Mod-queen/examguard-fpga-k230-voice/sim/readme.md

# 模块仿真对应表

共163个不同自检用例。下表按模块逐个进入；模块关联是静态依赖关系，不是代码行或分支覆盖率。

日志和result.json按当前源码关联。[8张原生波形](waveforms.md)附实际WDB来源；各模块另有VCD仿真波形，来源批次见索引。

| 模块 | 当前工程实例化 | 对应自检数 |
| --- | --- | ---: |
| [DVP_Capture](modules/dvp_capture.md) | 是 | 2 |
| [ai_link_rx](modules/ai_link_rx.md) | 是 | 1 |
| [ai_mailbox](modules/ai_mailbox.md) | 是 | 1 |
| [alarm_beep](modules/alarm_beep.md) | 是 | 1 |
| [alarm_output](modules/alarm_output.md) | 否 | 1 |
| [async_fifo](modules/async_fifo.md) | 是 | 19 |
| [axi4_to_fifo](modules/axi4_to_fifo.md) | 否 | 1 |
| [axi_2client_arbiter](modules/axi_2client_arbiter.md) | 是 | 7 |
| [axi_read_burst_buffer](modules/axi_read_burst_buffer.md) | 是 | 5 |
| [board_monitor_record](modules/board_monitor_record.md) | 是 | 3 |
| [board_status_control](modules/board_status_control.md) | 是 | 1 |
| [camera_black_gate](modules/camera_black_gate.md) | 是 | 5 |
| [camera_evidence_client](modules/camera_evidence_client.md) | 否 | 4 |
| [camera_evidence_transport](modules/camera_evidence_transport.md) | 否 | 2 |
| [camera_frame_guard](modules/camera_frame_guard.md) | 否 | 9 |
| [camera_init](modules/camera_init.md) | 是 | 2 |
| [camera_sample_guard](modules/camera_sample_guard.md) | 否 | 6 |
| [camera_time_guard](modules/camera_time_guard.md) | 否 | 4 |
| [candidate_glyph](modules/candidate_glyph.md) | 否 | 3 |
| [candidate_overlay](modules/candidate_overlay.md) | 是 | 3 |
| [cdc_byte_channel](modules/cdc_byte_channel.md) | 否 | 1 |
| [cdc_event_transaction](modules/cdc_event_transaction.md) | 是 | 15 |
| [cdc_exam_status](modules/cdc_exam_status.md) | 是 | 1 |
| [cdc_frame_activity](modules/cdc_frame_activity.md) | 是 | 1 |
| [cdc_stats_snapshot](modules/cdc_stats_snapshot.md) | 是 | 7 |
| [cdc_time_snapshot](modules/cdc_time_snapshot.md) | 是 | 5 |
| [char_rom](modules/char_rom.md) | 否 | 0 |
| [char_rom_cn](modules/char_rom_cn.md) | 是 | 2 |
| [color_enhance](modules/color_enhance.md) | 是 | 2 |
| [config_ack_tx](modules/config_ack_tx.md) | 是 | 2 |
| [config_mailbox](modules/config_mailbox.md) | 是 | 1 |
| [config_rx](modules/config_rx.md) | 否 | 1 |
| [crc32_d8](modules/crc32_d8.md) | 是 | 4 |
| [ddr3_axi_frame_dma](modules/ddr3_axi_frame_dma.md) | 是 | 20 |
| [ddr3_ctrl_2port](modules/ddr3_ctrl_2port.md) | 否 | 0 |
| [ddr3_shared_video_ctrl](modules/ddr3_shared_video_ctrl.md) | 是 | 1 |
| [ddr_evidence_axi](modules/ddr_evidence_axi.md) | 否 | 11 |
| [ddr_evidence_queued](modules/ddr_evidence_queued.md) | 否 | 8 |
| [disp_driver](modules/disp_driver.md) | 是 | 2 |
| [dvi_encoder](modules/dvi_encoder.md) | 是 | 1 |
| [eeprom_dualslot_store](modules/eeprom_dualslot_store.md) | 是 | 6 |
| [eeprom_page_writer](modules/eeprom_page_writer.md) | 是 | 8 |
| [eeprom_record_codec](modules/eeprom_record_codec.md) | 是 | 7 |
| [encode](modules/encode.md) | 是 | 2 |
| [eth_udp_tx_gmii](modules/eth_udp_tx_gmii.md) | 是 | 4 |
| [event_identity](modules/event_identity.md) | 是 | 8 |
| [event_meta_ring](modules/event_meta_ring.md) | 是 | 1 |
| [event_request_fifo](modules/event_request_fifo.md) | 是 | 10 |
| [event_transaction_fork](modules/event_transaction_fork.md) | 是 | 3 |
| [event_transaction_log](modules/event_transaction_log.md) | 是 | 3 |
| [event_transaction_queue](modules/event_transaction_queue.md) | 是 | 7 |
| [evidence_byte_mux](modules/evidence_byte_mux.md) | 是 | 1 |
| [evidence_dump](modules/evidence_dump.md) | 是 | 2 |
| [evidence_epoch_identity](modules/evidence_epoch_identity.md) | 是 | 3 |
| [evidence_event_dispatch](modules/evidence_event_dispatch.md) | 否 | 9 |
| [evidence_health_telemetry](modules/evidence_health_telemetry.md) | 是 | 3 |
| [evidence_packet_cdc](modules/evidence_packet_cdc.md) | 是 | 6 |
| [evidence_packet_udp_bridge](modules/evidence_packet_udp_bridge.md) | 是 | 8 |
| [evidence_reset_barrier](modules/evidence_reset_barrier.md) | 是 | 13 |
| [evidence_window_packetizer](modules/evidence_window_packetizer.md) | 是 | 5 |
| [exam_event_context](modules/exam_event_context.md) | 是 | 3 |
| [exam_fsm](modules/exam_fsm.md) | 是 | 9 |
| [fifo_axi4_adapter](modules/fifo_axi4_adapter.md) | 否 | 0 |
| [fifo_to_axi4](modules/fifo_to_axi4.md) | 否 | 1 |
| [fullscreen_monitor](modules/fullscreen_monitor.md) | 是 | 1 |
| [gmii_to_rgmii](modules/gmii_to_rgmii.md) | 是 | 1 |
| [hc595_driver](modules/hc595_driver.md) | 是 | 1 |
| [health_monitor](modules/health_monitor.md) | 是 | 1 |
| [hex8](modules/hex8.md) | 是 | 1 |
| [history_axi_epoch_guard](modules/history_axi_epoch_guard.md) | 是 | 3 |
| [history_capture_client](modules/history_capture_client.md) | 是 | 1 |
| [history_capture_source](modules/history_capture_source.md) | 是 | 6 |
| [history_closed_scheduler](modules/history_closed_scheduler.md) | 是 | 2 |
| [history_descriptor_reader](modules/history_descriptor_reader.md) | 是 | 8 |
| [history_frame_writer](modules/history_frame_writer.md) | 是 | 6 |
| [history_gap_journal](modules/history_gap_journal.md) | 是 | 5 |
| [history_health_stats](modules/history_health_stats.md) | 是 | 1 |
| [history_lifecycle_control](modules/history_lifecycle_control.md) | 是 | 3 |
| [history_ordered_ingress](modules/history_ordered_ingress.md) | 是 | 3 |
| [history_reference_directory](modules/history_reference_directory.md) | 是 | 9 |
| [history_result_fork](modules/history_result_fork.md) | 是 | 1 |
| [history_result_record](modules/history_result_record.md) | 是 | 4 |
| [history_result_udp_bridge](modules/history_result_udp_bridge.md) | 否 | 2 |
| [history_result_udp_cdc](modules/history_result_udp_cdc.md) | 否 | 1 |
| [history_sample_source](modules/history_sample_source.md) | 是 | 4 |
| [history_scheduled_store](modules/history_scheduled_store.md) | 是 | 2 |
| [history_startup_gate](modules/history_startup_gate.md) | 是 | 2 |
| [history_store_axi](modules/history_store_axi.md) | 是 | 5 |
| [history_stream_cdc](modules/history_stream_cdc.md) | 是 | 3 |
| [history_stream_epoch](modules/history_stream_epoch.md) | 是 | 3 |
| [history_window_reader](modules/history_window_reader.md) | 是 | 6 |
| [i2c_bit_shift](modules/i2c_bit_shift.md) | 是 | 1 |
| [i2c_byte_master](modules/i2c_byte_master.md) | 是 | 9 |
| [i2c_control](modules/i2c_control.md) | 是 | 1 |
| [i2c_register_master](modules/i2c_register_master.md) | 是 | 8 |
| [i2c_transaction_arbiter](modules/i2c_transaction_arbiter.md) | 是 | 5 |
| [image_downsampler](modules/image_downsampler.md) | 否 | 1 |
| [image_evidence_capture](modules/image_evidence_capture.md) | 否 | 1 |
| [image_evidence_ring](modules/image_evidence_ring.md) | 否 | 2 |
| [image_evidence_udp_acx750_tx](modules/image_evidence_udp_acx750_tx.md) | 否 | 0 |
| [image_evidence_udp_packetizer](modules/image_evidence_udp_packetizer.md) | 否 | 2 |
| [image_evidence_udp_source](modules/image_evidence_udp_source.md) | 否 | 1 |
| [image_evidence_udp_tx_bridge](modules/image_evidence_udp_tx_bridge.md) | 否 | 1 |
| [ip_checksum](modules/ip_checksum.md) | 是 | 4 |
| [key_debounce](modules/key_debounce.md) | 是 | 2 |
| [maintenance_command_rx](modules/maintenance_command_rx.md) | 是 | 2 |
| [maintenance_endpoint](modules/maintenance_endpoint.md) | 是 | 2 |
| [maintenance_record](modules/maintenance_record.md) | 是 | 3 |
| [mdio_bit_shift](modules/mdio_bit_shift.md) | 是 | 2 |
| [motion_detect](modules/motion_detect.md) | 是 | 1 |
| [ov5640_ddr3_hdmi_vga](modules/ov5640_ddr3_hdmi_vga.md) | 否 | 0 |
| [ov5640_init_table_jpeg](modules/ov5640_init_table_jpeg.md) | 否 | 2 |
| [ov5640_init_table_rgb](modules/ov5640_init_table_rgb.md) | 是 | 2 |
| [ov7725_init_table_rgb](modules/ov7725_init_table_rgb.md) | 否 | 2 |
| [overlay_status](modules/overlay_status.md) | 是 | 1 |
| [pcf8563_calendar](modules/pcf8563_calendar.md) | 否 | 10 |
| [pcf8563_reader](modules/pcf8563_reader.md) | 是 | 9 |
| [pcf8563_setter](modules/pcf8563_setter.md) | 是 | 4 |
| [persistent_boot_gate](modules/persistent_boot_gate.md) | 是 | 5 |
| [persistent_boot_service](modules/persistent_boot_service.md) | 否 | 1 |
| [persistent_config_decode](modules/persistent_config_decode.md) | 是 | 4 |
| [persistent_config_manager](modules/persistent_config_manager.md) | 是 | 3 |
| [persistent_event_identity](modules/persistent_event_identity.md) | 是 | 2 |
| [persistent_maintenance_service](modules/persistent_maintenance_service.md) | 是 | 2 |
| [persistent_rtc_service](modules/persistent_rtc_service.md) | 否 | 1 |
| [phy_health_snapshot](modules/phy_health_snapshot.md) | 是 | 1 |
| [phy_reg_config](modules/phy_reg_config.md) | 是 | 1 |
| [pulse_cdc](modules/pulse_cdc.md) | 是 | 1 |
| [rtc_anchor_client](modules/rtc_anchor_client.md) | 是 | 5 |
| [rtc_anchor_record](modules/rtc_anchor_record.md) | 是 | 7 |
| [rtc_time_anchor](modules/rtc_time_anchor.md) | 是 | 6 |
| [serdes_4b_10to1](modules/serdes_4b_10to1.md) | 是 | 2 |
| [shared_xadc_monitor](modules/shared_xadc_monitor.md) | 是 | 1 |
| [sim_dat_gen](modules/sim_dat_gen.md) | 否 | 0 |
| [status_mailbox](modules/status_mailbox.md) | 是 | 1 |
| [status_uart_tx](modules/status_uart_tx.md) | 是 | 4 |
| [text_overlay](modules/text_overlay.md) | 是 | 2 |
| [timestamp_ms](modules/timestamp_ms.md) | 是 | 1 |
| [u32_to_bcd](modules/u32_to_bcd.md) | 是 | 5 |
| [uart_packet_mux](modules/uart_packet_mux.md) | 是 | 4 |
| [uart_rx](modules/uart_rx.md) | 是 | 1 |
| [uart_stream_adapter](modules/uart_stream_adapter.md) | 是 | 7 |
| [uart_tx](modules/uart_tx.md) | 是 | 12 |
| [user_control](modules/user_control.md) | 是 | 1 |
| [video_axi_client](modules/video_axi_client.md) | 是 | 7 |
| [video_epoch_clear](modules/video_epoch_clear.md) | 是 | 7 |
| [video_fifo_axi_port](modules/video_fifo_axi_port.md) | 是 | 4 |
| [video_fifo_stream_bridge](modules/video_fifo_stream_bridge.md) | 是 | 6 |
| [video_memory_fabric](modules/video_memory_fabric.md) | 是 | 4 |
| [voice_announcer](modules/voice_announcer.md) | 否 | 1 |
| [voice_asr_i2c](modules/voice_asr_i2c.md) | 否 | 1 |
| [voice_audio_gate](modules/voice_audio_gate.md) | 是 | 2 |
| [voice_command_map](modules/voice_command_map.md) | 否 | 1 |
| [voice_exam_interaction](modules/voice_exam_interaction.md) | 是 | 2 |
| [voice_host_endpoint](modules/voice_host_endpoint.md) | 是 | 2 |
| [voice_info_confirm](modules/voice_info_confirm.md) | 是 | 3 |
| [voice_interaction_bus](modules/voice_interaction_bus.md) | 是 | 2 |
| [voice_interaction_system](modules/voice_interaction_system.md) | 是 | 1 |
| [voice_notice_queue](modules/voice_notice_queue.md) | 是 | 2 |
| [voice_status_record](modules/voice_status_record.md) | 是 | 2 |
| [workflow_fsm](modules/workflow_fsm.md) | 否 | 1 |
| [xadc_monitor_reader](modules/xadc_monitor_reader.md) | 是 | 2 |
| [display_output_pipeline](modules/display_output_pipeline.md) | 是 | 2 |
