Mod-queen/examguard-fpga-k230-voice/sim/modules/i2c_byte_master.md

# i2c_byte_master

当前工程实例化：是。关联9个自检用例。

| 用例 | 仿真器 | 当前结果 | 运行日志 | 结果记录 |
| --- | --- | --- | --- | --- |
| i2c_byte_master_tb | icarus | 通过 | [日志](../../sim/results/quality_current/i2c_byte_master_tb/run.log) | [记录](../../sim/results/quality_current/i2c_byte_master_tb/result.json) |
| i2c_register_master_tb | icarus | 通过 | [日志](../../sim/results/quality_current/i2c_register_master_tb/run.log) | [记录](../../sim/results/quality_current/i2c_register_master_tb/result.json) |
| maintenance_system_tb | xsim | 通过 | [日志](../../sim/results/quality_current/maintenance_system_tb/run.log) | [记录](../../sim/results/quality_current/maintenance_system_tb/result.json) |
| pcf8563_setter_wire_tb | icarus | 通过 | [日志](../../sim/results/quality_current/pcf8563_setter_wire_tb/run.log) | [记录](../../sim/results/quality_current/pcf8563_setter_wire_tb/result.json) |
| persistent_boot_probe_tb | xsim | 通过 | [日志](../../sim/results/quality_current/persistent_boot_probe_tb/run.log) | [记录](../../sim/results/quality_current/persistent_boot_probe_tb/result.json) |
| persistent_boot_service_tb | xsim | 通过 | [日志](../../sim/results/quality_current/persistent_boot_service_tb/run.log) | [记录](../../sim/results/quality_current/persistent_boot_service_tb/result.json) |
| persistent_maintenance_service_tb | icarus | 通过 | [日志](../../sim/results/quality_current/persistent_maintenance_service_tb/run.log) | [记录](../../sim/results/quality_current/persistent_maintenance_service_tb/result.json) |
| voice_interaction_bus_tb | icarus | 通过 | [日志](../../sim/results/quality_current/voice_interaction_bus_tb/run.log) | [记录](../../sim/results/quality_current/voice_interaction_bus_tb/result.json) |
| voice_interaction_system_tb | xsim | 通过 | [日志](../../sim/results/quality_current/voice_interaction_system_tb/run.log) | [记录](../../sim/results/quality_current/voice_interaction_system_tb/result.json) |

单独重跑本模块关联用例（工程根目录）：

```powershell
python sim/run_module_tests.py --only i2c_byte_master_tb i2c_register_master_tb maintenance_system_tb pcf8563_setter_wire_tb persistent_boot_probe_tb persistent_boot_service_tb persistent_maintenance_service_tb voice_interaction_bus_tb voice_interaction_system_tb --vivado-bin "$env:EXAMGUARD_VIVADO_BIN" --iverilog-bin "$env:EXAMGUARD_IVERILOG_BIN"
```

先按[复原说明](../../build/reproduction.md)配置工具。每次生成新的结果目录。

## i2c_byte_master_tb

用例源码：[i2c_byte_master_tb.sv](../../sim/sources/persistence/i2c_byte_master_tb.sv)

VCD仿真波形（来源批次见索引）：

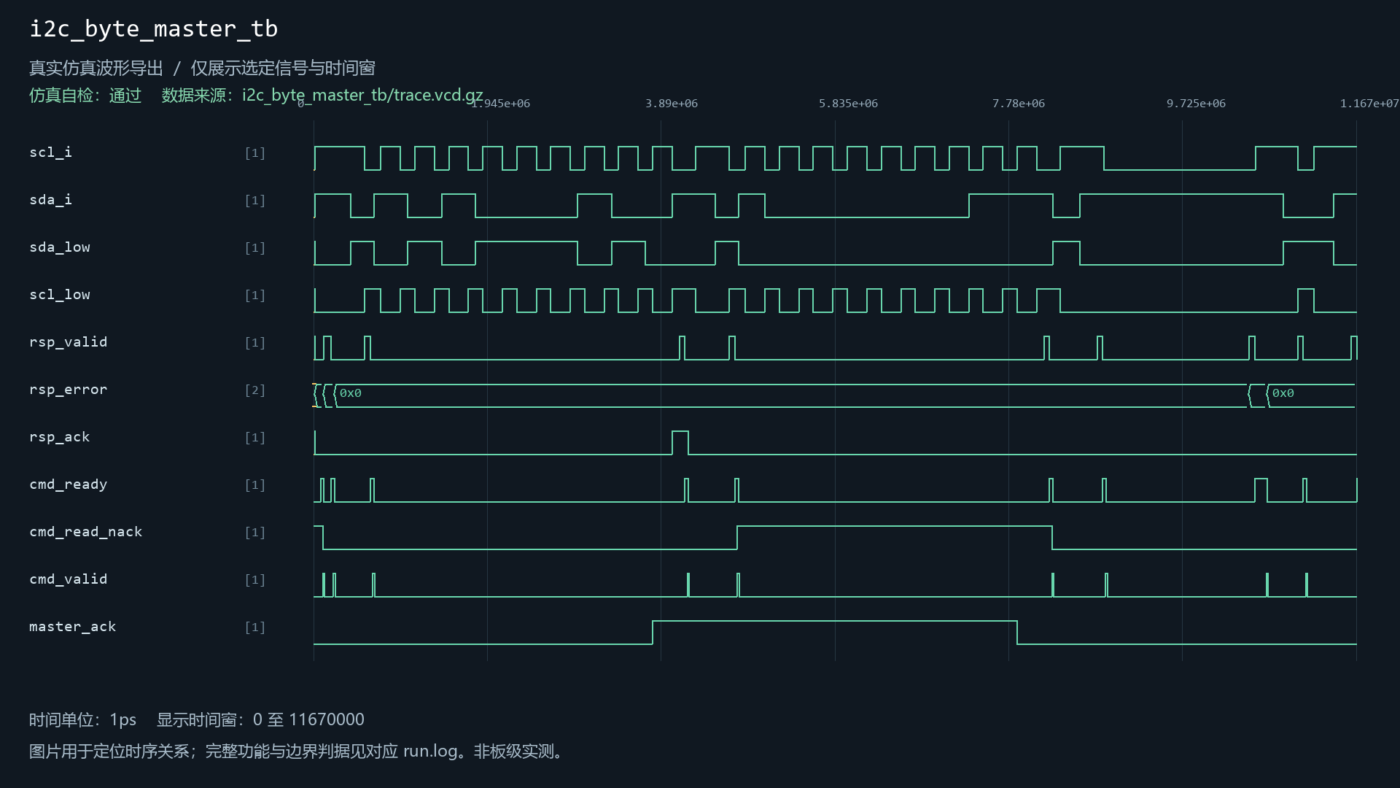
[picture p60: sim/images/i2c_byte_master_tb.png]
i2c_byte_master_tb


## i2c_register_master_tb

用例源码：[i2c_register_master_tb.sv](../../sim/sources/persistence/i2c_register_master_tb.sv), [persistence_inventory_probe.sv](../../sim/sources/persistence/persistence_inventory_probe.sv)

VCD仿真波形（来源批次见索引）：

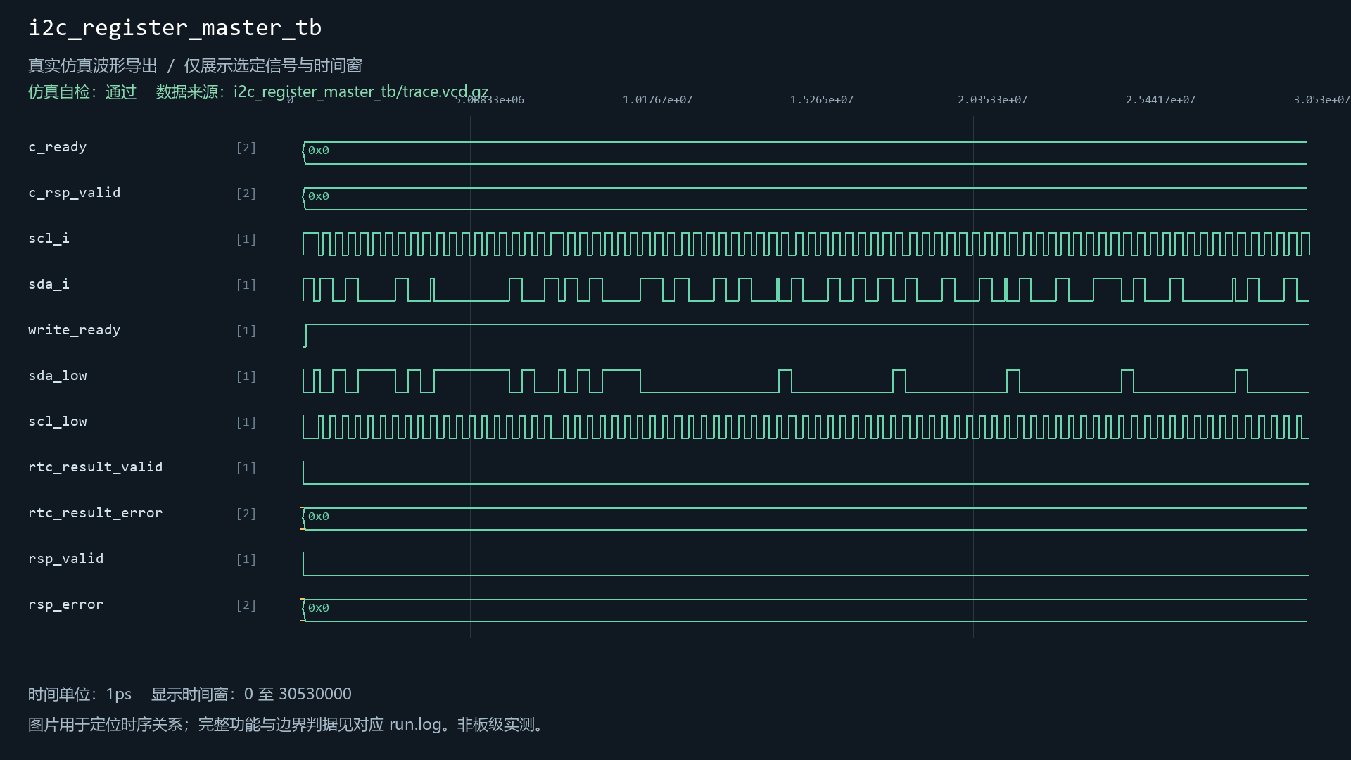
[picture p61: sim/images/i2c_register_master_tb.png]
i2c_register_master_tb


## maintenance_system_tb

用例源码：[maintenance_system_tb.sv](../../sim/test_repairs/maintenance_system_tb/maintenance_system_tb.sv)

VCD仿真波形（来源批次见索引）：

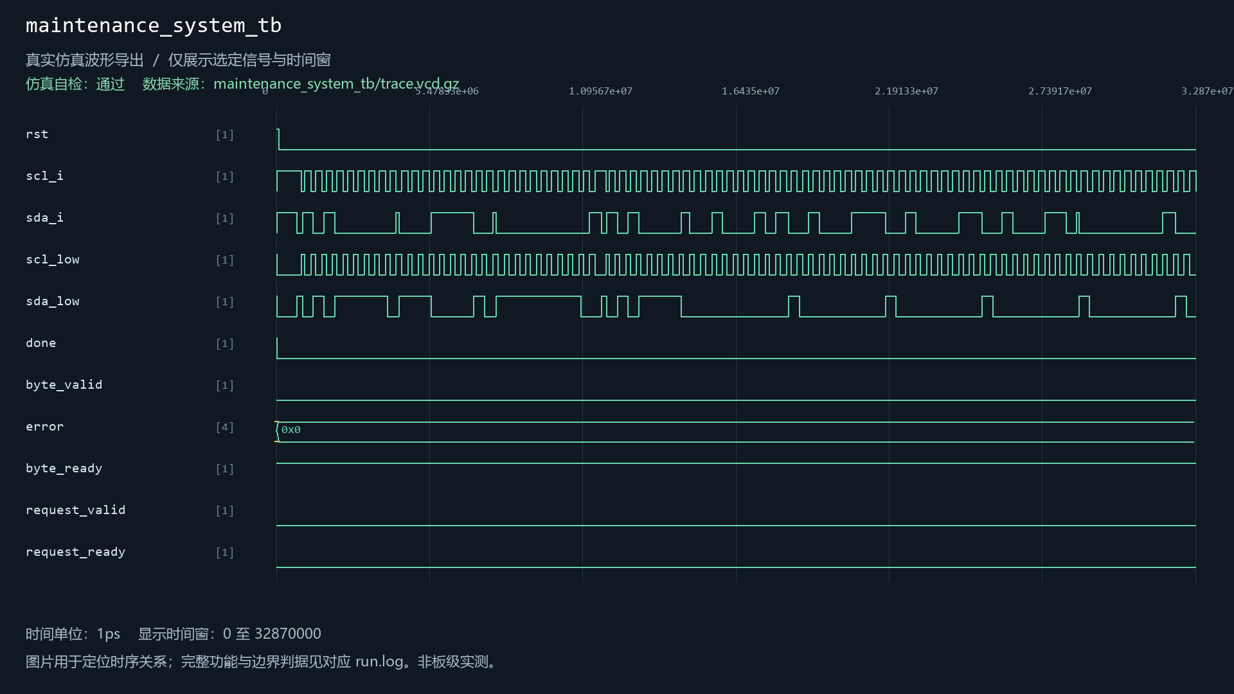
[picture p62: sim/images/maintenance_system_tb.png]
maintenance_system_tb


## pcf8563_setter_wire_tb

用例源码：[pcf8563_setter_wire_tb.sv](../../sim/sources/persistence/pcf8563_setter_wire_tb.sv)

VCD仿真波形（来源批次见索引）：

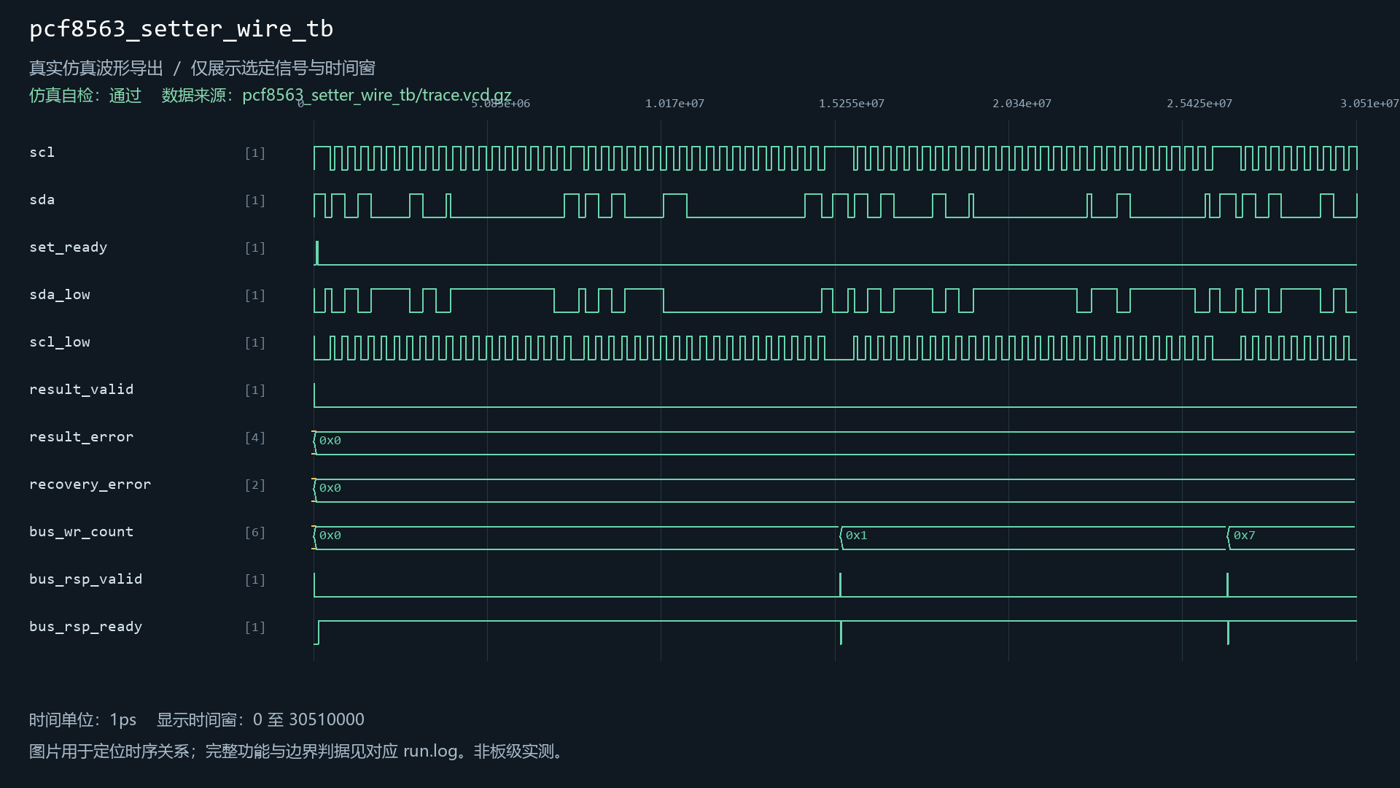
[picture p63: sim/images/pcf8563_setter_wire_tb.png]
pcf8563_setter_wire_tb


## persistent_boot_probe_tb

用例源码：[persistent_boot_probe_tb.sv](../../sim/sources/persistence/persistent_boot_probe_tb.sv), [persistence_inventory_probe.sv](../../sim/sources/persistence/persistence_inventory_probe.sv), [persistent_boot_probe.sv](../../sim/sources/persistence/persistent_boot_probe.sv)

VCD仿真波形（来源批次见索引）：

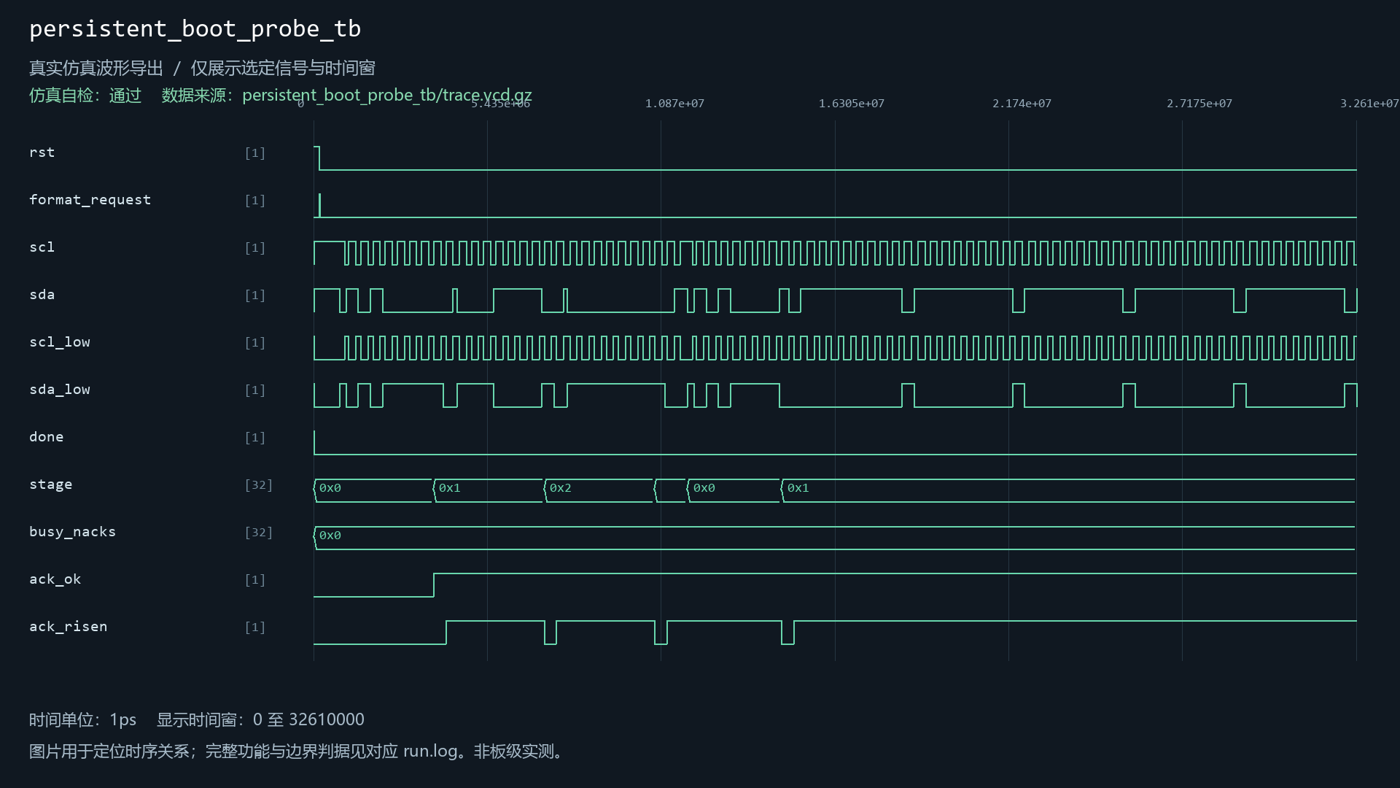
[picture p64: sim/images/persistent_boot_probe_tb.png]
persistent_boot_probe_tb


## persistent_boot_service_tb

用例源码：[persistent_boot_service_tb.sv](../../sim/sources/persistence/persistent_boot_service_tb.sv)

VCD仿真波形（来源批次见索引）：

persistent_boot_service_tb

## persistent_maintenance_service_tb

用例源码：[persistent_maintenance_service_tb.sv](../../sim/sources/persistence/persistent_maintenance_service_tb.sv)

VCD仿真波形（来源批次见索引）：

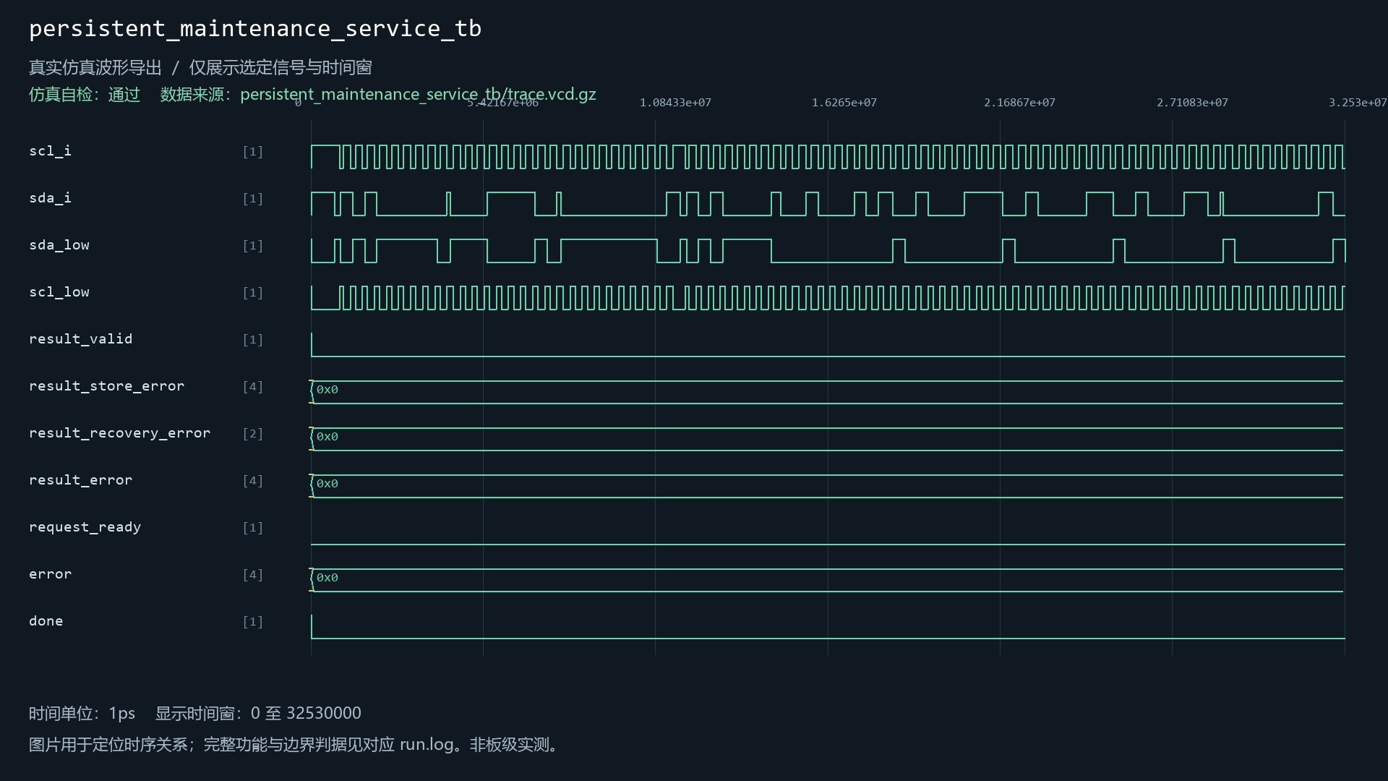
[picture p65: sim/images/persistent_maintenance_service_tb.png]
persistent_maintenance_service_tb


## voice_interaction_bus_tb

用例源码：[voice_interaction_bus_tb.sv](../../sim/sources/voice_interaction/voice_interaction_bus_tb.sv)

VCD仿真波形（来源批次见索引）：

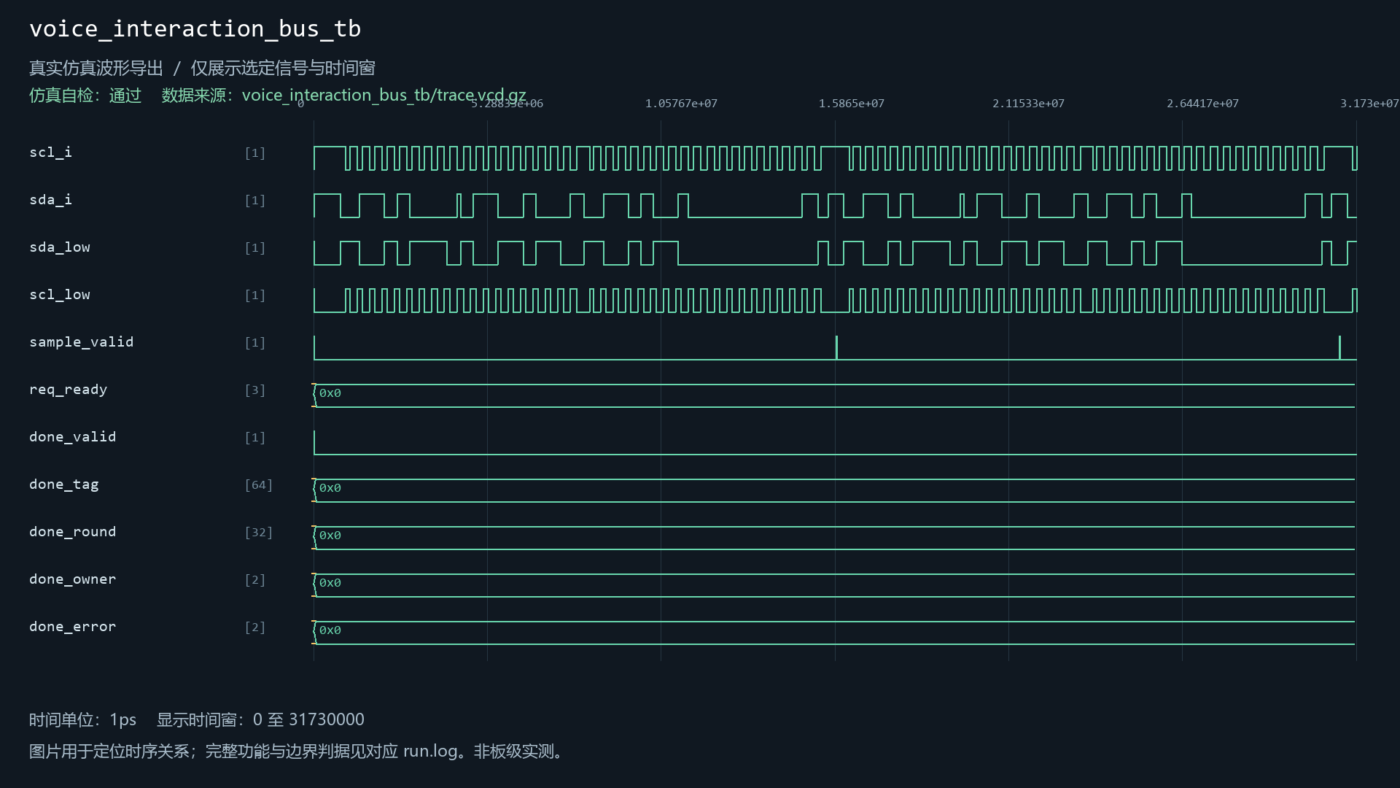
[picture p66: sim/images/voice_interaction_bus_tb.png]
voice_interaction_bus_tb


## voice_interaction_system_tb

用例源码：[voice_interaction_system_tb.sv](../../sim/sources/voice_interaction/voice_interaction_system_tb.sv), [wonderecho_wire_model.sv](../../sim/sources/voice_interaction/wonderecho_wire_model.sv)

VCD仿真波形（来源批次见索引）：

voice_interaction_system_tb
