Mod-queen/examguard-fpga-k230-voice/sim/modules/uart_stream_adapter.md

# uart_stream_adapter

当前工程实例化：是。关联7个自检用例。

| 用例 | 仿真器 | 当前结果 | 运行日志 | 结果记录 |
| --- | --- | --- | --- | --- |
| config_ack_tx_tb | icarus | 通过 | [日志](../../sim/results/quality_current/config_ack_tx_tb/run.log) | [记录](../../sim/results/quality_current/config_ack_tx_tb/result.json) |
| evidence_dump_tb | icarus | 通过 | [日志](../../sim/results/quality_current/evidence_dump_tb/run.log) | [记录](../../sim/results/quality_current/evidence_dump_tb/result.json) |
| history_health_stats_tb | icarus | 通过 | [日志](../../sim/results/quality_current/history_health_stats_tb/run.log) | [记录](../../sim/results/quality_current/history_health_stats_tb/result.json) |
| status_uart_health_tb | xsim | 通过 | [日志](../../sim/results/quality_current/status_uart_health_tb/run.log) | [记录](../../sim/results/quality_current/status_uart_health_tb/result.json) |
| status_uart_timer_tb | icarus | 通过 | [日志](../../sim/results/quality_current/status_uart_timer_tb/run.log) | [记录](../../sim/results/quality_current/status_uart_timer_tb/result.json) |
| transaction_uart_integration_tb | xsim | 通过 | [日志](../../sim/results/quality_current/transaction_uart_integration_tb/run.log) | [记录](../../sim/results/quality_current/transaction_uart_integration_tb/result.json) |
| uart_stream_adapter_tb | icarus | 通过 | [日志](../../sim/results/quality_current/uart_stream_adapter_tb/run.log) | [记录](../../sim/results/quality_current/uart_stream_adapter_tb/result.json) |

单独重跑本模块关联用例（工程根目录）：

```powershell
python sim/run_module_tests.py --only config_ack_tx_tb evidence_dump_tb history_health_stats_tb status_uart_health_tb status_uart_timer_tb transaction_uart_integration_tb uart_stream_adapter_tb --vivado-bin "$env:EXAMGUARD_VIVADO_BIN" --iverilog-bin "$env:EXAMGUARD_IVERILOG_BIN"
```

先按[复原说明](../../build/reproduction.md)配置工具。每次生成新的结果目录。

## config_ack_tx_tb

用例源码：[config_ack_tx_tb.v](../../src/fpga/ov5640_ddr3_hdmi_vga.srcs/sources_1/host_link/config_ack_tx_tb.v)

VCD仿真波形（来源批次见索引）：

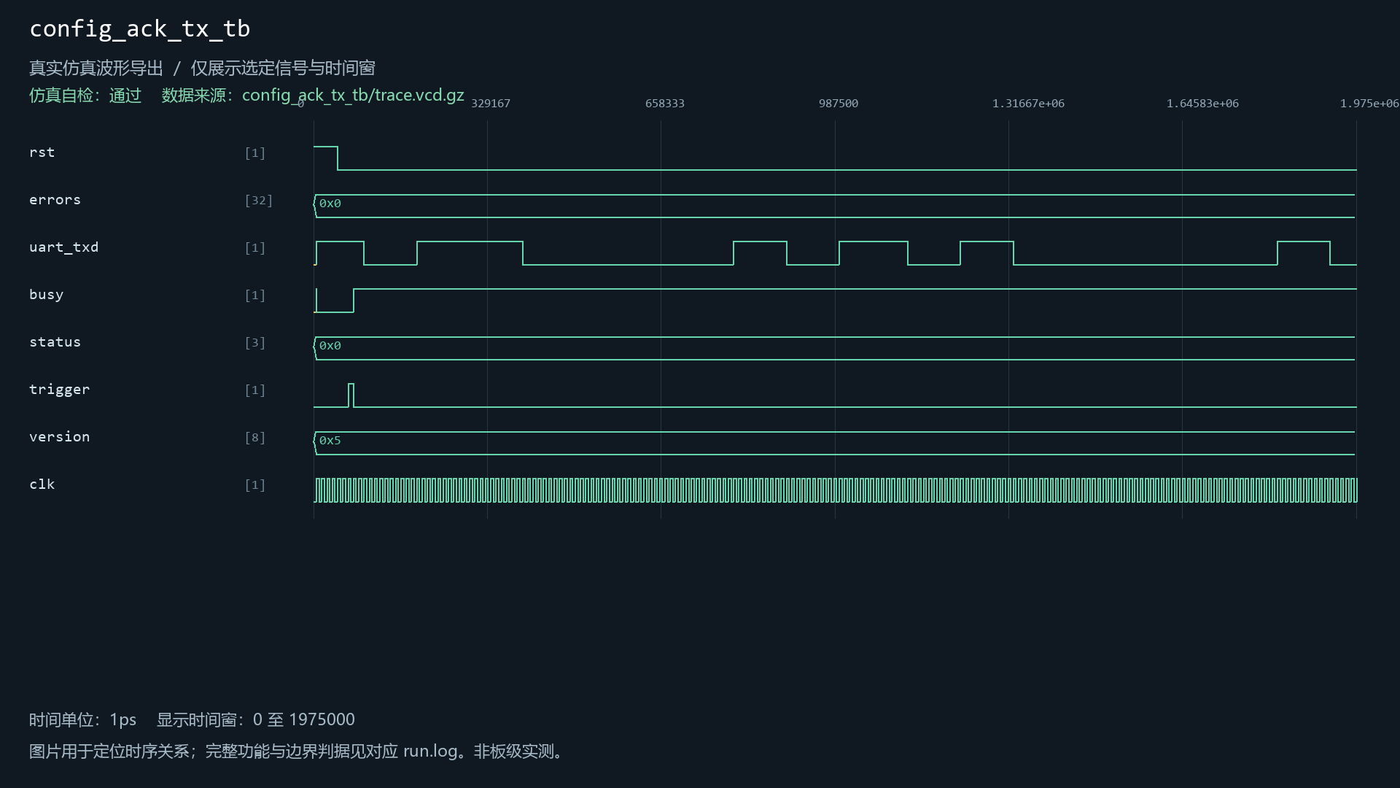
[picture p74: sim/images/config_ack_tx_tb.png]
config_ack_tx_tb


## evidence_dump_tb

用例源码：[evidence_dump_tb.v](../../src/fpga/ov5640_ddr3_hdmi_vga.srcs/sources_1/evidence_dump/evidence_dump_tb.v)

VCD仿真波形（来源批次见索引）：

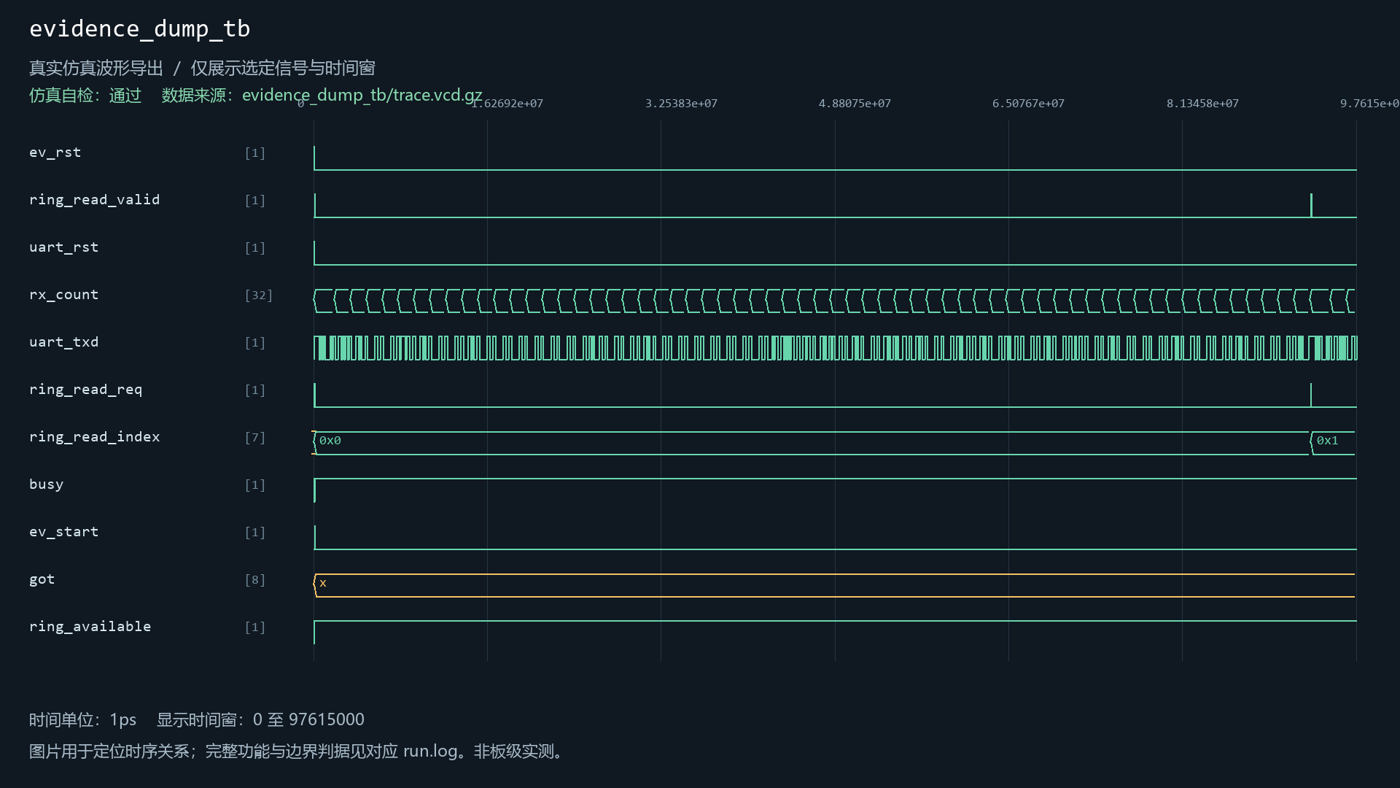
[picture p75: sim/images/evidence_dump_tb.png]
evidence_dump_tb


## history_health_stats_tb

用例源码：[history_health_stats_tb.sv](../../sim/sources/health/history_health_stats_tb.sv)

VCD仿真波形（来源批次见索引）：

history_health_stats_tb

## status_uart_health_tb

用例源码：[status_uart_health_tb.sv](../../sim/sources/health/status_uart_health_tb.sv)

VCD仿真波形（来源批次见索引）：

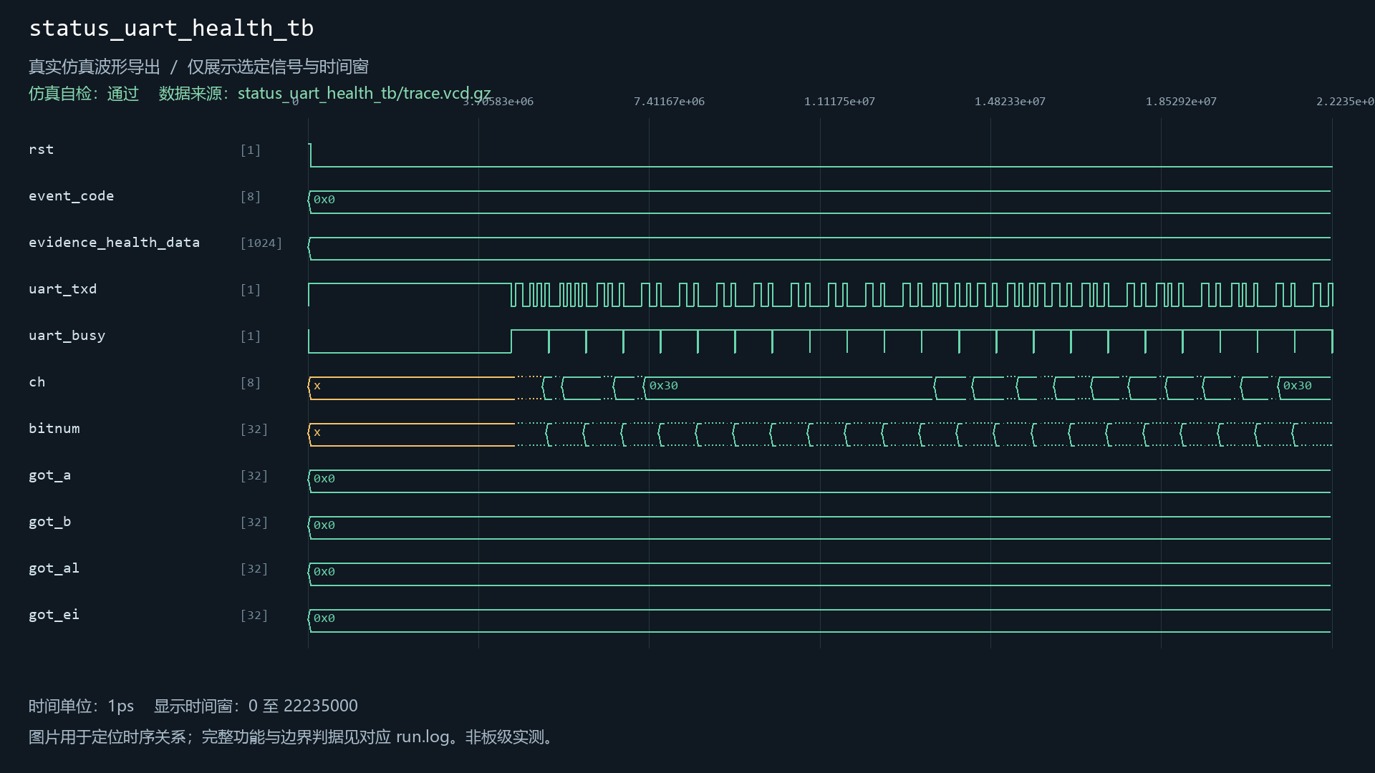
[picture p76: sim/images/status_uart_health_tb.png]
status_uart_health_tb


## status_uart_timer_tb

用例源码：[status_uart_timer_tb.sv](../../sim/sources/event_identity/status_uart_timer_tb.sv)

VCD仿真波形（来源批次见索引）：

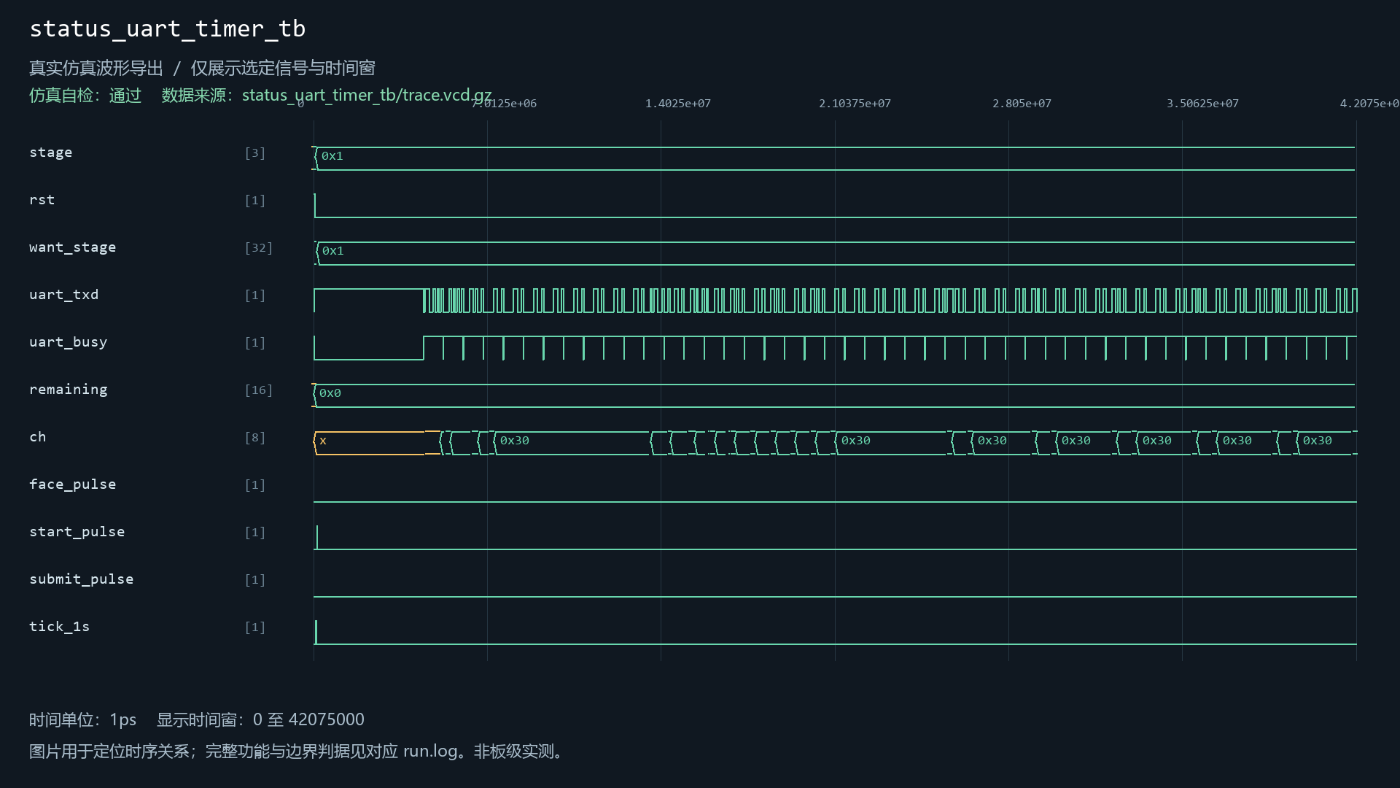
[picture p77: sim/images/status_uart_timer_tb.png]
status_uart_timer_tb


## transaction_uart_integration_tb

用例源码：[transaction_uart_integration_tb.sv](../../sim/sources/host_link/transaction_uart_integration_tb.sv)

本用例提供上方日志和机器可读结果；尚无截图，不用其他模块图片替代。

## uart_stream_adapter_tb

用例源码：[uart_stream_adapter_tb.sv](../../sim/sources/host_link/uart_stream_adapter_tb.sv)

VCD仿真波形（来源批次见索引）：

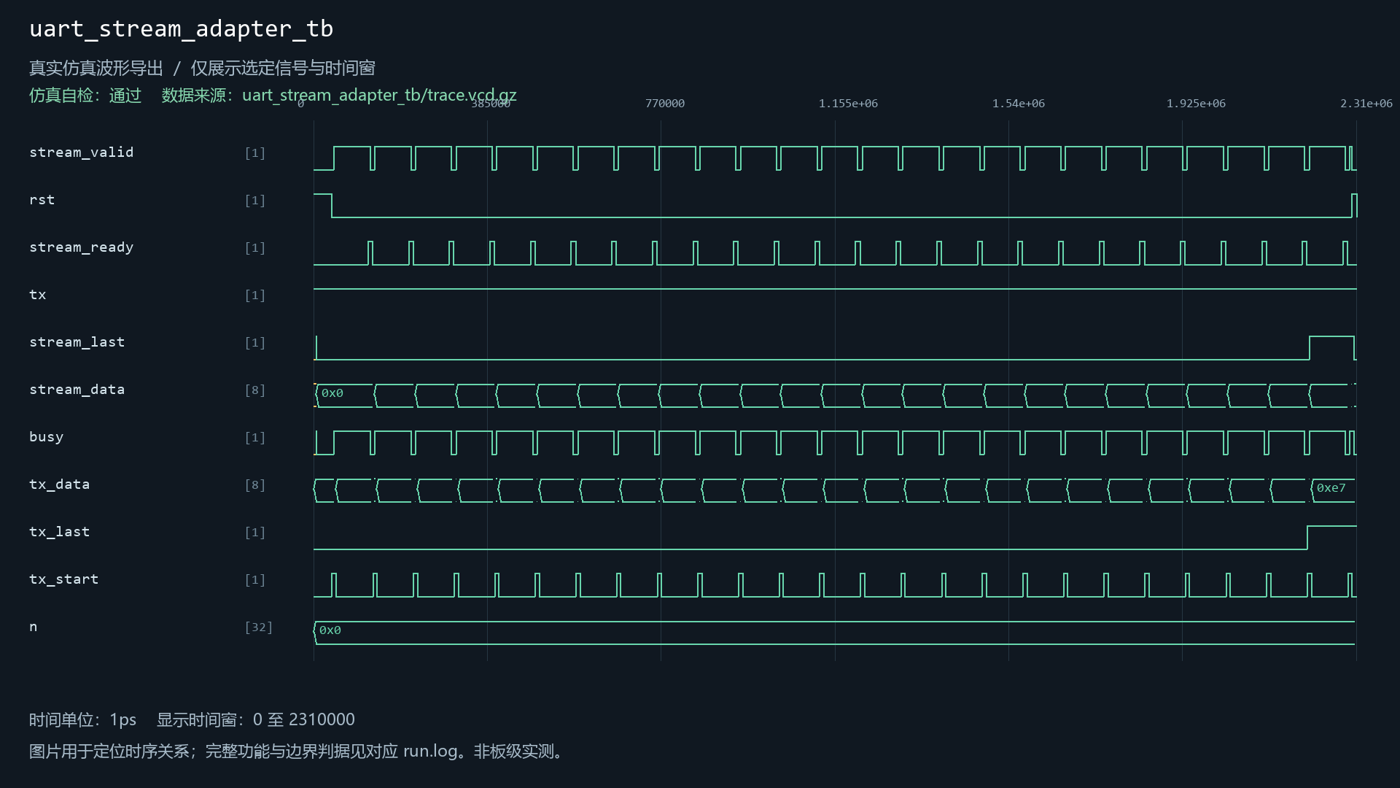
[picture p78: sim/images/uart_stream_adapter_tb.png]
uart_stream_adapter_tb
