Mod-queen/examguard-fpga-k230-voice/data/readme.md

# 数据与设计导航

| 内容 | 入口 |
| --- | --- |
| FPGA和双摄像头 | [架构](architecture.md) · [通信](communication.md) |
| 摄像头与识别算法 | [算法](algorithms.md) |
| 数据集、训练曲线和框图 | [视觉记录](recognition.md) |
| Agent、JoyCode与网页 | [复核应用](review_workflow.md) |
| 原始训练记录 | [model_records](model_records) |

实物结构、训练标注和K230识别图见showcase，来源和变换另有索引。真实考场采集库、私有人脸库、API密钥和网页密码由使用者本机保存。
