Mod-queen/examguard-fpga-k230-voice/board/fpga/readme.md

当前位流和Flash镜像统一位于根目录的[bit文件夹](../../bit/readme.md)。历史记录保留原生成时的路径和哈希。
