Mod-queen/examguard-fpga-k230-voice/build/reports/cdc_review/readme.md

# CDC结构核对

本目录对应已固化语音修复版。默认报告18项Critical；补充全端点检查为26项Critical。检查选项不同，不能把26误写为新增回归，也不能说已经清零。

逐条端点、RTL结构和核对意见见structure_review.tsv；原始报告与JSON均保留。已定位复位组合、DDR就绪同步、MDC分频反馈及FIFO异步读出四类。没有增加false_path，没有自动豁免。结构说明不是完整硬件签核。

实现内部时序WNS +0.134ns、WHS +0.031ns；外部29输入、48输出仍待板级延迟预算。正裕量不能代替这部分核对。
