Mod-queen/examguard-fpga-k230-voice/report/design_appendix.md

# 设计报告内容导航

优化前后资源和时序对比见[设计报告](design_report.pdf)第10页。大模型协作、自我纠错与技能提炼见第三部分3.4（第12页），环境版本与从零复现步骤见第三部分3.5（第13页）；完整内容均置于第四部分总结之前。

模块验证见第9页，蜂鸣器、八位数码管与语音求助见第5至6页。完整运行入口见[复现说明](../build/reproduction.md)，工具与技能原件见[技能目录](../skill/readme.md)。
