Mod-queen/examguard-fpga-k230-voice/report/image_requirements.md

# 报告图片说明

本版共18幅图，包含应用总览、设计流程、系统框图、硬件连接、样机、语音求助、考试阶段、历史取证、软件模块、复核流程、上位机、三组原生仿真波形、资源、时序、训练记录及实物采样，无待填图片占位。

图像保存在figures/revised_20261101。截图仅裁剪、等比缩放；手机与紫书保留原检测框，左右转头为实际动作采样。训练拟合、仿真和现场功能结果按原始来源分别说明。
