Mod-queen/examguard-fpga-k230-voice/report/third_party_notices.md

来源与许可统一见根目录的[第三方说明](../third_party_notices.md)。
