Mod-queen/examguard-fpga-k230-voice/report/project_explained.md

# 智察考场工程技术与实现讲解

本说明按照已完成的单考位版本讲解工程用了什么技术、数据怎样一步步变成老师可以回看的记录，以及Agent、JoyCode和网页登录如何工作。它可以用来理解代码、准备答辩和讲解系统，不替代正式技术报告。

## 1 先看懂整个系统在做什么

系统分成K230、FPGA、PC三部分。K230观察考生和桌面，给出身份、物体与头部朝向的候选结果；FPGA接收这些结果，同时采集另一台OV5640相机，维护考试阶段、倒计时、HDMI画面和历史图像；PC把状态、事件和图像保存起来，提供回放、报表、Agent、JoyCode和网页查询。

两台相机各有任务。K230的相机用来识别，OV5640的画面用于HDMI和历史取证。两者不是天然完全重合的画面，所以安装时要尽量对准同一个考位。识别模型出框不代表过程相机一定拍到了同样内容，这也是要保留原始图像供老师复核的原因。

一次完整链路是：看见疑似手机 → K230上报 → FPGA按考试阶段形成事件 → 保留事件前后图像 → PC关联和校验 → 老师查看或向Agent提问 → 必要时转到JoyCode专业复核 → 导出记录。

## 2 工程主要用了哪些技术

硬件逻辑采用Verilog和SystemVerilog，在AMD Artix-7 XC7A200T上实现。这里的代码描述寄存器、状态机、数据通道和接口如何并行工作。FPGA可以一边显示、一边计时、一边存图，而不必等电脑上的对话模型回答。

视频部分用了OV5640相机采集、DDR3缓存与HDMI输出。外部1GiB DDR3承担较大的画面存储，片上小存储用于队列和缓冲。共享存储调度让实时视频和事件历史图像共用一个外部存储控制器，同时保护仍需要回放的历史帧。

通信部分用了硬件串口、千兆以太网和双线外设接口。串口传短小的识别结果、状态与命令，网口传较大的图像，双线接口连接语音、日历时钟和配置存储。不同速度的模块之间通过同步寄存器、缓冲队列和请求确认交换信息，避免直接把变化中的数据跨时钟使用。

视觉部分用了K230的本地推理能力、YOLO类目标检测、独立人脸识别和紫色封面辅助条件。模型把画面变成类别、位置和分数，后续策略再决定是否保留并上报结果。模型不是万能识别器，阈值和连续确认也不能消除全部误报。

电脑端使用Python、Tkinter、SQLite、图像转换和文件校验。Tkinter组织界面；SQLite保存一次会话中的结构化记录；图像文件保存可查看画面；校验值用于检查文件有没有损坏或被换掉。AI接口、MCP和本机HTTP服务建立在这些真实数据之上。

## 3 第一步 让两块板上电后自己运行

FPGA平时掉电后会失去运行配置，因此将已验证的rev03位流写入板卡QSPI Flash。上电后配置电路从Flash加载，恢复HDMI和控制逻辑。此次写入之前保存了两份完整旧镜像，写完又读回全部16MiB，与目标逐字节比较一致；旧版备份仍保留。

K230使用SD卡根目录main.py作为自动入口，等待初始化后进入examguard_book_assist_20261030运行包。这个步骤是选择和启动已有程序，不是重新训练模型。根入口、运行代码、模型和原人脸库分别核对版本，防止只换一份脚本却仍加载错模型。

用户已经确认两块板全部断电再上电后，FPGA的HDMI、启动语音与K230小屏都自动恢复。随后只读监听收到FPGA boot95的连续状态和K230递增识别帧。以后演示只需上电，再打开PC监考台完成联动，不需要每次烧录。

## 4 第二步 让K230把画面变成候选结果

K230先取得640×480画面，按既有训练方式缩放、补边，形成320×320模型输入。正式六类模型包括手机、疑似资料、正向、低头、左转和右转。人脸身份由另一套模块提取特征并与原有人脸库比对，不把头姿类别当作身份。

模型输出的框和分数还要经过后处理。重叠框需要筛选，分数弱的结果要连续出现后才更可信；头姿结合分数、连续次数和持续时间，不能因为一帧没检测到头就认为考生已回正。判断不了时保留未知状态，比编造确定答案更合适。

紫书辅助是复用已有公开训练的手机/书籍模型，找到书籍候选后结合紫色封面条件，只把符合当前目标的候选作为资料线索。这样做针对的是指定紫封面书，不是把所有紫色东西或所有纸张都认成违规资料。普通试卷和答题纸不应报警，衣服、裤子与笔袋不属于目标。

这次没有重训模型。用户确认完整紫封面可以出框，画面基本流畅，资料提示正常；书脊、运动和复杂背景仍可能误报漏报。原先黑裤腿被识别成手机、侧脸缺框的问题，不能因为紫书能识别就宣称全部解决。

最后，程序把身份08、物体14和头姿07等短结果通过115200硬件串口发给FPGA。这里的08、14、07属于识别链路消息，不应与FPGA事件类型0x50、0x51等混为一谈。

## 5 第三步 由FPGA管理考试流程

FPGA用状态机维护自检、候考、已核验、考试、交卷和完成。状态机的作用是规定某一步需要哪些条件，以及条件满足后进入哪里。有人脸结果只是其中一步，还要有正确名册、姓名显示、语音核对、监考员S3授权和准备确认，才能正式开考。

姓名与考号由PC匹配并发给FPGA；HDMI实际显示后才进入相应核对，避免语音已经让考生确认、屏幕却还没更新。语音回复要对应当前轮次，旧回复不能沿用到下一位考生。正式开考产生一次有效触发，倒计时随后运行。

求助使用独立请求编号，电脑处理后回传确认，考中倒计时不停止。这样可以把考生交互与考试计时分别维护。语音模块有自己的交互能力，它不等于PC大语言模型，不能因为能说话就称它是JoyCode。

## 6 第四步 让视频显示与遮挡检测同时工作

OV5640采集画面，经缓存送到HDMI。显示链路输出1280×720有效画面，并叠加考试阶段、倒计时和身份信息。紧凑身份底纹减少了覆盖面积，但不改变姓名考号核对流程。

新版遮挡算法统计相机有效画面的近黑像素。一个像素的红、绿、蓝通道都不大于31时算近黑；一帧至少98%近黑，并连续满足30帧后确认遮挡。恢复连续3帧后释放确认。按60Hz估算，30帧名义约0.5秒，但整条报警链路延迟还受实际画面和处理影响，不能说固定0.5秒或零延迟。

关键在于只数完整的有效相机区域，不把HDMI文字底纹和无效边界混进去。之前遇到过有效像素少算、近黑阈值过严的问题，所以修正时先看真实显示坐标与暗画面，再跑边界验证，最后由用户遮镜头确认。正常摆手不应再因画面变化就被当成镜头遮挡。

## 7 第五步 保留事件前后图像

系统平时就循环保存历史采样，而不是报警后才开始拍。这样事件一出现，才能找回发生之前的过程。历史图像为320×180、RGB565，使用64个循环槽，最多同时维护4个事件窗口；窗口范围为事件前2秒到后2秒。

一张图先写入外部存储，得到写入成功确认后，才发布为有效历史帧。如果过早发布，后面回放可能读到尚未完成的图像。事件出现后，已有前段帧先被引用保护，再继续接纳后段帧；多个重叠事件可以引用同一张图，全部释放前不覆盖该槽。

这里用到了存储接口的请求与响应、历史帧目录和引用计数。可以把它理解为给每张图登记编号、时间和借用次数。旧窗口的迟到请求也要检查身份，不能误操作新窗口。

采样不足、容量不足或读取错误都要留下状态。系统记录缺失比补一张假的完整图片更有价值。默认显示60Hz、每6帧采样一次，名义约10帧/秒；真实完整率和吞吐仍以相应测试为准。

## 8 第六步 PC如何把事件和图像对应起来

PC同时接收几类数据：事件记录ET、图像数据EG和历史采集结果HR。ET说明发生了哪个事件，EG提供像素，HR说明窗口采集与读取情况。只看到一类数据，不能立即宣布整个事件证据齐全。

完整event_ref把设备、启动编号、场次、事件编号和时间等身份组合起来。UID只是事件编号，不同启动或场次可能重复，不能只用UID找图；事件类型也在另一个字段里。曾出现过UID102被模型换成0x66并误说扭头，实际event_code是80即0x50手机，二者没有这种换算关系。

PC分别检查图像分片、帧数、长度、校验值与采集结果，再给出联合完整、部分缺失、等待或当前范围无证据等状态。not_received只表示选定会话与证据目录中未找到可关联证据，不能据此说设备从未采集、PC从未收到或确定UDP丢包。

图像、原始回执和SQLite各自保存。归档时记录SHA256，便于复查文件一致性；哈希一致不等于图像内容证明违规，也不是法律意义上自动成立的取证认证。

## 9 Agent到底增加了什么

原上位机已经能接收、回放和导出，Agent增加的是自然语言入口。老师问“最近有没有手机报警”，不必先知道数据库表和协议字段。Agent把问题转成工具调用，再根据真实结果解释，这一层没有替换原有采集程序。

Agent由五部分组成：用户问题、约束提示词、可调用工具、模型请求循环、界面与导出。提示词说明只能查选定会话、事件都是疑似、不能编造图片或把历史状态当现在在线；工具说明给模型准确的名称、参数和输出含义。

“本地工具演示”与“大模型API”是两种模式。本地模式靠固定规则识别有限问法，可以验证数据和界面，不代表模型联网成功。大模型模式实际请求模型服务，由模型选择工具并解释回执；失败就报告失败，不偷偷用固定回复冒充模型回答。

### 9.1 四个工具分别做什么

get_recent_events按最近多少分钟、事件类型和条数读取所选会话。手机类型为80/0x50，资料为81/0x51，扭头为96/0x60。它返回事件UID、独立类型、时间与完整event_ref。时间范围按PC接收时间，最大1440分钟；超过24小时的旧事件需按完整引用查询，不能改电脑日期来制造近期事件。

check_evidence_status接收完整event_ref，查同一事件的关联结果，返回证据状态、收到帧数、预期帧数与校验信息。预期帧数null表示未知；没有错误计数不等于证据必然齐全。

get_image_path接收同一完整引用，返回已校验图像的路径、索引、时间和哈希。它只返回元数据，并没有自动把像素交给语言模型。最多列32张且display_truncated=true，是展示上限，不应解释成总共只有32张。

get_system_health查最后收到的状态，包括阶段、健康标志、温度和更新时间。存档里的正常仅说明当时上报，数据停更或live_session=false时不能保证设备现在在线。未知温度应保留未知，不填一个看起来合理的数。

### 9.2 一次普通问答怎样运行

第一步，界面取得老师的问题和当前显式选择的数据源。第二步，程序把问题、约束提示词和四个工具定义发给文本模型。第三步，模型返回要调用的工具名称和参数；程序只执行允许的只读工具，不运行模型随意写出的系统命令。

第四步，工具从真实会话和目录读取结果。第五步，程序把回执作为工具结果交回模型，让模型总结为老师能读懂的话。第六步，界面同时显示回答、事件列表与核验记录，便于检查回答有没有真实依据。若模型还需补查，可以再走一轮，但有轮数、调用次数和时间上限。

例如，问题是“最近1440分钟有没有手机报警”。模型先调用get_recent_events筛选类型80；若有结果，就取最新一条的完整event_ref，再调用证据状态和图像工具；最终回复某时有疑似手机线索、证据是否齐全、哪些图像可看，而不是直接说考生作弊。

单次最多6次工具调用，所以演示语句每次只核对一条。若要求同时复核很多事件，可能触发保护。此时拆成查询列表、核对单条等短问题，比放开无限循环更便于说明和核对。

### 9.3 文本模型与视觉模型怎样分工

当前文本配置为glm-4.7-flash，负责选工具和解释文字回执；视觉配置为glm-4.6v-flash，负责主动点击后的抽样图像观察。界面上的“模型请求”是希望调用的模型，“最近响应模型”是实际返回的模型；备用切换时两者可能不同。

用户授权免费模型繁忙时依次尝试5.3-Flash和FlashX。只有繁忙、限流、临时服务器错误或超时等情况才进入备用路线；密钥、权限、欠费和参数错误不靠反复换模型解决。每次新查询从主配置开始，实际尝试顺序和错误保留在记录里，模型费用以平台实际情况为准。

只有点“AI看图复核（最多发送3帧）”，程序才重新核对事件、文件和哈希，把最多3张已校验PPM转换成模型可接收的PNG并发送。界面保留发送帧索引、时间、哈希及响应模型。没有图、图片变更或取消时不能显示成功的视觉结论。

因此，“视觉接口已响应测试图”只证明接口处理过合成测试图片，不是现场精度测试；“本次发送3帧”说明实际抽样范围，不代表看过全部录像。完整41帧可以只展示32张、只发送3张，这三个数字对应不同环节，并不互相矛盾。

### 9.4 Agent如何防止说错

第一道是工具只查真实数据且保留来源范围；第二道是独立字段和完整事件引用，减少编号混淆；第三道是提示词、规则和Skill约束解释；第四道是界面展示原始核验记录，让老师可以比对。代码回归和用户复测分别验证具体行为，不宣称模型永不出错。

导出的复核记录包括问题、查询时间、会话来源、完整event_ref、工具轨迹和模型路线；看图记录还包括抽样帧身份。它不会把密钥、网页密码、图片编码和本地图片路径写入对外记录。复核导出是过程说明，不替代原始图像证据。

## 10 JoyCode专业智能体详细讲解

JoyCode是另一个智能体运行平台。当前创建的“智察考场·证据复核助手”在JoyCode内部聊天，上位机没有嵌入JoyCode内部聊天窗口，也没有获得它的独立聊天API。工程采取数据联动和双向交接，让它调用和桌面Agent一致的证据工具。

日常Agent适合老师快速查询；JoyCode适合设置更明确的专业复核步骤和回答规则。它们都能查事件，所以能力有交集，但一个强调日常便捷，一个强调可配置工作流。演示时通过交接同一事件展示联系，避免只是重复问两遍同一句话。

### 10.1 MCP是什么

MCP可以理解为智能体调用外部工具的统一接口。JoyCode知道有哪些工具、各自参数是什么，就能发起调用；本机examguard服务器收到请求后，执行已有查询逻辑，返回结构化结果。MCP不是训练模型的方法，也不自动提高K230识别准确率。

本工程采用stdio方式：JoyCode按配置启动本机Python脚本start_agent_mcp.py，通过标准输入输出交换JSON-RPC消息。初始化后先列出四个工具，再调用所需工具；不是监听一个公开网址，也不是把桌面网页登录地址填成MCP地址。

配置中command是Python绝对路径，args包含-u、MCP脚本路径和--current-session-file指定的数据源注册文件，env设置UTF-8。这台电脑已有Python，所以不必为了界面的npx/uvx推荐提示额外安装它们。换电脑时需要修正Python与工程路径。

### 10.2 为什么不必每场都改JSON

采用“跟随上位机”的配置后，MCP每次读取上位机明确选择的会话与证据目录。上位机维护注册与心跳；退出或注册失效时不擅自猜最新库、不回退旧场次。因此，配置一次并启用后，通常只需在上位机选择当前会话，JoyCode刷新并重新查询。

切换会话或证据目录后，先查询状态或事件，再查询图像，避免把上一场的引用接到新目录。JoyCode提示找不到examguard工具时，应先检查MCP有没有启用并重连，不是重新烧FPGA。

即使跟随当前会话，MCP实际读取的仍是落盘数据，不等于直接监听板卡。工具本次返回新数据和“板卡现在在线”是两件事。状态停更、live_session=false或温度未知时按原样解释，不能因为联动就绪就宣布硬件健康。

### 10.3 Prompt Rule Skill分别负责什么

Prompt是这个助手的角色与当前任务说明：你是监考复核助手，应按工具事实说明事件、证据和下一步。它决定回答方向，但不能凭角色设定获得数据库数据。

Rule是持续生效的约束：UID不是类型；无图不推断丢包；历史正常不等于现在在线；未实际读图不能说已目视；不直接裁定作弊。本助手设置匹配规则*，同时在规则正文限定只用于本助手，避免影响其他智能体任务。

Skill是可复用的操作方法：先确认来源，再查事件，用完整引用核对证据和图像，最后限定范围地回答。技能包还写适用场景、使用方法、失效条件、失败观察和验证效果，而不是只给一句“请专业回答”。

MCP是连接真实工具的通道。Prompt、Rule、Skill负责如何用，MCP负责能调用什么，模型负责理解问题和组织结果。可配置这些内容不代表已经微调或训练模型权重。比赛通用PYNQ Skill另有框架与复用要求，当前复核技能不能直接当作该加分项。

### 10.4 两个界面怎样交接

在日常Agent选中一条事件，写好问题，点击“（转到JoyCode专业复核）”。程序带上问题、完整event_ref和数据源签名，在专业页生成可复制问题。用户粘贴到JoyCode后主动发送，不自动上传全部证据。

JoyCode调用工具返回后，把同一完整event_ref带回专业页，即可打开原图回放；也可以转回Agent日常页，继续查询。会话或目录变化时旧交接会失效，需要重新选择和查询。这一设计避免把同UID、不同场次的记录串在一起。

专业页可打开Skills、Rule、Prompt参考和复制MCP配置，老师可以据此建立自己的复核流程。真正的专业聊天仍在JoyCode内部完成，原图查看仍依赖本机已有证据。

## 11 本机网页登录如何实现

上位机启动一个本机HTTP服务，默认只绑定127.0.0.1并自动选择可用端口。账号为judge，密码在桌面生成或设置。浏览器登录后取得会话凭据，后续查询先验证登录，再通过与桌面相同的数据工具读取已选会话。

密码以Windows当前用户DPAPI加密保存；随机生成避免每次手填弱密码。保存并应用新密码时服务重建，旧登录失效，端口也可能变化，因此要使用界面显示的新地址，不能一直刷新旧页。

网页启动时固定当前会话、目录、模式和模型配置。要换场次或模型，先停网页、修改，再启动。网页提供文字问答、已有图像查看和记录下载；桌面“AI看图复核”按钮目前没有在网页重复提供。

本机地址只能在同一电脑访问，其他电脑或远程评委不能直接打开127.0.0.1。当前完成的是本机登录演示，公网服务需要单独部署，不能用一个本机地址代替大赛要求的远程可访问链接。

## 12 这个项目是怎样逐步做出来的

第一阶段先打通最小硬件链路：OV5640能采集、DDR3能正确读写、HDMI能显示、串口能收发。独立DDR测试确认容量和读写能力，不把独立带宽直接当成整机速度。

第二阶段加入考试状态机、名册、姓名叠加、语音与按键，让身份核验到正式开考有清楚的条件。每一步用实际状态回执对照，避免只看PC按钮变化就认为板卡已经执行。

第三阶段加入事件队列、历史缓存、时间窗口、共享引用和网络图像传输。再做PC关联、完整性检查、回放和归档，形成可以核对的闭环。当前一个真实遮挡事件曾返回41/41联合完整，仍需老师看原图判断。

第四阶段根据现场反馈修正黑色物体误识别、紫书漏检和遮挡触发问题。紫书使用现有模型辅助；遮挡经过有效区域与近黑阈值修正；身份底纹缩小。这些改进都有各自范围，不把所有识别问题都写成完全消失。

第五阶段把已有PC能力封装成四个只读工具，接入文本模型、抽样视觉模型和导出，再建立MCP让JoyCode复用。最后加入日常与专业交接、网页登录和密码更新，保留真实数据来源和人工复核边界。

第六阶段把已验证FPGA写入Flash，核对K230 SD入口，实际断电上电确认能自动演示。现有版本功能完整，但比赛提交仍需真实照片、完整工程、构建报告、协作记录和技能包共同证明，不能只靠聊天效果。

## 13 答辩时最该讲清楚的地方

FPGA的核心价值是连续执行考试状态、视频和历史取证，不是给K230做一个转发器。前后图像、共享存储和完整性检查体现了硬件设计与系统集成工作，Agent则让这些结果更容易被老师使用。

不能说底层绝对可靠、零延迟、零遗漏或100%识别。当前资源、时序余量、窗口帧数和冷启动结果各有真实依据；跨时钟告警、外部接口预算、长期表现及现场精度仍应保留实际边界。

可以这样回答为什么不用大模型直接监考：“逐帧采集、计时和历史图像由本地硬件持续处理；大模型按老师的问题调用工具并解释已有证据。这样实时流程与语言服务分工清楚，模型不可用时仍保留原有硬件记录，最终结论由老师查看原始画面作出。”

代码入口为start_examguard.py。Agent、MCP、JoyCode与网页代码集中在host/app，硬件逻辑见fpga目录；详细路径及实测依据见技术报告，复制语句见配套演示流程。
