Mod-queen/examguard-fpga-k230-voice/data/algorithms.md

# 摄像头与识别算法说明

## K230视觉

程序入口为src/k230/runtime/main.py与live_app.py。启动时加载现有人脸、六类目标和手机/书籍辅助模型，按当前SD清单组织运行文件；本次工程整理没有重训或替换模型。

人脸模块提取特征并与本机登记库比较，通过后发送身份结果。目标模型输出框与类别，eg_live_fast和eg_live_adapter负责解码、阈值及连续结果处理，再编码成串口消息。框坐标转换到显示坐标，FPGA按消息类型处理。

eg_book_assist结合已有书籍检测候选与紫色封面条件，符合时才提供资料线索；普通答题纸、试卷、衣裤和笔袋不是资料目标。颜色条件是辅助筛选，不能保证任意光照或书脊方向都能识别。原手机、左右头姿沿用现有模型和确认逻辑，结果均为疑似线索。

模型来源、训练曲线与SHA见model_records及board/k230/sdcard_manifest.json。训练拟合结果、公开验证和现场反馈分别记录，不把同一批训练图上的拟合分数当现场准确率。

## OV5640与FPGA

相机先通过配置接口设置寄存器，再按DVP时钟与同步信号接收RGB565像素。DDR视频通道保存与读取图像；HDMI输出分辨率1280×720，升级版将颜色和同步信号一起延迟一个像素周期，保持对齐。

遮挡统计只计有效相机画面。RGB三个通道均不高于31视作近黑；比例至少98%且连续30帧才报警，恢复3帧后释放。身份显示底纹不参与统计。

历史采样缩为320×180 RGB565，事件引用前后窗口，像素与采集结果联合核对。相同帧可由重叠事件共享。完整表示数据关联核对通过，不直接表示确认违规。

## 复核与语言交互

PC先保存事件与证据，再由四只读工具提供最近事件、证据状态、图像路径和系统健康。日常Agent调用同组工具并解释结果；显式点击AI看图才抽样发送最多3帧。JoyCode通过MCP调用这些能力，可配置Skills、Rule和Prompt。大模型不能修改考试状态或直接裁定作弊。

对比与单模块验证见sim/readme.md，运行环境见build/reproduction.md。
