Mod-queen/examguard-fpga-k230-voice/data/packaging_observations.md

# 本轮整理观察

源码、模型、验收位流与原始报告保留；目录文件名改为英文小写，XPR活动引用随路径调整。构建脚本改为复制到新输出目录后构建。source_copy_manifest记录原文件哈希，package_manifest记录交付文件哈希，二者允许因已说明的路径/测试台/示例配置调整而不同。

PC临时文件测试首次受Windows沙箱权限拒绝，终止后在正常用户环境重跑68项通过。错误摘录：PermissionError WinError5，发生于临时测试证据目录创建，不代表设备或正式数据损坏。

旧历史目录测试台漏接新版观察输出；只补测试声明。完整语音线级测试在Icarus下有语法/90秒运行兼容问题，保留原XSim模型并使用原验证环境。两者都没有修改已部署硬件逻辑。

报告协作记录为真实可见节选整理；未复制聊天密钥。当前运行的原监考台及原人脸库、私有设置没有被提交副本修改。
