Mod-queen/examguard-fpga-k230-voice/sim/modules/ai_link_rx.md

# ai_link_rx

当前工程实例化：是。关联1个自检用例。

| 用例 | 仿真器 | 当前结果 | 运行日志 | 结果记录 |
| --- | --- | --- | --- | --- |
| ai_link_rx_tb | icarus | 通过 | [日志](../../sim/results/quality_current/ai_link_rx_tb/run.log) | [记录](../../sim/results/quality_current/ai_link_rx_tb/result.json) |

单独重跑本模块关联用例（工程根目录）：

```powershell
python sim/run_module_tests.py --only ai_link_rx_tb --vivado-bin "$env:EXAMGUARD_VIVADO_BIN" --iverilog-bin "$env:EXAMGUARD_IVERILOG_BIN"
```

先按[复原说明](../../build/reproduction.md)配置工具。每次生成新的结果目录。

## ai_link_rx_tb

用例源码：[ai_link_rx_tb.v](../../src/fpga/ov5640_ddr3_hdmi_vga.srcs/sources_1/ai_link/ai_link_rx_tb.v)

VCD仿真波形（来源批次见索引）：

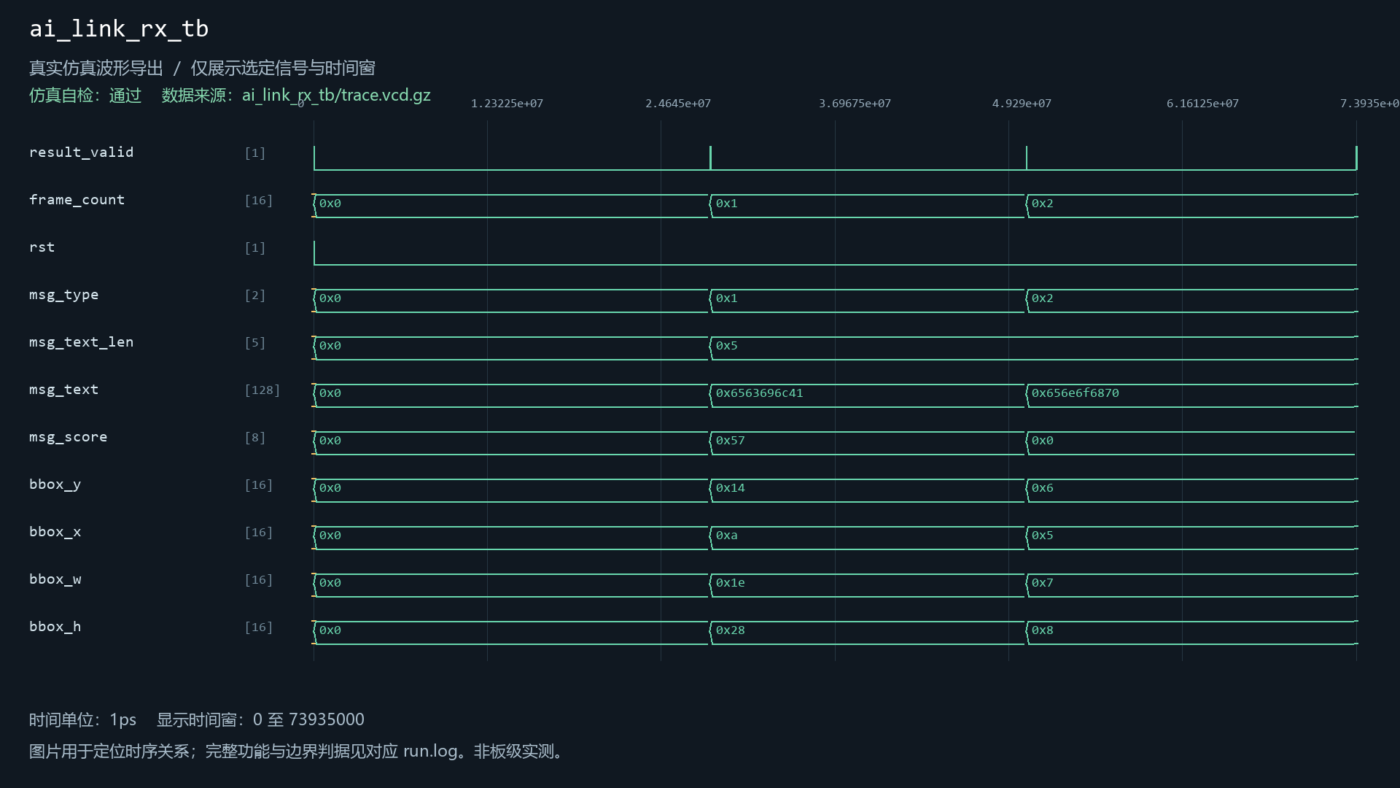
[picture p84: sim/images/ai_link_rx_tb.png]
ai_link_rx_tb
