Mod-queen/examguard-fpga-k230-voice/sim/modules/char_rom_cn.md

# char_rom_cn

当前工程实例化：是。关联2个自检用例。

| 用例 | 仿真器 | 当前结果 | 运行日志 | 结果记录 |
| --- | --- | --- | --- | --- |
| compact_identity_tb | icarus | 通过 | [日志](../../sim/results/quality_current/compact_identity_tb/run.log) | [记录](../../sim/results/quality_current/compact_identity_tb/result.json) |
| overlay_status_contract_tb | xsim | 通过 | [日志](../../sim/results/quality_current/overlay_status_contract_tb/run.log) | [记录](../../sim/results/quality_current/overlay_status_contract_tb/result.json) |

单独重跑本模块关联用例（工程根目录）：

```powershell
python sim/run_module_tests.py --only compact_identity_tb overlay_status_contract_tb --vivado-bin "$env:EXAMGUARD_VIVADO_BIN" --iverilog-bin "$env:EXAMGUARD_IVERILOG_BIN"
```

先按[复原说明](../../build/reproduction.md)配置工具。每次生成新的结果目录。

## compact_identity_tb

用例源码：[compact_identity_tb.sv](../../sim/sources/vision_guard/compact_identity_tb.sv)

VCD仿真波形（来源批次见索引）：

compact_identity_tb

## overlay_status_contract_tb

用例源码：[overlay_status_contract_tb.sv](../../sim/sources/verification_20261031/overlay_status_contract_tb.sv)

VCD仿真波形（来源批次见索引）：

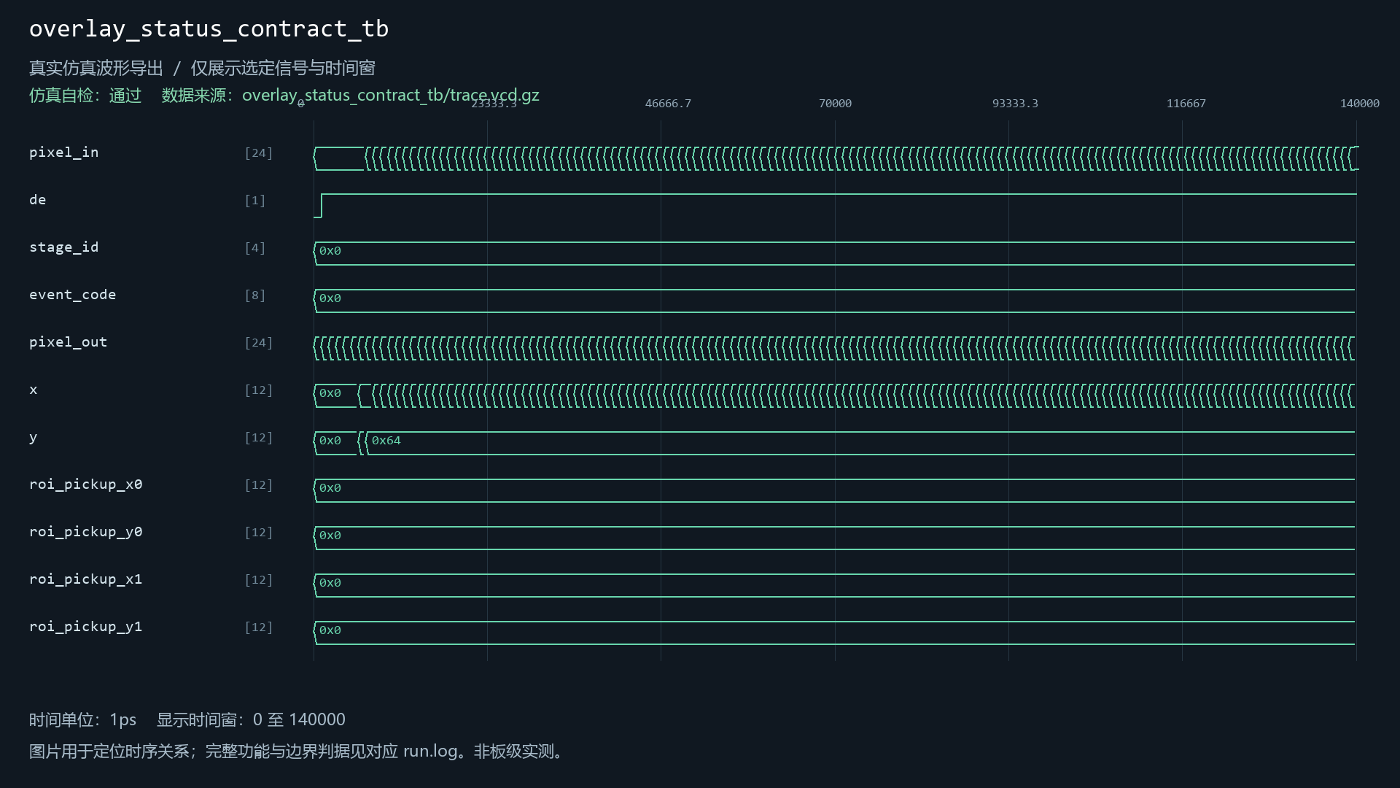
[picture p99: sim/images/overlay_status_contract_tb.png]
overlay_status_contract_tb
