Mod-queen/examguard-fpga-k230-voice/sim/modules/gmii_to_rgmii.md

# gmii_to_rgmii

当前工程实例化：是。关联1个自检用例。

| 用例 | 仿真器 | 当前结果 | 运行日志 | 结果记录 |
| --- | --- | --- | --- | --- |
| gmii_rgmii_contract_tb | xsim | 通过 | [日志](../../sim/results/quality_current/gmii_rgmii_contract_tb/run.log) | [记录](../../sim/results/quality_current/gmii_rgmii_contract_tb/result.json) |

单独重跑本模块关联用例（工程根目录）：

```powershell
python sim/run_module_tests.py --only gmii_rgmii_contract_tb --vivado-bin "$env:EXAMGUARD_VIVADO_BIN" --iverilog-bin "$env:EXAMGUARD_IVERILOG_BIN"
```

先按[复原说明](../../build/reproduction.md)配置工具。每次生成新的结果目录。

## gmii_rgmii_contract_tb

用例源码：[gmii_rgmii_contract_tb.sv](../../sim/sources/verification_20261031/gmii_rgmii_contract_tb.sv)

Vivado原生波形（与所列用例及WDB对应）：

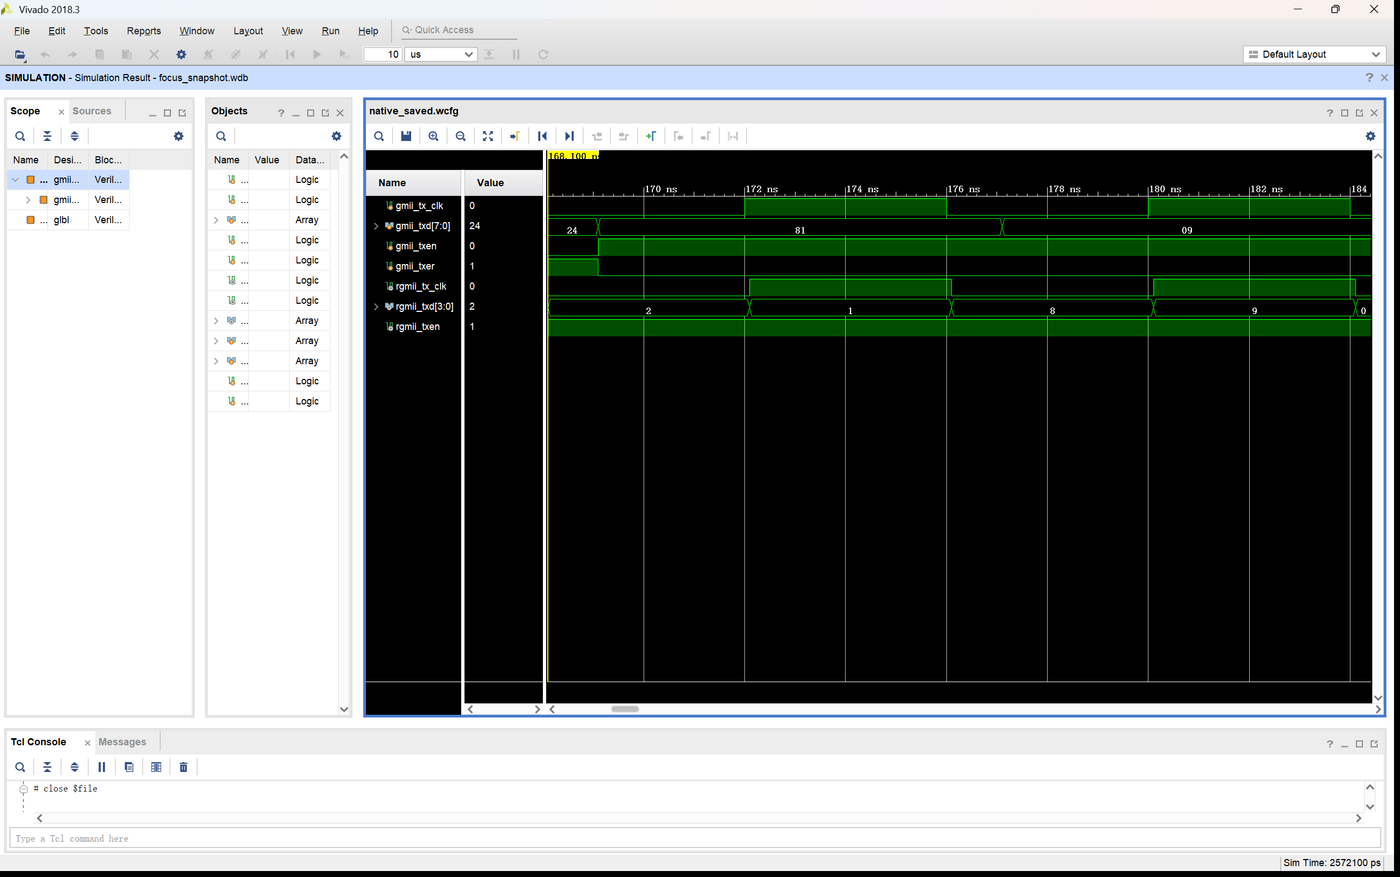
[picture p131: sim/images/native_selected/04_ethernet_edges_03/vivado_wave.png]
以太网双边沿传输


[原始WDB](../../sim/native_databases/gmii_rgmii_contract_tb/focus_snapshot.wdb)

VCD仿真波形（来源批次见索引）：

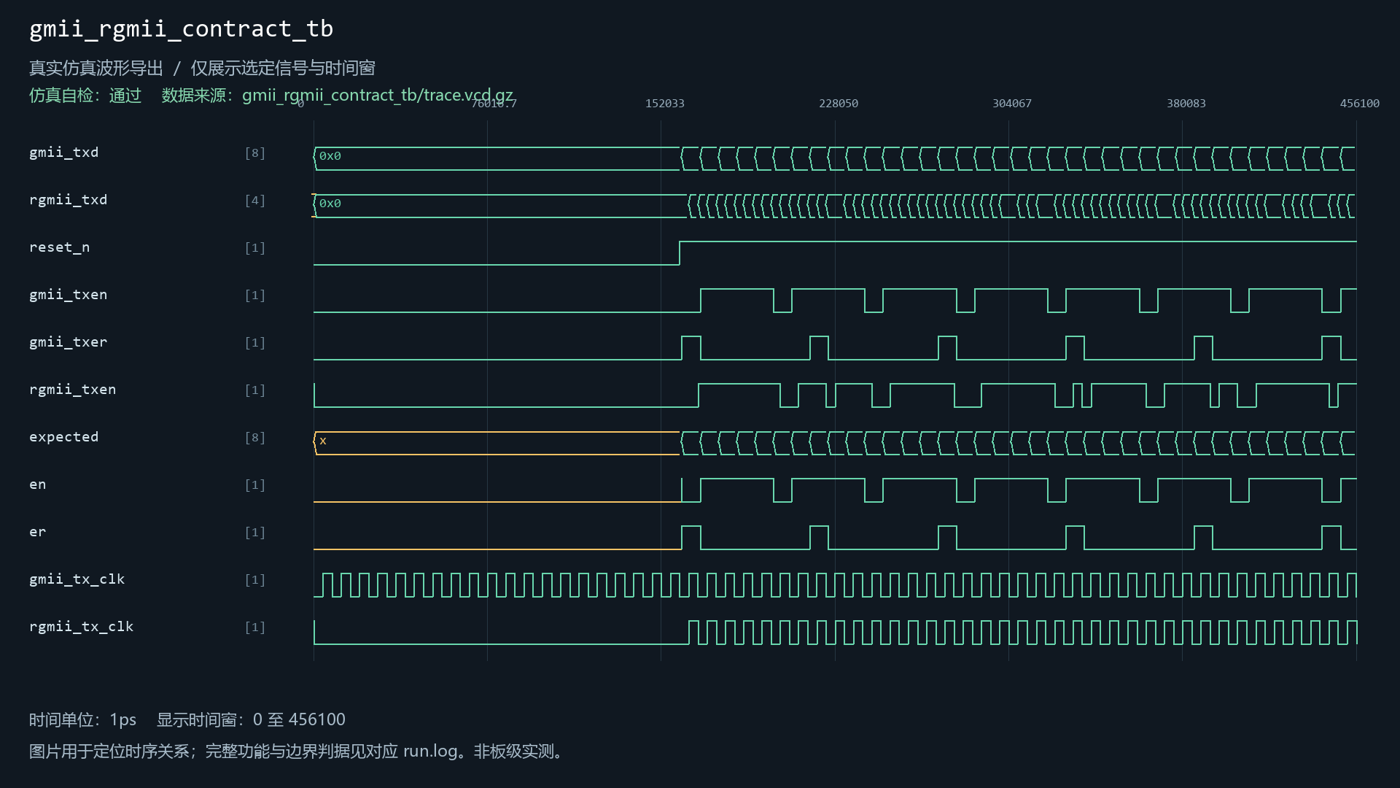
[picture p132: sim/images/gmii_rgmii_contract_tb.png]
gmii_rgmii_contract_tb
