Mod-queen/examguard-fpga-k230-voice/sim/modules/motion_detect.md

# motion_detect

当前工程实例化：是。关联1个自检用例。

| 用例 | 仿真器 | 当前结果 | 运行日志 | 结果记录 |
| --- | --- | --- | --- | --- |
| motion_detect_tb | icarus | 通过 | [日志](../../sim/results/quality_current/motion_detect_tb/run.log) | [记录](../../sim/results/quality_current/motion_detect_tb/result.json) |

单独重跑本模块关联用例（工程根目录）：

```powershell
python sim/run_module_tests.py --only motion_detect_tb --vivado-bin "$env:EXAMGUARD_VIVADO_BIN" --iverilog-bin "$env:EXAMGUARD_IVERILOG_BIN"
```

先按[复原说明](../../build/reproduction.md)配置工具。每次生成新的结果目录。

## motion_detect_tb

用例源码：[motion_detect_tb.v](../../src/fpga/ov5640_ddr3_hdmi_vga.srcs/sources_1/motion_detect/motion_detect_tb.v)

VCD仿真波形（来源批次见索引）：

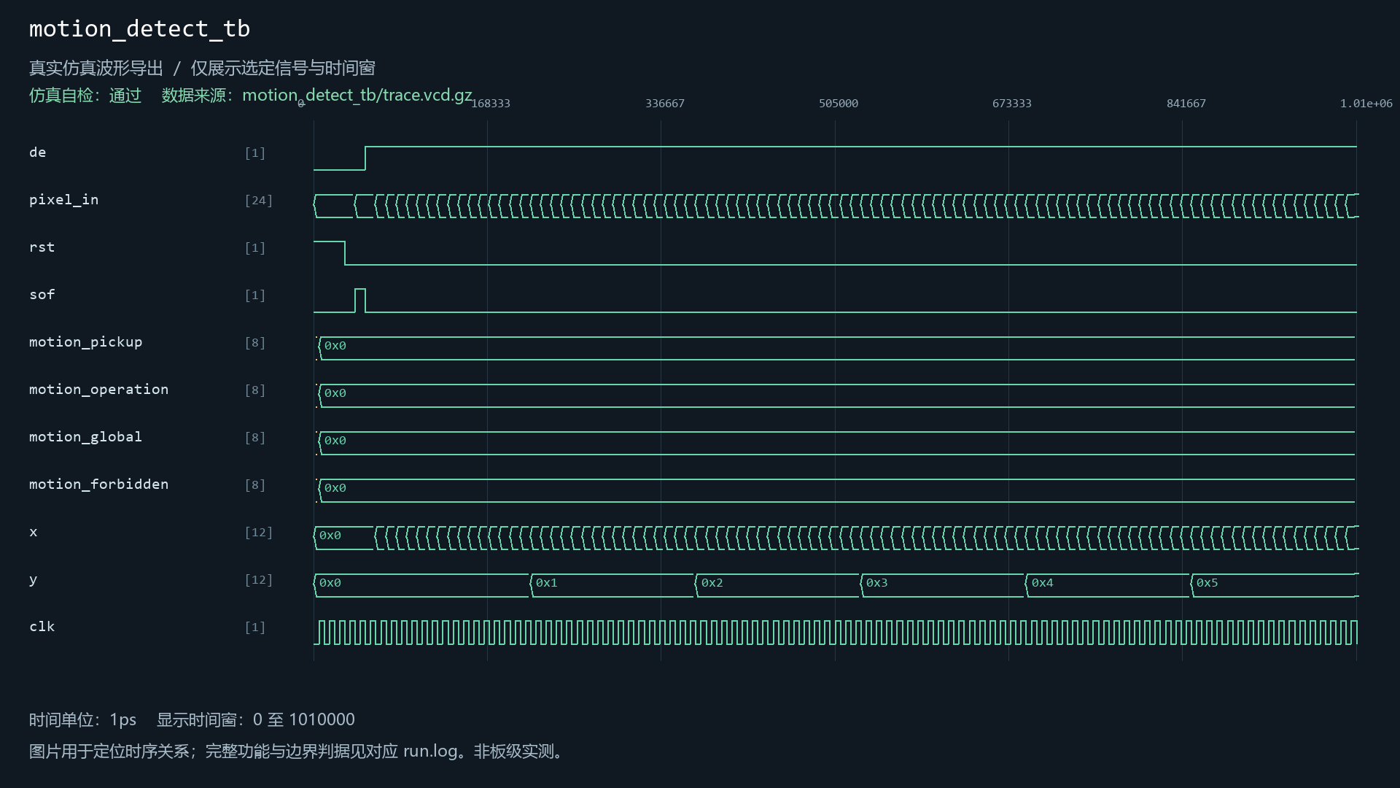
[picture p140: sim/images/motion_detect_tb.png]
motion_detect_tb
