Mod-queen/examguard-fpga-k230-voice/sim/modules/pcf8563_setter.md

# pcf8563_setter

当前工程实例化：是。关联4个自检用例。

| 用例 | 仿真器 | 当前结果 | 运行日志 | 结果记录 |
| --- | --- | --- | --- | --- |
| maintenance_system_tb | xsim | 通过 | [日志](../../sim/results/quality_current/maintenance_system_tb/run.log) | [记录](../../sim/results/quality_current/maintenance_system_tb/result.json) |
| pcf8563_setter_tb | xsim | 通过 | [日志](../../sim/results/quality_current/pcf8563_setter_tb/run.log) | [记录](../../sim/results/quality_current/pcf8563_setter_tb/result.json) |
| pcf8563_setter_wire_tb | icarus | 通过 | [日志](../../sim/results/quality_current/pcf8563_setter_wire_tb/run.log) | [记录](../../sim/results/quality_current/pcf8563_setter_wire_tb/result.json) |
| persistent_maintenance_service_tb | icarus | 通过 | [日志](../../sim/results/quality_current/persistent_maintenance_service_tb/run.log) | [记录](../../sim/results/quality_current/persistent_maintenance_service_tb/result.json) |

单独重跑本模块关联用例（工程根目录）：

```powershell
python sim/run_module_tests.py --only maintenance_system_tb pcf8563_setter_tb pcf8563_setter_wire_tb persistent_maintenance_service_tb --vivado-bin "$env:EXAMGUARD_VIVADO_BIN" --iverilog-bin "$env:EXAMGUARD_IVERILOG_BIN"
```

先按[复原说明](../../build/reproduction.md)配置工具。每次生成新的结果目录。

## maintenance_system_tb

用例源码：[maintenance_system_tb.sv](../../sim/test_repairs/maintenance_system_tb/maintenance_system_tb.sv)

VCD仿真波形（来源批次见索引）：

maintenance_system_tb

## pcf8563_setter_tb

用例源码：[pcf8563_setter_tb.sv](../../sim/test_repairs/pcf8563_setter_tb/pcf8563_setter_tb.sv)

VCD仿真波形（来源批次见索引）：

pcf8563_setter_tb

## pcf8563_setter_wire_tb

用例源码：[pcf8563_setter_wire_tb.sv](../../sim/sources/persistence/pcf8563_setter_wire_tb.sv)

VCD仿真波形（来源批次见索引）：

pcf8563_setter_wire_tb

## persistent_maintenance_service_tb

用例源码：[persistent_maintenance_service_tb.sv](../../sim/sources/persistence/persistent_maintenance_service_tb.sv)

VCD仿真波形（来源批次见索引）：

persistent_maintenance_service_tb
