Mod-queen/examguard-fpga-k230-voice/sim/modules/ddr3_ctrl_2port.md

# ddr3_ctrl_2port

当前工程实例化：否。关联0个自检用例。

| 用例 | 仿真器 | 当前结果 | 运行日志 | 结果记录 |
| --- | --- | --- | --- | --- |

本模块未在当前综合结果中实例化，也没有当前自检关联；保留源文件供参考，不宣称已测试。
