Mod-queen/examguard-fpga-k230-voice/sim/modules/display_output_pipeline.md

# display_output_pipeline

当前工程实例化：是。关联2个自检用例。

| 用例 | 仿真器 | 当前结果 | 运行日志 | 结果记录 |
| --- | --- | --- | --- | --- |
| display_pipeline_contract_tb | icarus | 通过 | [日志](../../sim/results/quality_current/display_pipeline_contract_tb/run.log) | [记录](../../sim/results/quality_current/display_pipeline_contract_tb/result.json) |
| dvi_pipeline_contract_tb | xsim | 通过 | [日志](../../sim/results/quality_current/dvi_pipeline_contract_tb/run.log) | [记录](../../sim/results/quality_current/dvi_pipeline_contract_tb/result.json) |

单独重跑本模块关联用例（工程根目录）：

```powershell
python sim/run_module_tests.py --only display_pipeline_contract_tb dvi_pipeline_contract_tb --vivado-bin "$env:EXAMGUARD_VIVADO_BIN" --iverilog-bin "$env:EXAMGUARD_IVERILOG_BIN"
```

先按[复原说明](../../build/reproduction.md)配置工具。每次生成新的结果目录。

## display_pipeline_contract_tb

用例源码：[display_pipeline_contract_tb.sv](../../sim/sources/quality/display_pipeline_contract_tb.sv)

本用例提供上方日志和机器可读结果；尚无截图，不用其他模块图片替代。

## dvi_pipeline_contract_tb

用例源码：[dvi_pipeline_contract_tb.sv](../../sim/sources/quality/dvi_pipeline_contract_tb.sv)

本用例提供上方日志和机器可读结果；尚无截图，不用其他模块图片替代。
