Mod-queen/examguard-fpga-k230-voice/skill/examguard_review/skill.md

---
name: examguard-review
description: 通过 examguard MCP 查询考场疑似报警、核对证据和解释最后系统状态。适用于监考复核及明确标注的存档演示，不用于修改硬件或直接判定作弊。
---

# 考场事件与证据复核

使用已连接的 examguard MCP。工具返回的数据只能证明其明确覆盖的选定会话和证据目录；不能推广到其他场次、其他目录或当前设备。工具不可用时说明无法查询，不用阅读、编辑或终端绕过数据工具。

## 根据问题选择工具

只问在线情况、阶段或温度：调用 get_system_health。区分最后上报的健康标志、数据新鲜程度与是否实时会话；历史的“正常”不能当作当前在线。

询问近期疑似手机、资料或扭头：调用 get_recent_events。time_range 为分钟，默认30，支持1至1440；event_code 手机80、资料81、扭头96，省略查全部；limit 最大50。结果截断时只说明已检查部分，不给全场总数。超过查询范围的历史场次不能改系统时间、借用其他场次或伪造近期事件。

核对具体事件：优先使用查询返回的完整64字符十六进制 event_ref，调用 check_evidence_status 和 get_image_path。用户已提供完整引用时可直接核对；如返回身份冲突或事件不存在，不按近似编号猜测。UID 只有工具确认在所选会话唯一时才可使用，不把 UID 本身当作完整身份。

event_uid是编号，不是类型。不能把UID102换算成0x66后推断事件类别。类型只读工具返回的event_code、event_code_hex和event；手机80=0x50、资料81=0x51、扭头96=0x60，未知码不能归入相近类别。缺字段时说类型未知，不根据event_ref手动解码补猜。

批量查询先复核最新的少量匹配事件，并说明尚未逐项核对的数量或截断范围。仅健康问题不调取图像。

## 正确解释结果

not_received：当前选定存档和证据目录中没有查到可关联证据。不能据此判断从未采集、PC从未收到、硬件未执行或网络丢包。

images=[]：本次没有可展示的已校验帧；可能有其他类型回执，需结合证据状态。expected_frames=null 代表未知；missing_frame_indices=[] 在没有证据时不能解释为“没有缺失”。validation_errors=0 也不代表证据齐全。

其他状态按 [工具契约](references/tool_contract.md) 解释。不把等待、降级或部分图像称为联合完整；联合完整也不等于已确认违规。

只有路径和元数据时，未进行图像目视复核。仅有D盘路径不能给云端用户承诺“点击即可查看”，不能生成假的链接或缩略图。使用已经提供的可访问入口，或说明需要在本机图像回放中查看。

静态历史存档不建议无条件“稍后等待证据到达”。可建议核对所选会话和证据目录，或在用户明确选择当前采集会话后重新查询。

## 回答方式

默认用三至五句简洁中文：说明来源与时间范围、疑似发现、证据状态及可执行的复核建议。null 解释为未知，不逐项堆砌原始字段；用户要求技术明细时再给。时间优先按工具的UTC时间说明，不把设备运行毫秒数当现实日期。

记录工具选择及其支持的结论摘要即可，不要求展示内部推理过程。报警只能称疑似，最终由老师查看原始证据复核。

感知目标是手机、指定紫色封面书籍及异常扭头；正常试卷、答题纸不应报警，衣服、裤子、笔袋不属于目标。该目标定义不能用于掩盖现有误报，也不能把任何旧 notes 报警自动确认成紫色书籍。
