Mod-queen/examguard-fpga-k230-voice/skill/examguard_review/submission_note.md

本目录为原工程技能的只读交付副本。原README中的待验描述保留为历史制作阶段；最新用户已回传正确类型、当前场次四工具与有图事件复核。最新范围和真实纠错见../../report/collaboration_record.md。此技能不是PYNQ技能。
