Mod-queen/examguard-fpga-k230-voice/build/reports/cdc_review/structure_review.tsv

序号 | 检查 | 源时钟 | 目标时钟 | 源端点 | 目标端点 | 结构 | 核对说明 | 处理状态
1 | CDC-10 | clk_out1_pll | camera_pclk_audit | camera_init/Init_Done_reg/C | ddr3_ctrl_2port/fabric/video/w_fifo_reset/release_ff_reg[0]/PRE | 复位输入 | 异步置位、当地时钟逐级释放。多路复位条件与跨域扇出仍需结合实际失效场景复核；不自动豁免。 | 已定位结构，保留待签核；未新增豁免
2 | CDC-12 | clk_out1_pll | camera_pclk_audit | camera_init/Init_Done_reg/C | ddr3_ctrl_2port/fabric/video/w_fifo_reset/release_ff_reg[0]/PRE | 复位输入 | 异步置位、当地时钟逐级释放。多路复位条件与跨域扇出仍需结合实际失效场景复核；不自动豁免。 | 已定位结构，保留待签核；未新增豁免
3 | CDC-10 | clk_pll_i | camera_pclk_audit | ddr3_ctrl_2port/u_mig_7series_0/u_mig_7series_0_mig/u_memc_ui_top_axi/mem_intfc0/ddr_phy_top0/u_ddr_calib_top/init_calib_complete_reg/C | camera_capture_reset_inst/release_ff_reg[0]/PRE | 复位输入 | 异步置位、当地时钟逐级释放。多路复位条件与跨域扇出仍需结合实际失效场景复核；不自动豁免。 | 已定位结构，保留待签核；未新增豁免
4 | CDC-10 | clk_pll_i | camera_pclk_audit | video_fabric_rst_sync_reg[2]/C | ddr3_ctrl_2port/fabric/video/w_fifo_reset/release_ff_reg[0]/PRE | 复位输入 | 异步置位、当地时钟逐级释放。多路复位条件与跨域扇出仍需结合实际失效场景复核；不自动豁免。 | 已定位结构，保留待签核；未新增豁免
5 | CDC-12 | clk_pll_i | camera_pclk_audit | video_fabric_rst_sync_reg[2]/C | ddr3_ctrl_2port/fabric/video/w_fifo_reset/release_ff_reg[0]/PRE | 复位输入 | 异步置位、当地时钟逐级释放。多路复位条件与跨域扇出仍需结合实际失效场景复核；不自动豁免。 | 已定位结构，保留待签核；未新增豁免
6 | CDC-10 | clk_out1_pll | clk_out1_dvi_pll | eth_phy_reg_config_inst/settle_reg[25]/C | evidence_reset_barrier_inst/domain[1].release_pipe_reg[0]/PRE | 复位输入 | 异步置位、当地时钟逐级释放。多路复位条件与跨域扇出仍需结合实际失效场景复核；不自动豁免。 | 已定位结构，保留待签核；未新增豁免
7 | CDC-12 | clk_out1_pll | clk_out1_dvi_pll | eth_phy_reg_config_inst/settle_reg[25]/C | evidence_reset_barrier_inst/domain[1].release_pipe_reg[0]/PRE | 复位输入 | 异步置位、当地时钟逐级释放。多路复位条件与跨域扇出仍需结合实际失效场景复核；不自动豁免。 | 已定位结构，保留待签核；未新增豁免
8 | CDC-10 | clk_out1_pll | clk_out1_dvi_pll | history_client_inst/epoch/cancelled_reg/C | history_client_inst/epoch/barrier/domain[0].release_pipe_reg[0]/PRE | 复位输入 | 异步置位、当地时钟逐级释放。多路复位条件与跨域扇出仍需结合实际失效场景复核；不自动豁免。 | 已定位结构，保留待签核；未新增豁免
9 | CDC-11 | clk_out1_pll | clk_out1_dvi_pll | history_client_inst/epoch/cancelled_reg/C | history_client_inst/epoch/barrier/domain[0].release_pipe_reg[0]/PRE | 复位输入 | 异步置位、当地时钟逐级释放。多路复位条件与跨域扇出仍需结合实际失效场景复核；不自动豁免。 | 已定位结构，保留待签核；未新增豁免
10 | CDC-10 | clk_pll_i | clk_out1_dvi_pll | video_fabric_rst_sync_reg[2]/C | ddr3_ctrl_2port/fabric/video/r_fifo_reset/release_ff_reg[0]/PRE | 复位输入 | 异步置位、当地时钟逐级释放。多路复位条件与跨域扇出仍需结合实际失效场景复核；不自动豁免。 | 已定位结构，保留待签核；未新增豁免
11 | CDC-10 | clk_pll_i | clk_out1_dvi_pll | ddr3_ctrl_2port/u_mig_7series_0/u_mig_7series_0_mig/u_memc_ui_top_axi/mem_intfc0/ddr_phy_top0/u_ddr_calib_top/init_calib_complete_reg/C | ddr3_ready_pixel_ff_reg[0]/D | DDR就绪状态 | MIG就绪输出进入两级ASYNC_REG链。首级前存在组合逻辑；需复核就绪状态稳定性，不能据双级标记宣布完全签核。 | 已定位结构，保留待签核；未新增豁免
12 | CDC-10 | clk_pll_i | clk_out1_dvi_pll | ddr3_ctrl_2port/u_mig_7series_0/u_mig_7series_0_mig/u_memc_ui_top_axi/mem_intfc0/ddr_phy_top0/u_ddr_calib_top/init_calib_complete_reg/C | evidence_reset_barrier_inst/domain[1].release_pipe_reg[0]/PRE | 复位输入 | 异步置位、当地时钟逐级释放。多路复位条件与跨域扇出仍需结合实际失效场景复核；不自动豁免。 | 已定位结构，保留待签核；未新增豁免
13 | CDC-12 | clk_pll_i | clk_out1_dvi_pll | ddr3_ctrl_2port/u_mig_7series_0/u_mig_7series_0_mig/u_memc_ui_top_axi/mem_intfc0/ddr_phy_top0/u_ddr_calib_top/init_calib_complete_reg/C | evidence_reset_barrier_inst/domain[1].release_pipe_reg[0]/PRE | 复位输入 | 异步置位、当地时钟逐级释放。多路复位条件与跨域扇出仍需结合实际失效场景复核；不自动豁免。 | 已定位结构，保留待签核；未新增豁免
14 | CDC-10 | clk_pll_i | clk_out1_pll | ddr3_ctrl_2port/u_mig_7series_0/u_mig_7series_0_mig/u_memc_ui_top_axi/mem_intfc0/ddr_phy_top0/u_ddr_calib_top/init_calib_complete_reg/C | ddr3_ready_50m_ff_reg[0]/D | DDR就绪状态 | MIG就绪输出进入两级ASYNC_REG链。首级前存在组合逻辑；需复核就绪状态稳定性，不能据双级标记宣布完全签核。 | 已定位结构，保留待签核；未新增豁免
15 | CDC-10 | clk_pll_i | clk_out1_pll | ddr3_ctrl_2port/u_mig_7series_0/u_mig_7series_0_mig/u_memc_ui_top_axi/mem_intfc0/ddr_phy_top0/u_ddr_calib_top/init_calib_complete_reg/C | evidence_reset_barrier_inst/domain[0].release_pipe_reg[0]/PRE | 复位输入 | 异步置位、当地时钟逐级释放。多路复位条件与跨域扇出仍需结合实际失效场景复核；不自动豁免。 | 已定位结构，保留待签核；未新增豁免
16 | CDC-11 | clk_pll_i | clk_out1_pll | ddr3_ctrl_2port/u_mig_7series_0/u_mig_7series_0_mig/u_memc_ui_top_axi/mem_intfc0/ddr_phy_top0/u_ddr_calib_top/init_calib_complete_reg/C | evidence_reset_barrier_inst/domain[0].release_pipe_reg[0]/PRE | 复位输入 | 异步置位、当地时钟逐级释放。多路复位条件与跨域扇出仍需结合实际失效场景复核；不自动豁免。 | 已定位结构，保留待签核；未新增豁免
17 | CDC-1 | phy_mdc | clk_out1_pll | eth_phy_reg_config_inst/mdc_clk_reg/Q | eth_phy_reg_config_inst/mdc_clk_reg/D | 管理时钟分频反馈 | RTL在50MHz域更新MDC分频寄存器；该寄存器又作为生成时钟使用。报告把Q到D反馈列作CDC，需进一步核对生成时钟关系与反馈路径计时。 | 已定位结构，保留待签核；未新增豁免
18 | CDC-10 | camera_pclk_audit | clk_pll_i | ddr3_ctrl_2port/fabric/video/w_fifo_reset/release_ff_reg[2]/C | ddr3_ctrl_2port/fabric/video/w_client_epoch/release_ff_reg[0]/PRE | 复位输入 | 异步置位、当地时钟逐级释放。多路复位条件与跨域扇出仍需结合实际失效场景复核；不自动豁免。 | 已定位结构，保留待签核；未新增豁免
19 | CDC-10 | clk_out1_dvi_pll | clk_pll_i | ddr3_ctrl_2port/fabric/video/r_fifo_reset/release_ff_reg[2]/C | ddr3_ctrl_2port/fabric/video/r_client_epoch/release_ff_reg[0]/PRE | 复位输入 | 异步置位、当地时钟逐级释放。多路复位条件与跨域扇出仍需结合实际失效场景复核；不自动豁免。 | 已定位结构，保留待签核；未新增豁免
20 | CDC-10 | clk_out1_pll | eth_clk125_unbuf | eth_phy_reg_config_inst/settle_reg[25]/C | evidence_reset_barrier_inst/domain[3].release_pipe_reg[0]/PRE | 复位输入 | 异步置位、当地时钟逐级释放。多路复位条件与跨域扇出仍需结合实际失效场景复核；不自动豁免。 | 已定位结构，保留待签核；未新增豁免
21 | CDC-11 | clk_out1_pll | eth_clk125_unbuf | eth_phy_reg_config_inst/settle_reg[25]/C | evidence_reset_barrier_inst/domain[3].release_pipe_reg[0]/PRE | 复位输入 | 异步置位、当地时钟逐级释放。多路复位条件与跨域扇出仍需结合实际失效场景复核；不自动豁免。 | 已定位结构，保留待签核；未新增豁免
22 | CDC-10 | clk_pll_i | eth_clk125_unbuf | ddr3_ctrl_2port/u_mig_7series_0/u_mig_7series_0_mig/u_memc_ui_top_axi/mem_intfc0/ddr_phy_top0/u_ddr_calib_top/init_calib_complete_reg/C | evidence_reset_barrier_inst/domain[3].release_pipe_reg[0]/PRE | 复位输入 | 异步置位、当地时钟逐级释放。多路复位条件与跨域扇出仍需结合实际失效场景复核；不自动豁免。 | 已定位结构，保留待签核；未新增豁免
23 | CDC-11 | clk_pll_i | eth_clk125_unbuf | ddr3_ctrl_2port/u_mig_7series_0/u_mig_7series_0_mig/u_memc_ui_top_axi/mem_intfc0/ddr_phy_top0/u_ddr_calib_top/init_calib_complete_reg/C | evidence_reset_barrier_inst/domain[3].release_pipe_reg[0]/PRE | 复位输入 | 异步置位、当地时钟逐级释放。多路复位条件与跨域扇出仍需结合实际失效场景复核；不自动豁免。 | 已定位结构，保留待签核；未新增豁免
24 | CDC-10 | clk_pll_i | eth_clk125_unbuf | history_client_inst/epoch/barrier/domain[1].release_pipe_reg[2]/C | hist_eth_meta_reg/PRE | 复位输入 | 异步置位、当地时钟逐级释放。多路复位条件与跨域扇出仍需结合实际失效场景复核；不自动豁免。 | 已定位结构，保留待签核；未新增豁免
25 | CDC-1 | clk_pll_i | eth_clk125_unbuf | history_hr_cdc_inst/fifo/mem_reg_0_63_6_8/RAMC/CLK | history_hr_cdc_inst/dst_last_reg/D | 异步FIFO存储数据 | LUTRAM异步读出，经empty与目标holding寄存器门控。Gray指针为双级同步；仍需核对实际存储到目标路径的最大延迟与指针偏斜约束，不能仅靠功能仿真豁免。 | 已定位结构，保留待签核；未新增豁免
26 | CDC-1 | clk_pll_i | eth_clk125_unbuf | history_pixel_cdc_inst/fifo/mem_reg_0_63_6_8/RAMC/CLK | history_pixel_cdc_inst/dst_last_reg/D | 异步FIFO存储数据 | LUTRAM异步读出，经empty与目标holding寄存器门控。Gray指针为双级同步；仍需核对实际存储到目标路径的最大延迟与指针偏斜约束，不能仅靠功能仿真豁免。 | 已定位结构，保留待签核；未新增豁免
