Mod-queen/examguard-fpga-k230-voice/build/reports/optimized/instantiated_modules.tsv

instance | reference | original_reference
DVP_Capture | DVP_Capture
ai_link_rx_inst | ai_link_rx
ai_mailbox_inst | ai_mailbox
alarm_beep_inst | alarm_beep
board_status_inst | board_status_control
camera_capture_reset_inst | video_epoch_clear
camera_init | camera_init
candidate_overlay_inst | candidate_overlay
candidate_to_host | cdc_stats_snapshot__parameterized2 | cdc_stats_snapshot
candidate_to_pixel | cdc_stats_snapshot__parameterized1 | cdc_stats_snapshot
cdc_exam_status_inst | cdc_exam_status
cdc_frame_activity_inst | cdc_frame_activity
color_enhance_inst | color_enhance
config_ack_tx_inst | config_ack_tx
config_mailbox_inst | config_mailbox
cover98_inst | camera_black_gate
ddr3_ctrl_2port | ddr3_shared_video_ctrl
disp_driver | disp_driver
dvi_encoder | dvi_encoder
dvi_pll | dvi_pll
eth_phy_reg_config_inst | phy_reg_config
event_identity_inst | event_identity
event_meta_ring_inst | event_meta_ring
evidence_dump_inst | evidence_dump
evidence_eth_tx_inst | eth_udp_tx_gmii
evidence_event_context_inst | exam_event_context
evidence_event_fork_inst | event_transaction_fork
evidence_event_log_inst | event_transaction_log
evidence_event_queue_inst | event_transaction_queue
evidence_health_inst | evidence_health_telemetry
evidence_identity_inst | persistent_event_identity
evidence_log_queue_inst | event_request_fifo__parameterized0 | event_request_fifo
evidence_reset_barrier_inst | evidence_reset_barrier__parameterized0 | evidence_reset_barrier
evidence_rgmii_inst | gmii_to_rgmii
exam_fsm_inst | exam_fsm
fullscreen_monitor_inst | fullscreen_monitor
hc595_driver_inst | hc595_driver
health_monitor_inst | health_monitor
hex8_inst | hex8
hist_event_cdc | cdc_event_transaction__parameterized4 | cdc_event_transaction
hist_source_time_cdc | cdc_time_snapshot
history_axi_guard_inst | history_axi_epoch_guard
history_byte_mux_inst | evidence_byte_mux
history_client_inst | history_capture_client
history_health_stats_inst | history_health_stats
history_hr_cdc_inst | evidence_packet_cdc
history_hr_record_inst | history_result_record
history_lifecycle_inst | history_lifecycle_control
history_pixel_cdc_inst | evidence_packet_cdc_2 | evidence_packet_cdc
history_pixel_packetizer_inst | evidence_window_packetizer
history_result_fork_inst | history_result_fork
history_udp_bridge_inst | evidence_packet_udp_bridge__parameterized0 | evidence_packet_udp_bridge
maintenance_endpoint_inst | maintenance_endpoint
monitor_record | board_monitor_record
monitor_snapshot | cdc_stats_snapshot__parameterized0 | cdc_stats_snapshot
motion_detect_inst | motion_detect
overlay_status_inst | overlay_status
persistent_boot_inst | persistent_maintenance_service
phy_health_inst | phy_health_snapshot
pll | pll
profile_decode | persistent_config_decode
pulse_cdc_image_overrun | pulse_cdc_4 | pulse_cdc
pulse_cdc_manual_event | pulse_cdc_5 | pulse_cdc
pulse_cdc_workflow_reset | pulse_cdc_6 | pulse_cdc
status_mailbox_inst | status_mailbox
status_uart_tx_inst | status_uart_tx
timestamp_ms_inst | timestamp_ms
uart_packet_mux_inst | uart_packet_mux
uart_rx_inst | uart_rx
user_control_inst | user_control
voice_interaction_inst | voice_interaction_system
camera_init/i2c_control | i2c_control
camera_init/ov5640_init_table_rgb_inst | ov5640_init_table_rgb
camera_init/i2c_control/i2c_bit_shift | i2c_bit_shift
candidate_to_host/bridge | cdc_event_transaction__parameterized2 | cdc_event_transaction
candidate_to_pixel/bridge | cdc_event_transaction__parameterized1 | cdc_event_transaction
config_ack_tx_inst/holding_stream.adapter | uart_stream_adapter_133 | uart_stream_adapter
ddr3_ctrl_2port/fabric | video_memory_fabric
ddr3_ctrl_2port/u_mig_7series_0 | mig_7series_0
ddr3_ctrl_2port/fabric/arbiter | axi_2client_arbiter
ddr3_ctrl_2port/fabric/buffered_evidence_read.buffer | axi_read_burst_buffer
ddr3_ctrl_2port/fabric/video | video_fifo_axi_port
ddr3_ctrl_2port/fabric/video/bridge | video_fifo_stream_bridge
ddr3_ctrl_2port/fabric/video/client | video_axi_client
ddr3_ctrl_2port/fabric/video/r_client_epoch | video_epoch_clear_30 | video_epoch_clear
ddr3_ctrl_2port/fabric/video/r_fifo_reset | video_epoch_clear_31 | video_epoch_clear
ddr3_ctrl_2port/fabric/video/rd_ddr3_fifo | rd_ddr3_fifo
ddr3_ctrl_2port/fabric/video/w_client_epoch | video_epoch_clear_33 | video_epoch_clear
ddr3_ctrl_2port/fabric/video/w_fifo_reset | video_epoch_clear_34 | video_epoch_clear
ddr3_ctrl_2port/fabric/video/wr_ddr3_fifo | wr_ddr3_fifo
ddr3_ctrl_2port/fabric/video/rd_ddr3_fifo/U0 | rd_ddr3_fifo_fifo_generator_v13_2_3 | fifo_generator_v13_2_3
ddr3_ctrl_2port/fabric/video/rd_ddr3_fifo/U0/inst_fifo_gen | rd_ddr3_fifo_fifo_generator_v13_2_3_synth | fifo_generator_v13_2_3_synth
ddr3_ctrl_2port/fabric/video/rd_ddr3_fifo/U0/inst_fifo_gen/gconvfifo.rf | rd_ddr3_fifo_fifo_generator_top | fifo_generator_top
ddr3_ctrl_2port/fabric/video/rd_ddr3_fifo/U0/inst_fifo_gen/gconvfifo.rf/grf.rf | rd_ddr3_fifo_fifo_generator_ramfifo | fifo_generator_ramfifo
ddr3_ctrl_2port/fabric/video/rd_ddr3_fifo/U0/inst_fifo_gen/gconvfifo.rf/grf.rf/gntv_or_sync_fifo.gcx.clkx | rd_ddr3_fifo_clk_x_pntrs | clk_x_pntrs
ddr3_ctrl_2port/fabric/video/rd_ddr3_fifo/U0/inst_fifo_gen/gconvfifo.rf/grf.rf/gntv_or_sync_fifo.gl0.rd | rd_ddr3_fifo_rd_logic | rd_logic
ddr3_ctrl_2port/fabric/video/rd_ddr3_fifo/U0/inst_fifo_gen/gconvfifo.rf/grf.rf/gntv_or_sync_fifo.gl0.wr | rd_ddr3_fifo_wr_logic | wr_logic
ddr3_ctrl_2port/fabric/video/rd_ddr3_fifo/U0/inst_fifo_gen/gconvfifo.rf/grf.rf/gntv_or_sync_fifo.mem | rd_ddr3_fifo_memory | memory
ddr3_ctrl_2port/fabric/video/rd_ddr3_fifo/U0/inst_fifo_gen/gconvfifo.rf/grf.rf/rstblk | rd_ddr3_fifo_reset_blk_ramfifo | reset_blk_ramfifo
ddr3_ctrl_2port/fabric/video/rd_ddr3_fifo/U0/inst_fifo_gen/gconvfifo.rf/grf.rf/gntv_or_sync_fifo.gcx.clkx/rd_pntr_cdc_inst | rd_ddr3_fifo_xpm_cdc_gray__parameterized1 | xpm_cdc_gray
ddr3_ctrl_2port/fabric/video/rd_ddr3_fifo/U0/inst_fifo_gen/gconvfifo.rf/grf.rf/gntv_or_sync_fifo.gcx.clkx/wr_pntr_cdc_inst | rd_ddr3_fifo_xpm_cdc_gray | xpm_cdc_gray
ddr3_ctrl_2port/fabric/video/rd_ddr3_fifo/U0/inst_fifo_gen/gconvfifo.rf/grf.rf/gntv_or_sync_fifo.gl0.rd/gras.rsts | rd_ddr3_fifo_rd_status_flags_as | rd_status_flags_as
ddr3_ctrl_2port/fabric/video/rd_ddr3_fifo/U0/inst_fifo_gen/gconvfifo.rf/grf.rf/gntv_or_sync_fifo.gl0.rd/rpntr | rd_ddr3_fifo_rd_bin_cntr | rd_bin_cntr
ddr3_ctrl_2port/fabric/video/rd_ddr3_fifo/U0/inst_fifo_gen/gconvfifo.rf/grf.rf/gntv_or_sync_fifo.gl0.rd/gras.rsts/c0 | rd_ddr3_fifo_compare | compare
ddr3_ctrl_2port/fabric/video/rd_ddr3_fifo/U0/inst_fifo_gen/gconvfifo.rf/grf.rf/gntv_or_sync_fifo.gl0.rd/gras.rsts/c1 | rd_ddr3_fifo_compare_0 | compare
ddr3_ctrl_2port/fabric/video/rd_ddr3_fifo/U0/inst_fifo_gen/gconvfifo.rf/grf.rf/gntv_or_sync_fifo.gl0.wr/gwas.wsts | rd_ddr3_fifo_wr_status_flags_as | wr_status_flags_as
ddr3_ctrl_2port/fabric/video/rd_ddr3_fifo/U0/inst_fifo_gen/gconvfifo.rf/grf.rf/gntv_or_sync_fifo.gl0.wr/wpntr | rd_ddr3_fifo_wr_bin_cntr | wr_bin_cntr
ddr3_ctrl_2port/fabric/video/rd_ddr3_fifo/U0/inst_fifo_gen/gconvfifo.rf/grf.rf/gntv_or_sync_fifo.mem/gbm.gbmg.gbmga.ngecc.bmg | rd_ddr3_fifo_blk_mem_gen_v8_4_2 | blk_mem_gen_v8_4_2
ddr3_ctrl_2port/fabric/video/rd_ddr3_fifo/U0/inst_fifo_gen/gconvfifo.rf/grf.rf/gntv_or_sync_fifo.mem/gbm.gbmg.gbmga.ngecc.bmg/inst_blk_mem_gen | rd_ddr3_fifo_blk_mem_gen_v8_4_2_synth | blk_mem_gen_v8_4_2_synth
ddr3_ctrl_2port/fabric/video/rd_ddr3_fifo/U0/inst_fifo_gen/gconvfifo.rf/grf.rf/gntv_or_sync_fifo.mem/gbm.gbmg.gbmga.ngecc.bmg/inst_blk_mem_gen/gnbram.gnativebmg.native_blk_mem_gen | rd_ddr3_fifo_blk_mem_gen_top | blk_mem_gen_top
ddr3_ctrl_2port/fabric/video/rd_ddr3_fifo/U0/inst_fifo_gen/gconvfifo.rf/grf.rf/gntv_or_sync_fifo.mem/gbm.gbmg.gbmga.ngecc.bmg/inst_blk_mem_gen/gnbram.gnativebmg.native_blk_mem_gen/valid.cstr | rd_ddr3_fifo_blk_mem_gen_generic_cstr | blk_mem_gen_generic_cstr
ddr3_ctrl_2port/fabric/video/rd_ddr3_fifo/U0/inst_fifo_gen/gconvfifo.rf/grf.rf/gntv_or_sync_fifo.mem/gbm.gbmg.gbmga.ngecc.bmg/inst_blk_mem_gen/gnbram.gnativebmg.native_blk_mem_gen/valid.cstr/ramloop[0].ram.r | rd_ddr3_fifo_blk_mem_gen_prim_width | blk_mem_gen_prim_width
ddr3_ctrl_2port/fabric/video/rd_ddr3_fifo/U0/inst_fifo_gen/gconvfifo.rf/grf.rf/gntv_or_sync_fifo.mem/gbm.gbmg.gbmga.ngecc.bmg/inst_blk_mem_gen/gnbram.gnativebmg.native_blk_mem_gen/valid.cstr/ramloop[1].ram.r | rd_ddr3_fifo_blk_mem_gen_prim_width__parameterized0 | blk_mem_gen_prim_width
ddr3_ctrl_2port/fabric/video/rd_ddr3_fifo/U0/inst_fifo_gen/gconvfifo.rf/grf.rf/gntv_or_sync_fifo.mem/gbm.gbmg.gbmga.ngecc.bmg/inst_blk_mem_gen/gnbram.gnativebmg.native_blk_mem_gen/valid.cstr/ramloop[0].ram.r/prim_noinit.ram | rd_ddr3_fifo_blk_mem_gen_prim_wrapper | blk_mem_gen_prim_wrapper
ddr3_ctrl_2port/fabric/video/rd_ddr3_fifo/U0/inst_fifo_gen/gconvfifo.rf/grf.rf/gntv_or_sync_fifo.mem/gbm.gbmg.gbmga.ngecc.bmg/inst_blk_mem_gen/gnbram.gnativebmg.native_blk_mem_gen/valid.cstr/ramloop[1].ram.r/prim_noinit.ram | rd_ddr3_fifo_blk_mem_gen_prim_wrapper__parameterized0 | blk_mem_gen_prim_wrapper
ddr3_ctrl_2port/fabric/video/rd_ddr3_fifo/U0/inst_fifo_gen/gconvfifo.rf/grf.rf/rstblk/ngwrdrst.grst.g7serrst.gsckt_wrst.gic_rst.xpm_cdc_single_inst_rrst_wr | rd_ddr3_fifo_xpm_cdc_single | xpm_cdc_single
ddr3_ctrl_2port/fabric/video/rd_ddr3_fifo/U0/inst_fifo_gen/gconvfifo.rf/grf.rf/rstblk/ngwrdrst.grst.g7serrst.gsckt_wrst.gic_rst.xpm_cdc_single_inst_wrst_rd | rd_ddr3_fifo_xpm_cdc_single__2 | xpm_cdc_single
ddr3_ctrl_2port/fabric/video/rd_ddr3_fifo/U0/inst_fifo_gen/gconvfifo.rf/grf.rf/rstblk/ngwrdrst.grst.g7serrst.gsckt_wrst.gic_rst.xpm_cdc_sync_rst_inst_wrst | rd_ddr3_fifo_xpm_cdc_sync_rst | xpm_cdc_sync_rst
ddr3_ctrl_2port/fabric/video/rd_ddr3_fifo/U0/inst_fifo_gen/gconvfifo.rf/grf.rf/rstblk/ngwrdrst.grst.g7serrst.gsckt_wrst.xpm_cdc_sync_rst_inst_wrst | rd_ddr3_fifo_xpm_cdc_sync_rst__2 | xpm_cdc_sync_rst
ddr3_ctrl_2port/fabric/video/wr_ddr3_fifo/U0 | wr_ddr3_fifo_fifo_generator_v13_2_3 | fifo_generator_v13_2_3
ddr3_ctrl_2port/fabric/video/wr_ddr3_fifo/U0/inst_fifo_gen | wr_ddr3_fifo_fifo_generator_v13_2_3_synth | fifo_generator_v13_2_3_synth
ddr3_ctrl_2port/fabric/video/wr_ddr3_fifo/U0/inst_fifo_gen/gconvfifo.rf | wr_ddr3_fifo_fifo_generator_top | fifo_generator_top
ddr3_ctrl_2port/fabric/video/wr_ddr3_fifo/U0/inst_fifo_gen/gconvfifo.rf/grf.rf | wr_ddr3_fifo_fifo_generator_ramfifo | fifo_generator_ramfifo
ddr3_ctrl_2port/fabric/video/wr_ddr3_fifo/U0/inst_fifo_gen/gconvfifo.rf/grf.rf/gntv_or_sync_fifo.gcx.clkx | wr_ddr3_fifo_clk_x_pntrs | clk_x_pntrs
ddr3_ctrl_2port/fabric/video/wr_ddr3_fifo/U0/inst_fifo_gen/gconvfifo.rf/grf.rf/gntv_or_sync_fifo.gl0.rd | wr_ddr3_fifo_rd_logic | rd_logic
ddr3_ctrl_2port/fabric/video/wr_ddr3_fifo/U0/inst_fifo_gen/gconvfifo.rf/grf.rf/gntv_or_sync_fifo.gl0.wr | wr_ddr3_fifo_wr_logic | wr_logic
ddr3_ctrl_2port/fabric/video/wr_ddr3_fifo/U0/inst_fifo_gen/gconvfifo.rf/grf.rf/gntv_or_sync_fifo.mem | wr_ddr3_fifo_memory | memory
ddr3_ctrl_2port/fabric/video/wr_ddr3_fifo/U0/inst_fifo_gen/gconvfifo.rf/grf.rf/rstblk | wr_ddr3_fifo_reset_blk_ramfifo | reset_blk_ramfifo
ddr3_ctrl_2port/fabric/video/wr_ddr3_fifo/U0/inst_fifo_gen/gconvfifo.rf/grf.rf/gntv_or_sync_fifo.gcx.clkx/rd_pntr_cdc_inst | wr_ddr3_fifo_xpm_cdc_gray__parameterized1 | xpm_cdc_gray
ddr3_ctrl_2port/fabric/video/wr_ddr3_fifo/U0/inst_fifo_gen/gconvfifo.rf/grf.rf/gntv_or_sync_fifo.gcx.clkx/wr_pntr_cdc_inst | wr_ddr3_fifo_xpm_cdc_gray | xpm_cdc_gray
ddr3_ctrl_2port/fabric/video/wr_ddr3_fifo/U0/inst_fifo_gen/gconvfifo.rf/grf.rf/gntv_or_sync_fifo.gl0.rd/gras.rsts | wr_ddr3_fifo_rd_status_flags_as | rd_status_flags_as
ddr3_ctrl_2port/fabric/video/wr_ddr3_fifo/U0/inst_fifo_gen/gconvfifo.rf/grf.rf/gntv_or_sync_fifo.gl0.rd/rpntr | wr_ddr3_fifo_rd_bin_cntr | rd_bin_cntr
ddr3_ctrl_2port/fabric/video/wr_ddr3_fifo/U0/inst_fifo_gen/gconvfifo.rf/grf.rf/gntv_or_sync_fifo.gl0.wr/gwas.wsts | wr_ddr3_fifo_wr_status_flags_as | wr_status_flags_as
ddr3_ctrl_2port/fabric/video/wr_ddr3_fifo/U0/inst_fifo_gen/gconvfifo.rf/grf.rf/gntv_or_sync_fifo.gl0.wr/wpntr | wr_ddr3_fifo_wr_bin_cntr | wr_bin_cntr
ddr3_ctrl_2port/fabric/video/wr_ddr3_fifo/U0/inst_fifo_gen/gconvfifo.rf/grf.rf/gntv_or_sync_fifo.gl0.wr/gwas.wsts/c1 | wr_ddr3_fifo_compare__parameterized0 | compare
ddr3_ctrl_2port/fabric/video/wr_ddr3_fifo/U0/inst_fifo_gen/gconvfifo.rf/grf.rf/gntv_or_sync_fifo.gl0.wr/gwas.wsts/c2 | wr_ddr3_fifo_compare__parameterized0_0 | compare
ddr3_ctrl_2port/fabric/video/wr_ddr3_fifo/U0/inst_fifo_gen/gconvfifo.rf/grf.rf/gntv_or_sync_fifo.mem/gbm.gbmg.gbmga.ngecc.bmg | wr_ddr3_fifo_blk_mem_gen_v8_4_2 | blk_mem_gen_v8_4_2
ddr3_ctrl_2port/fabric/video/wr_ddr3_fifo/U0/inst_fifo_gen/gconvfifo.rf/grf.rf/gntv_or_sync_fifo.mem/gbm.gbmg.gbmga.ngecc.bmg/inst_blk_mem_gen | wr_ddr3_fifo_blk_mem_gen_v8_4_2_synth | blk_mem_gen_v8_4_2_synth
ddr3_ctrl_2port/fabric/video/wr_ddr3_fifo/U0/inst_fifo_gen/gconvfifo.rf/grf.rf/gntv_or_sync_fifo.mem/gbm.gbmg.gbmga.ngecc.bmg/inst_blk_mem_gen/gnbram.gnativebmg.native_blk_mem_gen | wr_ddr3_fifo_blk_mem_gen_top | blk_mem_gen_top
ddr3_ctrl_2port/fabric/video/wr_ddr3_fifo/U0/inst_fifo_gen/gconvfifo.rf/grf.rf/gntv_or_sync_fifo.mem/gbm.gbmg.gbmga.ngecc.bmg/inst_blk_mem_gen/gnbram.gnativebmg.native_blk_mem_gen/valid.cstr | wr_ddr3_fifo_blk_mem_gen_generic_cstr | blk_mem_gen_generic_cstr
ddr3_ctrl_2port/fabric/video/wr_ddr3_fifo/U0/inst_fifo_gen/gconvfifo.rf/grf.rf/gntv_or_sync_fifo.mem/gbm.gbmg.gbmga.ngecc.bmg/inst_blk_mem_gen/gnbram.gnativebmg.native_blk_mem_gen/valid.cstr/ramloop[0].ram.r | wr_ddr3_fifo_blk_mem_gen_prim_width | blk_mem_gen_prim_width
ddr3_ctrl_2port/fabric/video/wr_ddr3_fifo/U0/inst_fifo_gen/gconvfifo.rf/grf.rf/gntv_or_sync_fifo.mem/gbm.gbmg.gbmga.ngecc.bmg/inst_blk_mem_gen/gnbram.gnativebmg.native_blk_mem_gen/valid.cstr/ramloop[1].ram.r | wr_ddr3_fifo_blk_mem_gen_prim_width__parameterized0 | blk_mem_gen_prim_width
ddr3_ctrl_2port/fabric/video/wr_ddr3_fifo/U0/inst_fifo_gen/gconvfifo.rf/grf.rf/gntv_or_sync_fifo.mem/gbm.gbmg.gbmga.ngecc.bmg/inst_blk_mem_gen/gnbram.gnativebmg.native_blk_mem_gen/valid.cstr/ramloop[0].ram.r/prim_noinit.ram | wr_ddr3_fifo_blk_mem_gen_prim_wrapper | blk_mem_gen_prim_wrapper
ddr3_ctrl_2port/fabric/video/wr_ddr3_fifo/U0/inst_fifo_gen/gconvfifo.rf/grf.rf/gntv_or_sync_fifo.mem/gbm.gbmg.gbmga.ngecc.bmg/inst_blk_mem_gen/gnbram.gnativebmg.native_blk_mem_gen/valid.cstr/ramloop[1].ram.r/prim_noinit.ram | wr_ddr3_fifo_blk_mem_gen_prim_wrapper__parameterized0 | blk_mem_gen_prim_wrapper
ddr3_ctrl_2port/fabric/video/wr_ddr3_fifo/U0/inst_fifo_gen/gconvfifo.rf/grf.rf/rstblk/ngwrdrst.grst.g7serrst.gsckt_wrst.gic_rst.xpm_cdc_single_inst_rrst_wr | wr_ddr3_fifo_xpm_cdc_single | xpm_cdc_single
ddr3_ctrl_2port/fabric/video/wr_ddr3_fifo/U0/inst_fifo_gen/gconvfifo.rf/grf.rf/rstblk/ngwrdrst.grst.g7serrst.gsckt_wrst.gic_rst.xpm_cdc_single_inst_wrst_rd | wr_ddr3_fifo_xpm_cdc_single__2 | xpm_cdc_single
ddr3_ctrl_2port/fabric/video/wr_ddr3_fifo/U0/inst_fifo_gen/gconvfifo.rf/grf.rf/rstblk/ngwrdrst.grst.g7serrst.gsckt_wrst.gic_rst.xpm_cdc_sync_rst_inst_wrst | wr_ddr3_fifo_xpm_cdc_sync_rst | xpm_cdc_sync_rst
ddr3_ctrl_2port/fabric/video/wr_ddr3_fifo/U0/inst_fifo_gen/gconvfifo.rf/grf.rf/rstblk/ngwrdrst.grst.g7serrst.gsckt_wrst.xpm_cdc_sync_rst_inst_wrst | wr_ddr3_fifo_xpm_cdc_sync_rst__2 | xpm_cdc_sync_rst
ddr3_ctrl_2port/u_mig_7series_0/u_mig_7series_0_mig | mig_7series_0_mig
ddr3_ctrl_2port/u_mig_7series_0/u_mig_7series_0_mig/temp_mon_enabled.u_tempmon | mig_7series_v4_2_tempmon
ddr3_ctrl_2port/u_mig_7series_0/u_mig_7series_0_mig/u_ddr3_clk_ibuf | mig_7series_v4_2_clk_ibuf
ddr3_ctrl_2port/u_mig_7series_0/u_mig_7series_0_mig/u_ddr3_infrastructure | mig_7series_v4_2_infrastructure
ddr3_ctrl_2port/u_mig_7series_0/u_mig_7series_0_mig/u_iodelay_ctrl | mig_7series_v4_2_iodelay_ctrl
ddr3_ctrl_2port/u_mig_7series_0/u_mig_7series_0_mig/u_memc_ui_top_axi | mig_7series_v4_2_memc_ui_top_axi
ddr3_ctrl_2port/u_mig_7series_0/u_mig_7series_0_mig/temp_mon_enabled.u_tempmon/xadc_supplied_temperature.shared_monitor | shared_xadc_monitor
ddr3_ctrl_2port/u_mig_7series_0/u_mig_7series_0_mig/temp_mon_enabled.u_tempmon/xadc_supplied_temperature.shared_monitor/reader | xadc_monitor_reader
ddr3_ctrl_2port/u_mig_7series_0/u_mig_7series_0_mig/u_memc_ui_top_axi/mem_intfc0 | mig_7series_v4_2_mem_intfc
ddr3_ctrl_2port/u_mig_7series_0/u_mig_7series_0_mig/u_memc_ui_top_axi/u_axi_mc | mig_7series_v4_2_axi_mc
ddr3_ctrl_2port/u_mig_7series_0/u_mig_7series_0_mig/u_memc_ui_top_axi/u_ui_top | mig_7series_v4_2_ui_top
ddr3_ctrl_2port/u_mig_7series_0/u_mig_7series_0_mig/u_memc_ui_top_axi/mem_intfc0/ddr_phy_top0 | mig_7series_v4_2_ddr_phy_top
ddr3_ctrl_2port/u_mig_7series_0/u_mig_7series_0_mig/u_memc_ui_top_axi/mem_intfc0/mc0 | mig_7series_v4_2_mc
ddr3_ctrl_2port/u_mig_7series_0/u_mig_7series_0_mig/u_memc_ui_top_axi/mem_intfc0/ddr_phy_top0/u_ddr_calib_top | mig_7series_v4_2_ddr_calib_top
ddr3_ctrl_2port/u_mig_7series_0/u_mig_7series_0_mig/u_memc_ui_top_axi/mem_intfc0/ddr_phy_top0/u_ddr_mc_phy_wrapper | mig_7series_v4_2_ddr_mc_phy_wrapper
ddr3_ctrl_2port/u_mig_7series_0/u_mig_7series_0_mig/u_memc_ui_top_axi/mem_intfc0/ddr_phy_top0/u_ddr_calib_top/ddr_phy_prbs_rdlvl_gen.u_ddr_phy_prbs_rdlvl | mig_7series_v4_2_ddr_phy_prbs_rdlvl
ddr3_ctrl_2port/u_mig_7series_0/u_mig_7series_0_mig/u_memc_ui_top_axi/mem_intfc0/ddr_phy_top0/u_ddr_calib_top/ddr_phy_rdlvl_gen.u_ddr_phy_rdlvl | mig_7series_v4_2_ddr_phy_rdlvl
ddr3_ctrl_2port/u_mig_7series_0/u_mig_7series_0_mig/u_memc_ui_top_axi/mem_intfc0/ddr_phy_top0/u_ddr_calib_top/ddr_phy_tempmon_0 | mig_7series_v4_2_ddr_phy_tempmon
ddr3_ctrl_2port/u_mig_7series_0/u_mig_7series_0_mig/u_memc_ui_top_axi/mem_intfc0/ddr_phy_top0/u_ddr_calib_top/dqsfind_calib_left.u_ddr_phy_dqs_found_cal_hr | mig_7series_v4_2_ddr_phy_dqs_found_cal_hr
ddr3_ctrl_2port/u_mig_7series_0/u_mig_7series_0_mig/u_memc_ui_top_axi/mem_intfc0/ddr_phy_top0/u_ddr_calib_top/mb_wrlvl_inst.u_ddr_phy_ck_addr_cmd_delay | mig_7series_v4_2_ddr_phy_ck_addr_cmd_delay
ddr3_ctrl_2port/u_mig_7series_0/u_mig_7series_0_mig/u_memc_ui_top_axi/mem_intfc0/ddr_phy_top0/u_ddr_calib_top/mb_wrlvl_inst.u_ddr_phy_wrlvl | mig_7series_v4_2_ddr_phy_wrlvl
ddr3_ctrl_2port/u_mig_7series_0/u_mig_7series_0_mig/u_memc_ui_top_axi/mem_intfc0/ddr_phy_top0/u_ddr_calib_top/u_ddr_phy_init | mig_7series_v4_2_ddr_phy_init
ddr3_ctrl_2port/u_mig_7series_0/u_mig_7series_0_mig/u_memc_ui_top_axi/mem_intfc0/ddr_phy_top0/u_ddr_calib_top/u_ddr_phy_wrcal | mig_7series_v4_2_ddr_phy_wrcal
ddr3_ctrl_2port/u_mig_7series_0/u_mig_7series_0_mig/u_memc_ui_top_axi/mem_intfc0/ddr_phy_top0/u_ddr_calib_top/u_ddr_prbs_gen | mig_7series_v4_2_ddr_prbs_gen
ddr3_ctrl_2port/u_mig_7series_0/u_mig_7series_0_mig/u_memc_ui_top_axi/mem_intfc0/ddr_phy_top0/u_ddr_mc_phy_wrapper/u_ddr_mc_phy | mig_7series_v4_2_ddr_mc_phy
ddr3_ctrl_2port/u_mig_7series_0/u_mig_7series_0_mig/u_memc_ui_top_axi/mem_intfc0/ddr_phy_top0/u_ddr_mc_phy_wrapper/u_ddr_mc_phy/ddr_phy_4lanes_0.u_ddr_phy_4lanes | mig_7series_v4_2_ddr_phy_4lanes
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
ddr3_ctrl_2port/u_mig_7series_0/u_mig_7series_0_mig/u_memc_ui_top_axi/mem_intfc0/ddr_phy_top0/u_ddr_mc_phy_wrapper/u_ddr_mc_phy/ddr_phy_4lanes_1.u_ddr_phy_4lanes/ddr_byte_lane_D.ddr_byte_lane_D/of_pre_fifo_gen.u_ddr_of_pre_fifo | mig_7series_v4_2_ddr_of_pre_fifo__parameterized1 | mig_7series_v4_2_ddr_of_pre_fifo
ddr3_ctrl_2port/u_mig_7series_0/u_mig_7series_0_mig/u_memc_ui_top_axi/mem_intfc0/mc0/bank_mach0 | mig_7series_v4_2_bank_mach
ddr3_ctrl_2port/u_mig_7series_0/u_mig_7series_0_mig/u_memc_ui_top_axi/mem_intfc0/mc0/col_mach0 | mig_7series_v4_2_col_mach
ddr3_ctrl_2port/u_mig_7series_0/u_mig_7series_0_mig/u_memc_ui_top_axi/mem_intfc0/mc0/rank_mach0 | mig_7series_v4_2_rank_mach
ddr3_ctrl_2port/u_mig_7series_0/u_mig_7series_0_mig/u_memc_ui_top_axi/mem_intfc0/mc0/bank_mach0/arb_mux0 | mig_7series_v4_2_arb_mux
ddr3_ctrl_2port/u_mig_7series_0/u_mig_7series_0_mig/u_memc_ui_top_axi/mem_intfc0/mc0/bank_mach0/bank_cntrl[0].bank0 | mig_7series_v4_2_bank_cntrl
ddr3_ctrl_2port/u_mig_7series_0/u_mig_7series_0_mig/u_memc_ui_top_axi/mem_intfc0/mc0/bank_mach0/bank_cntrl[1].bank0 | mig_7series_v4_2_bank_cntrl__parameterized0 | mig_7series_v4_2_bank_cntrl
ddr3_ctrl_2port/u_mig_7series_0/u_mig_7series_0_mig/u_memc_ui_top_axi/mem_intfc0/mc0/bank_mach0/bank_cntrl[2].bank0 | mig_7series_v4_2_bank_cntrl__parameterized1 | mig_7series_v4_2_bank_cntrl
ddr3_ctrl_2port/u_mig_7series_0/u_mig_7series_0_mig/u_memc_ui_top_axi/mem_intfc0/mc0/bank_mach0/bank_cntrl[3].bank0 | mig_7series_v4_2_bank_cntrl__parameterized2 | mig_7series_v4_2_bank_cntrl
ddr3_ctrl_2port/u_mig_7series_0/u_mig_7series_0_mig/u_memc_ui_top_axi/mem_intfc0/mc0/bank_mach0/bank_cntrl[4].bank0 | mig_7series_v4_2_bank_cntrl__parameterized3 | mig_7series_v4_2_bank_cntrl
ddr3_ctrl_2port/u_mig_7series_0/u_mig_7series_0_mig/u_memc_ui_top_axi/mem_intfc0/mc0/bank_mach0/bank_cntrl[5].bank0 | mig_7series_v4_2_bank_cntrl__parameterized4 | mig_7series_v4_2_bank_cntrl
ddr3_ctrl_2port/u_mig_7series_0/u_mig_7series_0_mig/u_memc_ui_top_axi/mem_intfc0/mc0/bank_mach0/bank_cntrl[6].bank0 | mig_7series_v4_2_bank_cntrl__parameterized5 | mig_7series_v4_2_bank_cntrl
ddr3_ctrl_2port/u_mig_7series_0/u_mig_7series_0_mig/u_memc_ui_top_axi/mem_intfc0/mc0/bank_mach0/bank_cntrl[7].bank0 | mig_7series_v4_2_bank_cntrl__parameterized6 | mig_7series_v4_2_bank_cntrl
ddr3_ctrl_2port/u_mig_7series_0/u_mig_7series_0_mig/u_memc_ui_top_axi/mem_intfc0/mc0/bank_mach0/bank_common0 | mig_7series_v4_2_bank_common
ddr3_ctrl_2port/u_mig_7series_0/u_mig_7series_0_mig/u_memc_ui_top_axi/mem_intfc0/mc0/bank_mach0/arb_mux0/arb_row_col0 | mig_7series_v4_2_arb_row_col
ddr3_ctrl_2port/u_mig_7series_0/u_mig_7series_0_mig/u_memc_ui_top_axi/mem_intfc0/mc0/bank_mach0/arb_mux0/arb_select0 | mig_7series_v4_2_arb_select
ddr3_ctrl_2port/u_mig_7series_0/u_mig_7series_0_mig/u_memc_ui_top_axi/mem_intfc0/mc0/bank_mach0/arb_mux0/arb_row_col0/col_arb0 | mig_7series_v4_2_round_robin_arb__parameterized1 | mig_7series_v4_2_round_robin_arb
ddr3_ctrl_2port/u_mig_7series_0/u_mig_7series_0_mig/u_memc_ui_top_axi/mem_intfc0/mc0/bank_mach0/arb_mux0/arb_row_col0/pre_4_1_1T_arb.pre_arb0 | mig_7series_v4_2_round_robin_arb__parameterized1_118 | mig_7series_v4_2_round_robin_arb
ddr3_ctrl_2port/u_mig_7series_0/u_mig_7series_0_mig/u_memc_ui_top_axi/mem_intfc0/mc0/bank_mach0/arb_mux0/arb_row_col0/row_arb0 | mig_7series_v4_2_round_robin_arb__parameterized1_119 | mig_7series_v4_2_round_robin_arb
ddr3_ctrl_2port/u_mig_7series_0/u_mig_7series_0_mig/u_memc_ui_top_axi/mem_intfc0/mc0/bank_mach0/bank_cntrl[0].bank0/bank_compare0 | mig_7series_v4_2_bank_compare_117 | mig_7series_v4_2_bank_compare
ddr3_ctrl_2port/u_mig_7series_0/u_mig_7series_0_mig/u_memc_ui_top_axi/mem_intfc0/mc0/bank_mach0/bank_cntrl[0].bank0/bank_queue0 | mig_7series_v4_2_bank_queue
ddr3_ctrl_2port/u_mig_7series_0/u_mig_7series_0_mig/u_memc_ui_top_axi/mem_intfc0/mc0/bank_mach0/bank_cntrl[0].bank0/bank_state0 | mig_7series_v4_2_bank_state
ddr3_ctrl_2port/u_mig_7series_0/u_mig_7series_0_mig/u_memc_ui_top_axi/mem_intfc0/mc0/bank_mach0/bank_cntrl[1].bank0/bank_compare0 | mig_7series_v4_2_bank_compare_116 | mig_7series_v4_2_bank_compare
ddr3_ctrl_2port/u_mig_7series_0/u_mig_7series_0_mig/u_memc_ui_top_axi/mem_intfc0/mc0/bank_mach0/bank_cntrl[1].bank0/bank_queue0 | mig_7series_v4_2_bank_queue__parameterized0 | mig_7series_v4_2_bank_queue
ddr3_ctrl_2port/u_mig_7series_0/u_mig_7series_0_mig/u_memc_ui_top_axi/mem_intfc0/mc0/bank_mach0/bank_cntrl[1].bank0/bank_state0 | mig_7series_v4_2_bank_state__parameterized0 | mig_7series_v4_2_bank_state
ddr3_ctrl_2port/u_mig_7series_0/u_mig_7series_0_mig/u_memc_ui_top_axi/mem_intfc0/mc0/bank_mach0/bank_cntrl[2].bank0/bank_compare0 | mig_7series_v4_2_bank_compare_115 | mig_7series_v4_2_bank_compare
ddr3_ctrl_2port/u_mig_7series_0/u_mig_7series_0_mig/u_memc_ui_top_axi/mem_intfc0/mc0/bank_mach0/bank_cntrl[2].bank0/bank_queue0 | mig_7series_v4_2_bank_queue__parameterized1 | mig_7series_v4_2_bank_queue
ddr3_ctrl_2port/u_mig_7series_0/u_mig_7series_0_mig/u_memc_ui_top_axi/mem_intfc0/mc0/bank_mach0/bank_cntrl[2].bank0/bank_state0 | mig_7series_v4_2_bank_state__parameterized1 | mig_7series_v4_2_bank_state
ddr3_ctrl_2port/u_mig_7series_0/u_mig_7series_0_mig/u_memc_ui_top_axi/mem_intfc0/mc0/bank_mach0/bank_cntrl[3].bank0/bank_compare0 | mig_7series_v4_2_bank_compare_114 | mig_7series_v4_2_bank_compare
ddr3_ctrl_2port/u_mig_7series_0/u_mig_7series_0_mig/u_memc_ui_top_axi/mem_intfc0/mc0/bank_mach0/bank_cntrl[3].bank0/bank_queue0 | mig_7series_v4_2_bank_queue__parameterized2 | mig_7series_v4_2_bank_queue
ddr3_ctrl_2port/u_mig_7series_0/u_mig_7series_0_mig/u_memc_ui_top_axi/mem_intfc0/mc0/bank_mach0/bank_cntrl[3].bank0/bank_state0 | mig_7series_v4_2_bank_state__parameterized2 | mig_7series_v4_2_bank_state
ddr3_ctrl_2port/u_mig_7series_0/u_mig_7series_0_mig/u_memc_ui_top_axi/mem_intfc0/mc0/bank_mach0/bank_cntrl[4].bank0/bank_compare0 | mig_7series_v4_2_bank_compare_113 | mig_7series_v4_2_bank_compare
ddr3_ctrl_2port/u_mig_7series_0/u_mig_7series_0_mig/u_memc_ui_top_axi/mem_intfc0/mc0/bank_mach0/bank_cntrl[4].bank0/bank_queue0 | mig_7series_v4_2_bank_queue__parameterized3 | mig_7series_v4_2_bank_queue
ddr3_ctrl_2port/u_mig_7series_0/u_mig_7series_0_mig/u_memc_ui_top_axi/mem_intfc0/mc0/bank_mach0/bank_cntrl[4].bank0/bank_state0 | mig_7series_v4_2_bank_state__parameterized3 | mig_7series_v4_2_bank_state
ddr3_ctrl_2port/u_mig_7series_0/u_mig_7series_0_mig/u_memc_ui_top_axi/mem_intfc0/mc0/bank_mach0/bank_cntrl[5].bank0/bank_compare0 | mig_7series_v4_2_bank_compare_112 | mig_7series_v4_2_bank_compare
ddr3_ctrl_2port/u_mig_7series_0/u_mig_7series_0_mig/u_memc_ui_top_axi/mem_intfc0/mc0/bank_mach0/bank_cntrl[5].bank0/bank_queue0 | mig_7series_v4_2_bank_queue__parameterized4 | mig_7series_v4_2_bank_queue
ddr3_ctrl_2port/u_mig_7series_0/u_mig_7series_0_mig/u_memc_ui_top_axi/mem_intfc0/mc0/bank_mach0/bank_cntrl[5].bank0/bank_state0 | mig_7series_v4_2_bank_state__parameterized4 | mig_7series_v4_2_bank_state
ddr3_ctrl_2port/u_mig_7series_0/u_mig_7series_0_mig/u_memc_ui_top_axi/mem_intfc0/mc0/bank_mach0/bank_cntrl[6].bank0/bank_compare0 | mig_7series_v4_2_bank_compare_111 | mig_7series_v4_2_bank_compare
ddr3_ctrl_2port/u_mig_7series_0/u_mig_7series_0_mig/u_memc_ui_top_axi/mem_intfc0/mc0/bank_mach0/bank_cntrl[6].bank0/bank_queue0 | mig_7series_v4_2_bank_queue__parameterized5 | mig_7series_v4_2_bank_queue
ddr3_ctrl_2port/u_mig_7series_0/u_mig_7series_0_mig/u_memc_ui_top_axi/mem_intfc0/mc0/bank_mach0/bank_cntrl[6].bank0/bank_state0 | mig_7series_v4_2_bank_state__parameterized5 | mig_7series_v4_2_bank_state
ddr3_ctrl_2port/u_mig_7series_0/u_mig_7series_0_mig/u_memc_ui_top_axi/mem_intfc0/mc0/bank_mach0/bank_cntrl[7].bank0/bank_compare0 | mig_7series_v4_2_bank_compare
ddr3_ctrl_2port/u_mig_7series_0/u_mig_7series_0_mig/u_memc_ui_top_axi/mem_intfc0/mc0/bank_mach0/bank_cntrl[7].bank0/bank_queue0 | mig_7series_v4_2_bank_queue__parameterized6 | mig_7series_v4_2_bank_queue
ddr3_ctrl_2port/u_mig_7series_0/u_mig_7series_0_mig/u_memc_ui_top_axi/mem_intfc0/mc0/bank_mach0/bank_cntrl[7].bank0/bank_state0 | mig_7series_v4_2_bank_state__parameterized6 | mig_7series_v4_2_bank_state
ddr3_ctrl_2port/u_mig_7series_0/u_mig_7series_0_mig/u_memc_ui_top_axi/mem_intfc0/mc0/rank_mach0/rank_cntrl[0].rank_cntrl0 | mig_7series_v4_2_rank_cntrl
ddr3_ctrl_2port/u_mig_7series_0/u_mig_7series_0_mig/u_memc_ui_top_axi/mem_intfc0/mc0/rank_mach0/rank_common0 | mig_7series_v4_2_rank_common
ddr3_ctrl_2port/u_mig_7series_0/u_mig_7series_0_mig/u_memc_ui_top_axi/mem_intfc0/mc0/rank_mach0/rank_common0/maintenance_request.maint_arb0 | mig_7series_v4_2_round_robin_arb
ddr3_ctrl_2port/u_mig_7series_0/u_mig_7series_0_mig/u_memc_ui_top_axi/u_axi_mc/USE_UPSIZER.upsizer_d2 | mig_7series_v4_2_ddr_axi_upsizer
ddr3_ctrl_2port/u_mig_7series_0/u_mig_7series_0_mig/u_memc_ui_top_axi/u_axi_mc/axi_mc_ar_channel_0 | mig_7series_v4_2_axi_mc_ar_channel
ddr3_ctrl_2port/u_mig_7series_0/u_mig_7series_0_mig/u_memc_ui_top_axi/u_axi_mc/axi_mc_aw_channel_0 | mig_7series_v4_2_axi_mc_aw_channel
ddr3_ctrl_2port/u_mig_7series_0/u_mig_7series_0_mig/u_memc_ui_top_axi/u_axi_mc/axi_mc_b_channel_0 | mig_7series_v4_2_axi_mc_b_channel
ddr3_ctrl_2port/u_mig_7series_0/u_mig_7series_0_mig/u_memc_ui_top_axi/u_axi_mc/axi_mc_cmd_arbiter_0 | mig_7series_v4_2_axi_mc_cmd_arbiter
ddr3_ctrl_2port/u_mig_7series_0/u_mig_7series_0_mig/u_memc_ui_top_axi/u_axi_mc/axi_mc_r_channel_0 | mig_7series_v4_2_axi_mc_r_channel
ddr3_ctrl_2port/u_mig_7series_0/u_mig_7series_0_mig/u_memc_ui_top_axi/u_axi_mc/axi_mc_w_channel_0 | mig_7series_v4_2_axi_mc_w_channel
ddr3_ctrl_2port/u_mig_7series_0/u_mig_7series_0_mig/u_memc_ui_top_axi/u_axi_mc/USE_UPSIZER.upsizer_d2/USE_READ.read_addr_inst | mig_7series_v4_2_ddr_a_upsizer__parameterized0 | mig_7series_v4_2_ddr_a_upsizer
ddr3_ctrl_2port/u_mig_7series_0/u_mig_7series_0_mig/u_memc_ui_top_axi/u_axi_mc/USE_UPSIZER.upsizer_d2/USE_READ.read_data_inst | mig_7series_v4_2_ddr_r_upsizer
ddr3_ctrl_2port/u_mig_7series_0/u_mig_7series_0_mig/u_memc_ui_top_axi/u_axi_mc/USE_UPSIZER.upsizer_d2/USE_WRITE.write_addr_inst | mig_7series_v4_2_ddr_a_upsizer
ddr3_ctrl_2port/u_mig_7series_0/u_mig_7series_0_mig/u_memc_ui_top_axi/u_axi_mc/USE_UPSIZER.upsizer_d2/USE_WRITE.write_data_inst | mig_7series_v4_2_ddr_w_upsizer
ddr3_ctrl_2port/u_mig_7series_0/u_mig_7series_0_mig/u_memc_ui_top_axi/u_axi_mc/USE_UPSIZER.upsizer_d2/mi_register_slice_inst | mig_7series_v4_2_ddr_axi_register_slice__parameterized0 | mig_7series_v4_2_ddr_axi_register_slice
ddr3_ctrl_2port/u_mig_7series_0/u_mig_7series_0_mig/u_memc_ui_top_axi/u_axi_mc/USE_UPSIZER.upsizer_d2/si_register_slice_inst | mig_7series_v4_2_ddr_axi_register_slice
ddr3_ctrl_2port/u_mig_7series_0/u_mig_7series_0_mig/u_memc_ui_top_axi/u_axi_mc/USE_UPSIZER.upsizer_d2/USE_READ.read_addr_inst/USE_BURSTS.cmd_queue | mig_7series_v4_2_ddr_command_fifo_97 | mig_7series_v4_2_ddr_command_fifo
ddr3_ctrl_2port/u_mig_7series_0/u_mig_7series_0_mig/u_memc_ui_top_axi/u_axi_mc/USE_UPSIZER.upsizer_d2/USE_READ.read_addr_inst/USE_FPGA_ADJUSTED_LEN.LUT_LAST_MASK[0].last_mask_inst | mig_7series_v4_2_ddr_carry_latch_and_98 | mig_7series_v4_2_ddr_carry_latch_and
ddr3_ctrl_2port/u_mig_7series_0/u_mig_7series_0_mig/u_memc_ui_top_axi/u_axi_mc/USE_UPSIZER.upsizer_d2/USE_READ.read_addr_inst/USE_FPGA_ADJUSTED_LEN.LUT_LAST_MASK[1].last_mask_inst | mig_7series_v4_2_ddr_carry_latch_and_99 | mig_7series_v4_2_ddr_carry_latch_and
ddr3_ctrl_2port/u_mig_7series_0/u_mig_7series_0_mig/u_memc_ui_top_axi/u_axi_mc/USE_UPSIZER.upsizer_d2/USE_READ.read_addr_inst/USE_FPGA_ADJUSTED_LEN.LUT_LAST_MASK[2].last_mask_inst | mig_7series_v4_2_ddr_carry_latch_and_100 | mig_7series_v4_2_ddr_carry_latch_and
ddr3_ctrl_2port/u_mig_7series_0/u_mig_7series_0_mig/u_memc_ui_top_axi/u_axi_mc/USE_UPSIZER.upsizer_d2/USE_READ.read_addr_inst/USE_FPGA_ADJUSTED_LEN.LUT_LAST_MASK[3].last_mask_inst | mig_7series_v4_2_ddr_carry_latch_and_101 | mig_7series_v4_2_ddr_carry_latch_and
ddr3_ctrl_2port/u_mig_7series_0/u_mig_7series_0_mig/u_memc_ui_top_axi/u_axi_mc/USE_UPSIZER.upsizer_d2/USE_READ.read_addr_inst/USE_FPGA_ADJUSTED_LEN.LUT_LAST_MASK[4].last_mask_inst | mig_7series_v4_2_ddr_carry_latch_and_102 | mig_7series_v4_2_ddr_carry_latch_and
ddr3_ctrl_2port/u_mig_7series_0/u_mig_7series_0_mig/u_memc_ui_top_axi/u_axi_mc/USE_UPSIZER.upsizer_d2/USE_READ.read_addr_inst/USE_FPGA_ADJUSTED_LEN.access_need_extra_word_inst | mig_7series_v4_2_ddr_carry_and_103 | mig_7series_v4_2_ddr_carry_and
ddr3_ctrl_2port/u_mig_7series_0/u_mig_7series_0_mig/u_memc_ui_top_axi/u_axi_mc/USE_UPSIZER.upsizer_d2/USE_READ.read_addr_inst/USE_BURSTS.cmd_queue/USE_FPGA_VALID_WRITE.new_write_inst | mig_7series_v4_2_ddr_carry_latch_or_104 | mig_7series_v4_2_ddr_carry_latch_or
ddr3_ctrl_2port/u_mig_7series_0/u_mig_7series_0_mig/u_memc_ui_top_axi/u_axi_mc/USE_UPSIZER.upsizer_d2/USE_READ.read_addr_inst/USE_BURSTS.cmd_queue/USE_FPGA_VALID_WRITE.s_valid_dummy_inst1 | mig_7series_v4_2_ddr_carry_and_105 | mig_7series_v4_2_ddr_carry_and
ddr3_ctrl_2port/u_mig_7series_0/u_mig_7series_0_mig/u_memc_ui_top_axi/u_axi_mc/USE_UPSIZER.upsizer_d2/USE_READ.read_addr_inst/USE_BURSTS.cmd_queue/USE_FPGA_VALID_WRITE.s_valid_dummy_inst2 | mig_7series_v4_2_ddr_carry_and_106 | mig_7series_v4_2_ddr_carry_and
ddr3_ctrl_2port/u_mig_7series_0/u_mig_7series_0_mig/u_memc_ui_top_axi/u_axi_mc/USE_UPSIZER.upsizer_d2/USE_READ.read_addr_inst/USE_BURSTS.cmd_queue/USE_FPGA_VALID_WRITE.valid_write_dummy_inst1 | mig_7series_v4_2_ddr_carry_and_107 | mig_7series_v4_2_ddr_carry_and
ddr3_ctrl_2port/u_mig_7series_0/u_mig_7series_0_mig/u_memc_ui_top_axi/u_axi_mc/USE_UPSIZER.upsizer_d2/USE_READ.read_addr_inst/USE_BURSTS.cmd_queue/USE_FPGA_VALID_WRITE.valid_write_dummy_inst2 | mig_7series_v4_2_ddr_carry_and_108 | mig_7series_v4_2_ddr_carry_and
ddr3_ctrl_2port/u_mig_7series_0/u_mig_7series_0_mig/u_memc_ui_top_axi/u_axi_mc/USE_UPSIZER.upsizer_d2/USE_READ.read_addr_inst/USE_BURSTS.cmd_queue/USE_FPGA_VALID_WRITE.valid_write_dummy_inst3 | mig_7series_v4_2_ddr_carry_and_109 | mig_7series_v4_2_ddr_carry_and
ddr3_ctrl_2port/u_mig_7series_0/u_mig_7series_0_mig/u_memc_ui_top_axi/u_axi_mc/USE_UPSIZER.upsizer_d2/USE_READ.read_addr_inst/USE_BURSTS.cmd_queue/USE_FPGA_VALID_WRITE.valid_write_inst | mig_7series_v4_2_ddr_carry_and_110 | mig_7series_v4_2_ddr_carry_and
ddr3_ctrl_2port/u_mig_7series_0/u_mig_7series_0_mig/u_memc_ui_top_axi/u_axi_mc/USE_UPSIZER.upsizer_d2/USE_READ.read_data_inst/USE_FPGA_CTRL.cmd_ready_inst | mig_7series_v4_2_ddr_carry_latch_and_72 | mig_7series_v4_2_ddr_carry_latch_and
ddr3_ctrl_2port/u_mig_7series_0/u_mig_7series_0_mig/u_memc_ui_top_axi/u_axi_mc/USE_UPSIZER.upsizer_d2/USE_READ.read_data_inst/USE_FPGA_LAST_WORD.USE_FPGA_PACK.last_beat_inst_1 | mig_7series_v4_2_ddr_carry_and_73 | mig_7series_v4_2_ddr_carry_and
ddr3_ctrl_2port/u_mig_7series_0/u_mig_7series_0_mig/u_memc_ui_top_axi/u_axi_mc/USE_UPSIZER.upsizer_d2/USE_READ.read_data_inst/USE_FPGA_LAST_WORD.USE_FPGA_PACK.last_beat_wrap_inst | mig_7series_v4_2_ddr_carry_or_74 | mig_7series_v4_2_ddr_carry_or
ddr3_ctrl_2port/u_mig_7series_0/u_mig_7series_0_mig/u_memc_ui_top_axi/u_axi_mc/USE_UPSIZER.upsizer_d2/USE_READ.read_data_inst/USE_FPGA_LAST_WORD.last_beat_curr_word_inst | mig_7series_v4_2_ddr_comparator_sel_75 | mig_7series_v4_2_ddr_comparator_sel
ddr3_ctrl_2port/u_mig_7series_0/u_mig_7series_0_mig/u_memc_ui_top_axi/u_axi_mc/USE_UPSIZER.upsizer_d2/USE_READ.read_data_inst/USE_FPGA_LAST_WORD.last_beat_inst | mig_7series_v4_2_ddr_comparator_sel_static__parameterized0_76 | mig_7series_v4_2_ddr_comparator_sel_static
ddr3_ctrl_2port/u_mig_7series_0/u_mig_7series_0_mig/u_memc_ui_top_axi/u_axi_mc/USE_UPSIZER.upsizer_d2/USE_READ.read_data_inst/USE_FPGA_WORD_COMPLETED.next_word_wrap_inst | mig_7series_v4_2_ddr_comparator_sel_static_77 | mig_7series_v4_2_ddr_comparator_sel_static
ddr3_ctrl_2port/u_mig_7series_0/u_mig_7series_0_mig/u_memc_ui_top_axi/u_axi_mc/USE_UPSIZER.upsizer_d2/USE_READ.read_data_inst/USE_FPGA_WORD_COMPLETED.word_complete_last_word_inst | mig_7series_v4_2_ddr_carry_and_78 | mig_7series_v4_2_ddr_carry_and
ddr3_ctrl_2port/u_mig_7series_0/u_mig_7series_0_mig/u_memc_ui_top_axi/u_axi_mc/USE_UPSIZER.upsizer_d2/USE_READ.read_data_inst/USE_FPGA_WORD_COMPLETED.word_complete_next_wrap_inst | mig_7series_v4_2_ddr_carry_and_79 | mig_7series_v4_2_ddr_carry_and
ddr3_ctrl_2port/u_mig_7series_0/u_mig_7series_0_mig/u_memc_ui_top_axi/u_axi_mc/USE_UPSIZER.upsizer_d2/USE_READ.read_data_inst/USE_FPGA_WORD_COMPLETED.word_complete_next_wrap_pop_inst | mig_7series_v4_2_ddr_carry_and_80 | mig_7series_v4_2_ddr_carry_and
ddr3_ctrl_2port/u_mig_7series_0/u_mig_7series_0_mig/u_memc_ui_top_axi/u_axi_mc/USE_UPSIZER.upsizer_d2/USE_READ.read_data_inst/USE_FPGA_WORD_COMPLETED.word_complete_next_wrap_ready_inst | mig_7series_v4_2_ddr_carry_and_81 | mig_7series_v4_2_ddr_carry_and
ddr3_ctrl_2port/u_mig_7series_0/u_mig_7series_0_mig/u_memc_ui_top_axi/u_axi_mc/USE_UPSIZER.upsizer_d2/USE_READ.read_data_inst/USE_FPGA_WORD_COMPLETED.word_complete_rest_inst | mig_7series_v4_2_ddr_carry_or_82 | mig_7series_v4_2_ddr_carry_or
ddr3_ctrl_2port/u_mig_7series_0/u_mig_7series_0_mig/u_memc_ui_top_axi/u_axi_mc/USE_UPSIZER.upsizer_d2/USE_READ.read_data_inst/USE_FPGA_WORD_COMPLETED.word_complete_rest_pop_inst | mig_7series_v4_2_ddr_carry_and_83 | mig_7series_v4_2_ddr_carry_and
ddr3_ctrl_2port/u_mig_7series_0/u_mig_7series_0_mig/u_memc_ui_top_axi/u_axi_mc/USE_UPSIZER.upsizer_d2/USE_READ.read_data_inst/USE_FPGA_WORD_COMPLETED.word_complete_rest_ready_inst | mig_7series_v4_2_ddr_carry_and_84 | mig_7series_v4_2_ddr_carry_and
ddr3_ctrl_2port/u_mig_7series_0/u_mig_7series_0_mig/u_memc_ui_top_axi/u_axi_mc/USE_UPSIZER.upsizer_d2/USE_READ.read_data_inst/USE_FPGA_LAST_WORD.last_beat_curr_word_inst/LUT_LEVEL[0].compare_inst | mig_7series_v4_2_ddr_carry_and_92 | mig_7series_v4_2_ddr_carry_and
ddr3_ctrl_2port/u_mig_7series_0/u_mig_7series_0_mig/u_memc_ui_top_axi/u_axi_mc/USE_UPSIZER.upsizer_d2/USE_READ.read_data_inst/USE_FPGA_LAST_WORD.last_beat_curr_word_inst/LUT_LEVEL[1].compare_inst | mig_7series_v4_2_ddr_carry_and_93 | mig_7series_v4_2_ddr_carry_and
ddr3_ctrl_2port/u_mig_7series_0/u_mig_7series_0_mig/u_memc_ui_top_axi/u_axi_mc/USE_UPSIZER.upsizer_d2/USE_READ.read_data_inst/USE_FPGA_LAST_WORD.last_beat_curr_word_inst/LUT_LEVEL[2].compare_inst | mig_7series_v4_2_ddr_carry_and_94 | mig_7series_v4_2_ddr_carry_and
ddr3_ctrl_2port/u_mig_7series_0/u_mig_7series_0_mig/u_memc_ui_top_axi/u_axi_mc/USE_UPSIZER.upsizer_d2/USE_READ.read_data_inst/USE_FPGA_LAST_WORD.last_beat_curr_word_inst/LUT_LEVEL[3].compare_inst | mig_7series_v4_2_ddr_carry_and_95 | mig_7series_v4_2_ddr_carry_and
ddr3_ctrl_2port/u_mig_7series_0/u_mig_7series_0_mig/u_memc_ui_top_axi/u_axi_mc/USE_UPSIZER.upsizer_d2/USE_READ.read_data_inst/USE_FPGA_LAST_WORD.last_beat_curr_word_inst/LUT_LEVEL[4].compare_inst | mig_7series_v4_2_ddr_carry_and_96 | mig_7series_v4_2_ddr_carry_and
ddr3_ctrl_2port/u_mig_7series_0/u_mig_7series_0_mig/u_memc_ui_top_axi/u_axi_mc/USE_UPSIZER.upsizer_d2/USE_READ.read_data_inst/USE_FPGA_LAST_WORD.last_beat_inst/LUT_LEVEL[0].compare_inst | mig_7series_v4_2_ddr_carry_and_88 | mig_7series_v4_2_ddr_carry_and
ddr3_ctrl_2port/u_mig_7series_0/u_mig_7series_0_mig/u_memc_ui_top_axi/u_axi_mc/USE_UPSIZER.upsizer_d2/USE_READ.read_data_inst/USE_FPGA_LAST_WORD.last_beat_inst/LUT_LEVEL[1].compare_inst | mig_7series_v4_2_ddr_carry_and_89 | mig_7series_v4_2_ddr_carry_and
ddr3_ctrl_2port/u_mig_7series_0/u_mig_7series_0_mig/u_memc_ui_top_axi/u_axi_mc/USE_UPSIZER.upsizer_d2/USE_READ.read_data_inst/USE_FPGA_LAST_WORD.last_beat_inst/LUT_LEVEL[2].compare_inst | mig_7series_v4_2_ddr_carry_and_90 | mig_7series_v4_2_ddr_carry_and
ddr3_ctrl_2port/u_mig_7series_0/u_mig_7series_0_mig/u_memc_ui_top_axi/u_axi_mc/USE_UPSIZER.upsizer_d2/USE_READ.read_data_inst/USE_FPGA_LAST_WORD.last_beat_inst/LUT_LEVEL[3].compare_inst | mig_7series_v4_2_ddr_carry_and_91 | mig_7series_v4_2_ddr_carry_and
ddr3_ctrl_2port/u_mig_7series_0/u_mig_7series_0_mig/u_memc_ui_top_axi/u_axi_mc/USE_UPSIZER.upsizer_d2/USE_READ.read_data_inst/USE_FPGA_WORD_COMPLETED.next_word_wrap_inst/LUT_LEVEL[0].compare_inst | mig_7series_v4_2_ddr_carry_and_85 | mig_7series_v4_2_ddr_carry_and
ddr3_ctrl_2port/u_mig_7series_0/u_mig_7series_0_mig/u_memc_ui_top_axi/u_axi_mc/USE_UPSIZER.upsizer_d2/USE_READ.read_data_inst/USE_FPGA_WORD_COMPLETED.next_word_wrap_inst/LUT_LEVEL[1].compare_inst | mig_7series_v4_2_ddr_carry_and_86 | mig_7series_v4_2_ddr_carry_and
ddr3_ctrl_2port/u_mig_7series_0/u_mig_7series_0_mig/u_memc_ui_top_axi/u_axi_mc/USE_UPSIZER.upsizer_d2/USE_READ.read_data_inst/USE_FPGA_WORD_COMPLETED.next_word_wrap_inst/LUT_LEVEL[2].compare_inst | mig_7series_v4_2_ddr_carry_and_87 | mig_7series_v4_2_ddr_carry_and
ddr3_ctrl_2port/u_mig_7series_0/u_mig_7series_0_mig/u_memc_ui_top_axi/u_axi_mc/USE_UPSIZER.upsizer_d2/USE_WRITE.write_addr_inst/USE_BURSTS.cmd_queue | mig_7series_v4_2_ddr_command_fifo
ddr3_ctrl_2port/u_mig_7series_0/u_mig_7series_0_mig/u_memc_ui_top_axi/u_axi_mc/USE_UPSIZER.upsizer_d2/USE_WRITE.write_addr_inst/USE_FPGA_ADJUSTED_LEN.LUT_LAST_MASK[0].last_mask_inst | mig_7series_v4_2_ddr_carry_latch_and_60 | mig_7series_v4_2_ddr_carry_latch_and
ddr3_ctrl_2port/u_mig_7series_0/u_mig_7series_0_mig/u_memc_ui_top_axi/u_axi_mc/USE_UPSIZER.upsizer_d2/USE_WRITE.write_addr_inst/USE_FPGA_ADJUSTED_LEN.LUT_LAST_MASK[1].last_mask_inst | mig_7series_v4_2_ddr_carry_latch_and_61 | mig_7series_v4_2_ddr_carry_latch_and
ddr3_ctrl_2port/u_mig_7series_0/u_mig_7series_0_mig/u_memc_ui_top_axi/u_axi_mc/USE_UPSIZER.upsizer_d2/USE_WRITE.write_addr_inst/USE_FPGA_ADJUSTED_LEN.LUT_LAST_MASK[2].last_mask_inst | mig_7series_v4_2_ddr_carry_latch_and_62 | mig_7series_v4_2_ddr_carry_latch_and
ddr3_ctrl_2port/u_mig_7series_0/u_mig_7series_0_mig/u_memc_ui_top_axi/u_axi_mc/USE_UPSIZER.upsizer_d2/USE_WRITE.write_addr_inst/USE_FPGA_ADJUSTED_LEN.LUT_LAST_MASK[3].last_mask_inst | mig_7series_v4_2_ddr_carry_latch_and_63 | mig_7series_v4_2_ddr_carry_latch_and
ddr3_ctrl_2port/u_mig_7series_0/u_mig_7series_0_mig/u_memc_ui_top_axi/u_axi_mc/USE_UPSIZER.upsizer_d2/USE_WRITE.write_addr_inst/USE_FPGA_ADJUSTED_LEN.LUT_LAST_MASK[4].last_mask_inst | mig_7series_v4_2_ddr_carry_latch_and_64 | mig_7series_v4_2_ddr_carry_latch_and
ddr3_ctrl_2port/u_mig_7series_0/u_mig_7series_0_mig/u_memc_ui_top_axi/u_axi_mc/USE_UPSIZER.upsizer_d2/USE_WRITE.write_addr_inst/USE_FPGA_ADJUSTED_LEN.access_need_extra_word_inst | mig_7series_v4_2_ddr_carry_and_65 | mig_7series_v4_2_ddr_carry_and
ddr3_ctrl_2port/u_mig_7series_0/u_mig_7series_0_mig/u_memc_ui_top_axi/u_axi_mc/USE_UPSIZER.upsizer_d2/USE_WRITE.write_addr_inst/USE_BURSTS.cmd_queue/USE_FPGA_VALID_WRITE.new_write_inst | mig_7series_v4_2_ddr_carry_latch_or
ddr3_ctrl_2port/u_mig_7series_0/u_mig_7series_0_mig/u_memc_ui_top_axi/u_axi_mc/USE_UPSIZER.upsizer_d2/USE_WRITE.write_addr_inst/USE_BURSTS.cmd_queue/USE_FPGA_VALID_WRITE.s_valid_dummy_inst1 | mig_7series_v4_2_ddr_carry_and_66 | mig_7series_v4_2_ddr_carry_and
ddr3_ctrl_2port/u_mig_7series_0/u_mig_7series_0_mig/u_memc_ui_top_axi/u_axi_mc/USE_UPSIZER.upsizer_d2/USE_WRITE.write_addr_inst/USE_BURSTS.cmd_queue/USE_FPGA_VALID_WRITE.s_valid_dummy_inst2 | mig_7series_v4_2_ddr_carry_and_67 | mig_7series_v4_2_ddr_carry_and
ddr3_ctrl_2port/u_mig_7series_0/u_mig_7series_0_mig/u_memc_ui_top_axi/u_axi_mc/USE_UPSIZER.upsizer_d2/USE_WRITE.write_addr_inst/USE_BURSTS.cmd_queue/USE_FPGA_VALID_WRITE.valid_write_dummy_inst1 | mig_7series_v4_2_ddr_carry_and_68 | mig_7series_v4_2_ddr_carry_and
ddr3_ctrl_2port/u_mig_7series_0/u_mig_7series_0_mig/u_memc_ui_top_axi/u_axi_mc/USE_UPSIZER.upsizer_d2/USE_WRITE.write_addr_inst/USE_BURSTS.cmd_queue/USE_FPGA_VALID_WRITE.valid_write_dummy_inst2 | mig_7series_v4_2_ddr_carry_and_69 | mig_7series_v4_2_ddr_carry_and
ddr3_ctrl_2port/u_mig_7series_0/u_mig_7series_0_mig/u_memc_ui_top_axi/u_axi_mc/USE_UPSIZER.upsizer_d2/USE_WRITE.write_addr_inst/USE_BURSTS.cmd_queue/USE_FPGA_VALID_WRITE.valid_write_dummy_inst3 | mig_7series_v4_2_ddr_carry_and_70 | mig_7series_v4_2_ddr_carry_and
ddr3_ctrl_2port/u_mig_7series_0/u_mig_7series_0_mig/u_memc_ui_top_axi/u_axi_mc/USE_UPSIZER.upsizer_d2/USE_WRITE.write_addr_inst/USE_BURSTS.cmd_queue/USE_FPGA_VALID_WRITE.valid_write_inst | mig_7series_v4_2_ddr_carry_and_71 | mig_7series_v4_2_ddr_carry_and
ddr3_ctrl_2port/u_mig_7series_0/u_mig_7series_0_mig/u_memc_ui_top_axi/u_axi_mc/USE_UPSIZER.upsizer_d2/USE_WRITE.write_data_inst/USE_FPGA_LAST_WORD.last_beat_curr_word_inst | mig_7series_v4_2_ddr_comparator_sel
ddr3_ctrl_2port/u_mig_7series_0/u_mig_7series_0_mig/u_memc_ui_top_axi/u_axi_mc/USE_UPSIZER.upsizer_d2/USE_WRITE.write_data_inst/USE_FPGA_LAST_WORD.last_beat_inst | mig_7series_v4_2_ddr_comparator_sel_static__parameterized0 | mig_7series_v4_2_ddr_comparator_sel_static
ddr3_ctrl_2port/u_mig_7series_0/u_mig_7series_0_mig/u_memc_ui_top_axi/u_axi_mc/USE_UPSIZER.upsizer_d2/USE_WRITE.write_data_inst/USE_FPGA_LAST_WORD.last_word_inst | mig_7series_v4_2_ddr_carry_and
ddr3_ctrl_2port/u_mig_7series_0/u_mig_7series_0_mig/u_memc_ui_top_axi/u_axi_mc/USE_UPSIZER.upsizer_d2/USE_WRITE.write_data_inst/USE_FPGA_USE_WRAP.last_word_inst2 | mig_7series_v4_2_ddr_carry_and_36 | mig_7series_v4_2_ddr_carry_and
ddr3_ctrl_2port/u_mig_7series_0/u_mig_7series_0_mig/u_memc_ui_top_axi/u_axi_mc/USE_UPSIZER.upsizer_d2/USE_WRITE.write_data_inst/USE_FPGA_USE_WRAP.last_word_inst3 | mig_7series_v4_2_ddr_carry_and_37 | mig_7series_v4_2_ddr_carry_and
ddr3_ctrl_2port/u_mig_7series_0/u_mig_7series_0_mig/u_memc_ui_top_axi/u_axi_mc/USE_UPSIZER.upsizer_d2/USE_WRITE.write_data_inst/USE_FPGA_USE_WRAP.word_complete_next_wrap_stall_inst | mig_7series_v4_2_ddr_carry_latch_and
ddr3_ctrl_2port/u_mig_7series_0/u_mig_7series_0_mig/u_memc_ui_top_axi/u_axi_mc/USE_UPSIZER.upsizer_d2/USE_WRITE.write_data_inst/USE_FPGA_WORD_COMPLETED.last_word_inst_2 | mig_7series_v4_2_ddr_carry_and_38 | mig_7series_v4_2_ddr_carry_and
ddr3_ctrl_2port/u_mig_7series_0/u_mig_7series_0_mig/u_memc_ui_top_axi/u_axi_mc/USE_UPSIZER.upsizer_d2/USE_WRITE.write_data_inst/USE_FPGA_WORD_COMPLETED.next_word_wrap_inst | mig_7series_v4_2_ddr_comparator_sel_static
ddr3_ctrl_2port/u_mig_7series_0/u_mig_7series_0_mig/u_memc_ui_top_axi/u_axi_mc/USE_UPSIZER.upsizer_d2/USE_WRITE.write_data_inst/USE_FPGA_WORD_COMPLETED.pop_si_data_inst | mig_7series_v4_2_ddr_carry_or
ddr3_ctrl_2port/u_mig_7series_0/u_mig_7series_0_mig/u_memc_ui_top_axi/u_axi_mc/USE_UPSIZER.upsizer_d2/USE_WRITE.write_data_inst/USE_FPGA_WORD_COMPLETED.word_complete_next_wrap_inst | mig_7series_v4_2_ddr_carry_and_39 | mig_7series_v4_2_ddr_carry_and
ddr3_ctrl_2port/u_mig_7series_0/u_mig_7series_0_mig/u_memc_ui_top_axi/u_axi_mc/USE_UPSIZER.upsizer_d2/USE_WRITE.write_data_inst/USE_FPGA_WORD_COMPLETED.word_complete_next_wrap_last_inst | mig_7series_v4_2_ddr_carry_and_40 | mig_7series_v4_2_ddr_carry_and
ddr3_ctrl_2port/u_mig_7series_0/u_mig_7series_0_mig/u_memc_ui_top_axi/u_axi_mc/USE_UPSIZER.upsizer_d2/USE_WRITE.write_data_inst/USE_FPGA_WORD_COMPLETED.word_complete_next_wrap_pop_inst | mig_7series_v4_2_ddr_carry_and_41 | mig_7series_v4_2_ddr_carry_and
ddr3_ctrl_2port/u_mig_7series_0/u_mig_7series_0_mig/u_memc_ui_top_axi/u_axi_mc/USE_UPSIZER.upsizer_d2/USE_WRITE.write_data_inst/USE_FPGA_WORD_COMPLETED.word_complete_next_wrap_qual_inst | mig_7series_v4_2_ddr_carry_and_42 | mig_7series_v4_2_ddr_carry_and
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
ddr3_ctrl_2port/u_mig_7series_0/u_mig_7series_0_mig/u_memc_ui_top_axi/u_axi_mc/USE_UPSIZER.upsizer_d2/USE_WRITE.write_data_inst/USE_FPGA_WORD_COMPLETED.next_word_wrap_inst/LUT_LEVEL[2].compare_inst | mig_7series_v4_2_ddr_carry_and_50 | mig_7series_v4_2_ddr_carry_and
ddr3_ctrl_2port/u_mig_7series_0/u_mig_7series_0_mig/u_memc_ui_top_axi/u_axi_mc/USE_UPSIZER.upsizer_d2/mi_register_slice_inst/r_pipe | mig_7series_v4_2_ddr_axic_register_slice__parameterized5 | mig_7series_v4_2_ddr_axic_register_slice
ddr3_ctrl_2port/u_mig_7series_0/u_mig_7series_0_mig/u_memc_ui_top_axi/u_axi_mc/USE_UPSIZER.upsizer_d2/si_register_slice_inst/ar_pipe | mig_7series_v4_2_ddr_axic_register_slice
ddr3_ctrl_2port/u_mig_7series_0/u_mig_7series_0_mig/u_memc_ui_top_axi/u_axi_mc/USE_UPSIZER.upsizer_d2/si_register_slice_inst/aw_pipe | mig_7series_v4_2_ddr_axic_register_slice_35 | mig_7series_v4_2_ddr_axic_register_slice
ddr3_ctrl_2port/u_mig_7series_0/u_mig_7series_0_mig/u_memc_ui_top_axi/u_axi_mc/axi_mc_ar_channel_0/ar_cmd_fsm_0 | mig_7series_v4_2_axi_mc_cmd_fsm
ddr3_ctrl_2port/u_mig_7series_0/u_mig_7series_0_mig/u_memc_ui_top_axi/u_axi_mc/axi_mc_ar_channel_0/axi_mc_cmd_translator_0 | mig_7series_v4_2_axi_mc_cmd_translator__parameterized0 | mig_7series_v4_2_axi_mc_cmd_translator
ddr3_ctrl_2port/u_mig_7series_0/u_mig_7series_0_mig/u_memc_ui_top_axi/u_axi_mc/axi_mc_ar_channel_0/axi_mc_cmd_translator_0/axi_mc_incr_cmd_0 | mig_7series_v4_2_axi_mc_incr_cmd__parameterized0 | mig_7series_v4_2_axi_mc_incr_cmd
ddr3_ctrl_2port/u_mig_7series_0/u_mig_7series_0_mig/u_memc_ui_top_axi/u_axi_mc/axi_mc_ar_channel_0/axi_mc_cmd_translator_0/axi_mc_wrap_cmd_0 | mig_7series_v4_2_axi_mc_wrap_cmd__parameterized0 | mig_7series_v4_2_axi_mc_wrap_cmd
ddr3_ctrl_2port/u_mig_7series_0/u_mig_7series_0_mig/u_memc_ui_top_axi/u_axi_mc/axi_mc_aw_channel_0/aw_cmd_fsm_0 | mig_7series_v4_2_axi_mc_wr_cmd_fsm
ddr3_ctrl_2port/u_mig_7series_0/u_mig_7series_0_mig/u_memc_ui_top_axi/u_axi_mc/axi_mc_aw_channel_0/axi_mc_cmd_translator_0 | mig_7series_v4_2_axi_mc_cmd_translator
ddr3_ctrl_2port/u_mig_7series_0/u_mig_7series_0_mig/u_memc_ui_top_axi/u_axi_mc/axi_mc_aw_channel_0/axi_mc_cmd_translator_0/axi_mc_incr_cmd_0 | mig_7series_v4_2_axi_mc_incr_cmd
ddr3_ctrl_2port/u_mig_7series_0/u_mig_7series_0_mig/u_memc_ui_top_axi/u_axi_mc/axi_mc_aw_channel_0/axi_mc_cmd_translator_0/axi_mc_wrap_cmd_0 | mig_7series_v4_2_axi_mc_wrap_cmd
ddr3_ctrl_2port/u_mig_7series_0/u_mig_7series_0_mig/u_memc_ui_top_axi/u_axi_mc/axi_mc_b_channel_0/bid_fifo_0 | mig_7series_v4_2_axi_mc_fifo
ddr3_ctrl_2port/u_mig_7series_0/u_mig_7series_0_mig/u_memc_ui_top_axi/u_axi_mc/axi_mc_r_channel_0/rd_data_fifo_0 | mig_7series_v4_2_axi_mc_fifo__parameterized0 | mig_7series_v4_2_axi_mc_fifo
ddr3_ctrl_2port/u_mig_7series_0/u_mig_7series_0_mig/u_memc_ui_top_axi/u_axi_mc/axi_mc_r_channel_0/transaction_fifo_0 | mig_7series_v4_2_axi_mc_fifo__parameterized1 | mig_7series_v4_2_axi_mc_fifo
ddr3_ctrl_2port/u_mig_7series_0/u_mig_7series_0_mig/u_memc_ui_top_axi/u_ui_top/ui_cmd0 | mig_7series_v4_2_ui_cmd
ddr3_ctrl_2port/u_mig_7series_0/u_mig_7series_0_mig/u_memc_ui_top_axi/u_ui_top/ui_rd_data0 | mig_7series_v4_2_ui_rd_data
ddr3_ctrl_2port/u_mig_7series_0/u_mig_7series_0_mig/u_memc_ui_top_axi/u_ui_top/ui_wr_data0 | mig_7series_v4_2_ui_wr_data
dvi_encoder/encb | encode
dvi_encoder/encg | encode_27 | encode
dvi_encoder/encr | encode_28 | encode
dvi_encoder/serdes_4b_10to1_inst | serdes_4b_10to1
dvi_pll/inst | dvi_pll_dvi_pll_clk_wiz | dvi_pll_clk_wiz
eth_phy_reg_config_inst/mdio_bit_shift | mdio_bit_shift
evidence_dump_inst/frame_converter | u32_to_bcd_24 | u32_to_bcd
evidence_dump_inst/holding_stream.adapter | uart_stream_adapter_25 | uart_stream_adapter
evidence_dump_inst/timestamp_converter | u32_to_bcd_26 | u32_to_bcd
evidence_eth_tx_inst/crc32_d8 | crc32_d8
evidence_eth_tx_inst/ip_checksum | ip_checksum
evidence_event_queue_inst/queue | event_request_fifo
evidence_health_inst/cap_snapshot | cdc_stats_snapshot__parameterized3 | cdc_stats_snapshot
evidence_health_inst/eth_snapshot | cdc_stats_snapshot__parameterized4 | cdc_stats_snapshot
evidence_health_inst/ui_snapshot | cdc_stats_snapshot__parameterized3_21 | cdc_stats_snapshot
evidence_health_inst/cap_snapshot/bridge | cdc_event_transaction__parameterized4_23 | cdc_event_transaction
evidence_health_inst/eth_snapshot/bridge | cdc_event_transaction__parameterized5 | cdc_event_transaction
evidence_health_inst/ui_snapshot/bridge | cdc_event_transaction__parameterized4_22 | cdc_event_transaction
evidence_identity_inst/identity | event_identity__parameterized0_20 | event_identity
hist_source_time_cdc/bridge | cdc_event_transaction__parameterized3_19 | cdc_event_transaction
history_client_inst/bridge | history_stream_cdc
history_client_inst/epoch | history_stream_epoch
history_client_inst/identity | evidence_epoch_identity
history_client_inst/ingress | history_ordered_ingress
history_client_inst/sampler | history_sample_source
history_client_inst/startup | history_startup_gate
history_client_inst/store | history_scheduled_store
history_client_inst/bridge/fifo | async_fifo
history_client_inst/epoch/barrier | evidence_reset_barrier_18 | evidence_reset_barrier
history_client_inst/identity/identity | event_identity__parameterized0 | event_identity
history_client_inst/sampler/source | history_capture_source
history_client_inst/store/scheduler | history_closed_scheduler
history_client_inst/store/store | history_store_axi
history_client_inst/store/scheduler/journal | history_gap_journal
history_client_inst/store/store/directory | history_reference_directory
history_client_inst/store/store/dma | ddr3_axi_frame_dma
history_client_inst/store/store/reader | history_window_reader
history_client_inst/store/store/writer | history_frame_writer
history_client_inst/store/store/reader/iterator | history_descriptor_reader
history_hr_cdc_inst/fifo | async_fifo__parameterized0_16 | async_fifo
history_pixel_cdc_inst/fifo | async_fifo__parameterized0 | async_fifo
maintenance_endpoint_inst/receiver | maintenance_command_rx
maintenance_endpoint_inst/record_inst | maintenance_record
monitor_snapshot/bridge | cdc_event_transaction__parameterized0 | cdc_event_transaction
overlay_status_inst/text_overlay_inst | text_overlay
overlay_status_inst/text_overlay_inst/char_rom_cn_inst | char_rom_cn
persistent_boot_inst/anchor | rtc_anchor_client
persistent_boot_inst/arbiter | i2c_transaction_arbiter
persistent_boot_inst/config_manager | persistent_config_manager
persistent_boot_inst/gate | persistent_boot_gate
persistent_boot_inst/master | i2c_register_master_13 | i2c_register_master
persistent_boot_inst/setter | pcf8563_setter
persistent_boot_inst/store | eeprom_dualslot_store
persistent_boot_inst/anchor/anchor | rtc_time_anchor
persistent_boot_inst/anchor/record_inst | rtc_anchor_record
persistent_boot_inst/anchor/anchor/reader | pcf8563_reader
persistent_boot_inst/config_manager/proposed | persistent_config_decode_15 | persistent_config_decode
persistent_boot_inst/master/bytes | i2c_byte_master_14 | i2c_byte_master
persistent_boot_inst/setter/reader | pcf8563_reader__parameterized0 | pcf8563_reader
persistent_boot_inst/store/codec | eeprom_record_codec
persistent_boot_inst/store/pages | eeprom_page_writer
phy_health_inst/barrier | evidence_reset_barrier
phy_health_inst/snapshot | cdc_stats_snapshot
phy_health_inst/snapshot/bridge | cdc_event_transaction
pll/inst | pll_pll_clk_wiz | pll_clk_wiz
status_uart_tx_inst/duration_converter | u32_to_bcd
status_uart_tx_inst/frame_converter | u32_to_bcd_10 | u32_to_bcd
status_uart_tx_inst/holding_stream.adapter | uart_stream_adapter
status_uart_tx_inst/remaining_converter | u32_to_bcd_11 | u32_to_bcd
status_uart_tx_inst/timestamp_converter | u32_to_bcd_12 | u32_to_bcd
uart_packet_mux_inst/physical_uart | uart_tx
user_control_inst/g_key[0].key_debounce_inst | key_debounce
user_control_inst/g_key[1].key_debounce_inst | key_debounce_7 | key_debounce
user_control_inst/g_key[2].key_debounce_inst | key_debounce_8 | key_debounce
user_control_inst/g_key[3].key_debounce_inst | key_debounce_9 | key_debounce
voice_interaction_inst/audio | voice_audio_gate
voice_interaction_inst/bus | voice_interaction_bus
voice_interaction_inst/host_endpoint | voice_host_endpoint
voice_interaction_inst/information | voice_info_confirm
voice_interaction_inst/notices | voice_notice_queue
voice_interaction_inst/preparation | voice_exam_interaction
voice_interaction_inst/record | voice_status_record
voice_interaction_inst/bus/bus | i2c_register_master
voice_interaction_inst/bus/bus/bytes | i2c_byte_master
