Mod-queen/examguard-fpga-k230-voice/data/figures/evidence_flow.png

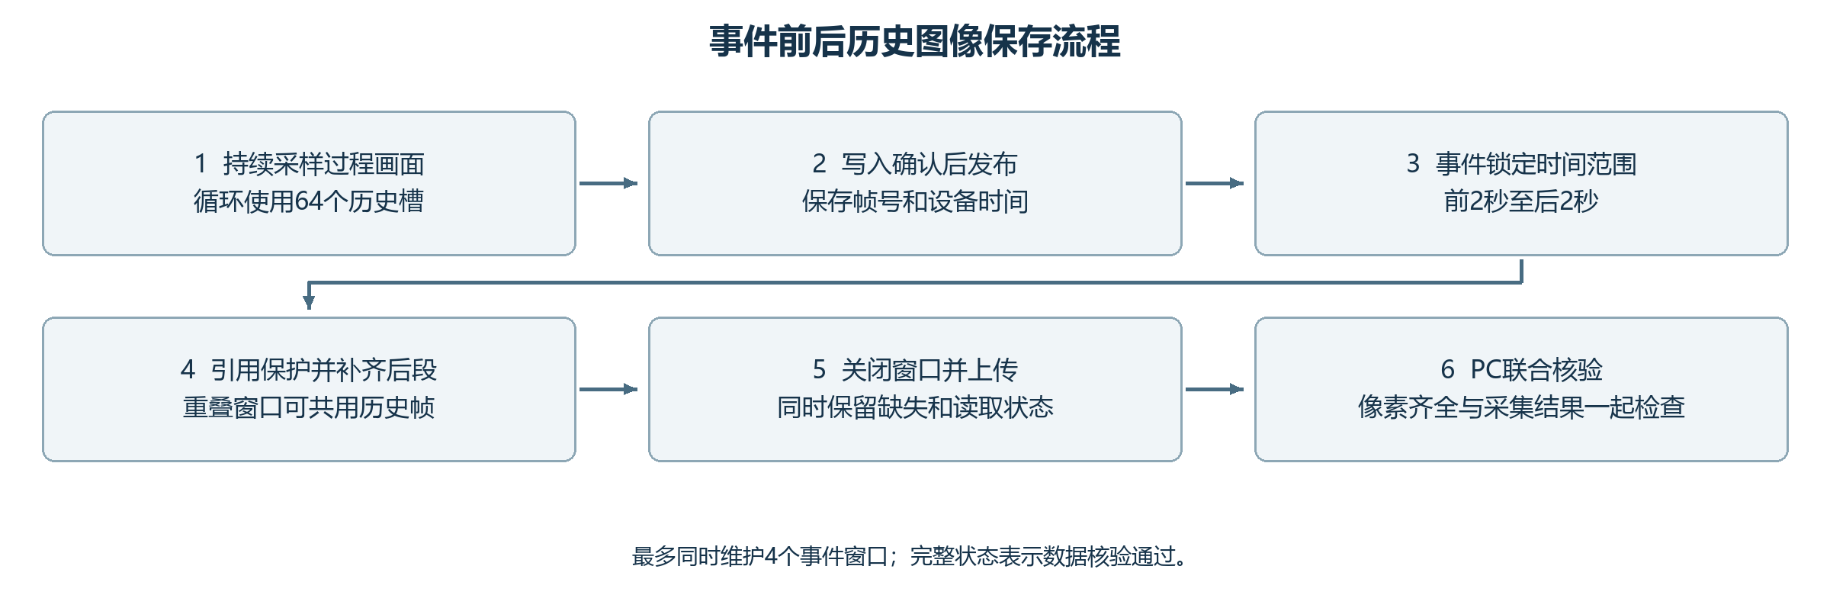
data/figures/evidence_flow.png
