Mod-queen/examguard-fpga-k230-voice/data/figures/k230_flow.png

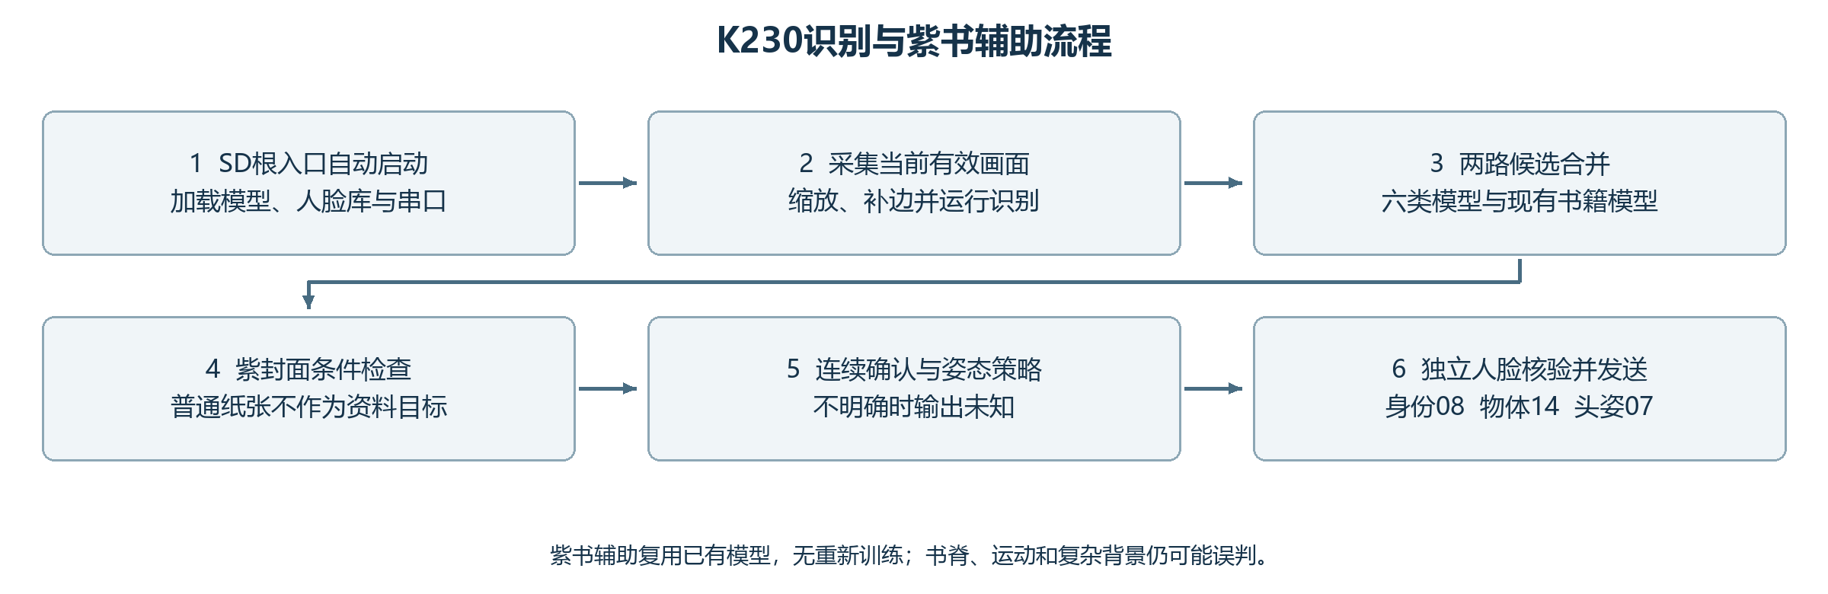
data/figures/k230_flow.png
