Mod-queen/examguard-fpga-k230-voice/data/figures/pc_flow.png

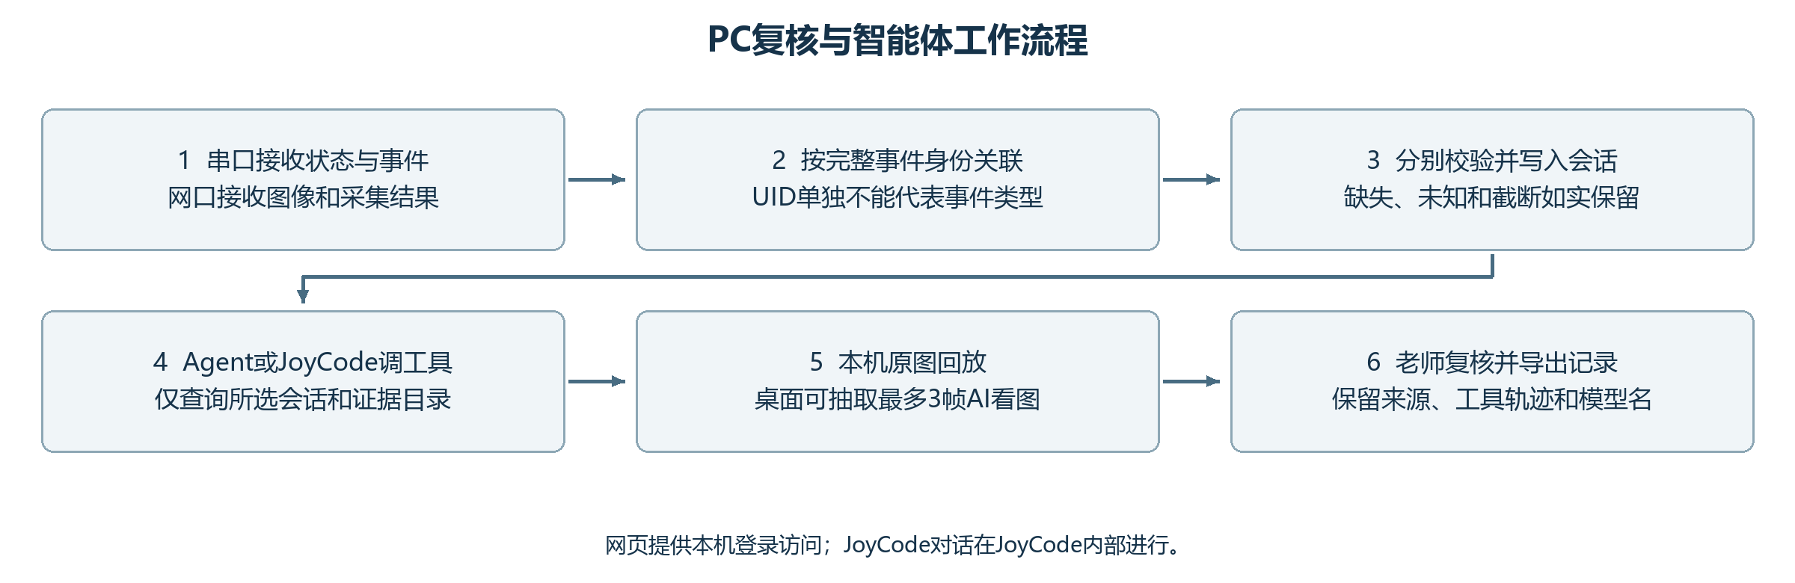
data/figures/pc_flow.png
