Mod-queen/examguard-fpga-k230-voice/data/model_records/field_six320_fit_v1_20261026t143703142303z/high_resolution/learning_rate.png

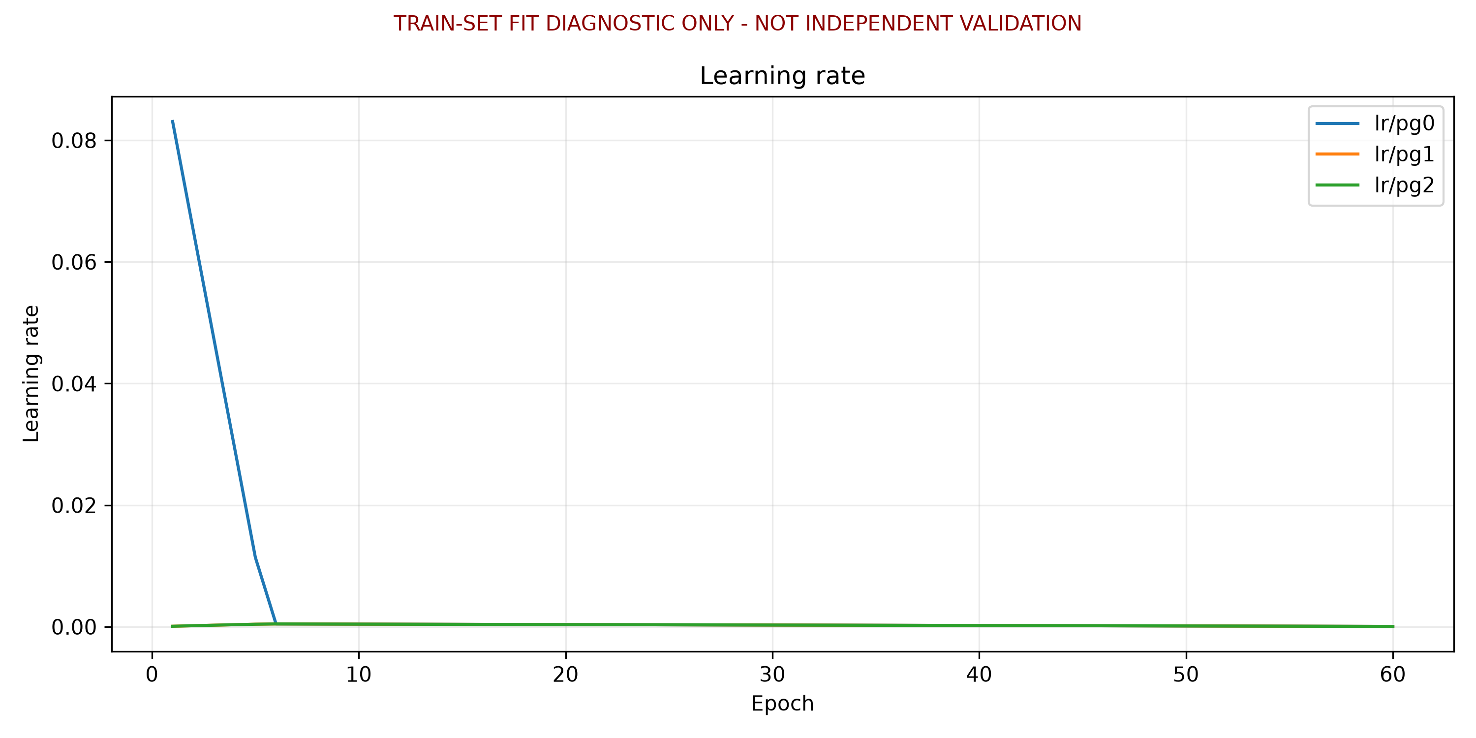
data/model_records/field_six320_fit_v1_20261026t143703142303z/high_resolution/learning_rate.png
