Mod-queen/examguard-fpga-k230-voice/data/model_records/field_six320_fit_v1_20261026t143703142303z/original_training/f1_curve.png

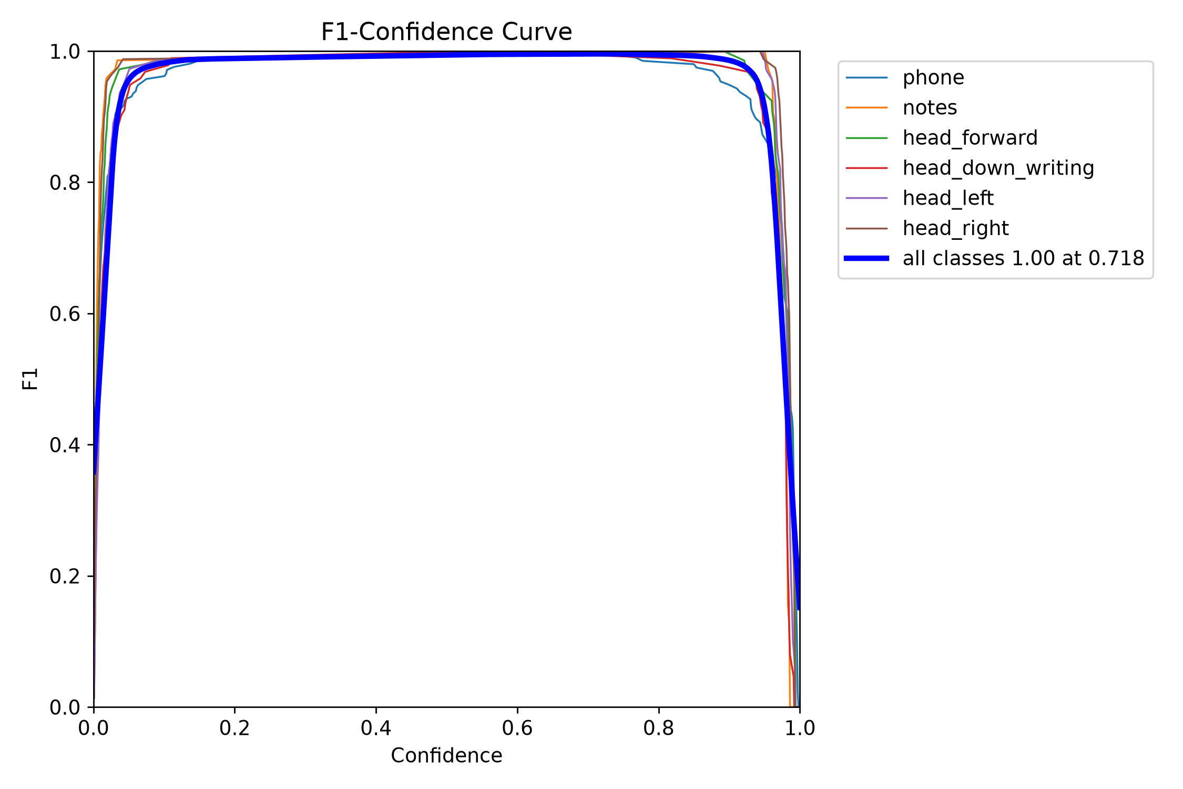
data/model_records/field_six320_fit_v1_20261026t143703142303z/original_training/f1_curve.png
