Mod-queen/examguard-fpga-k230-voice/data/model_records/public_objects320_v2_20261026t112230194049z/high_resolution/loss_curves.png

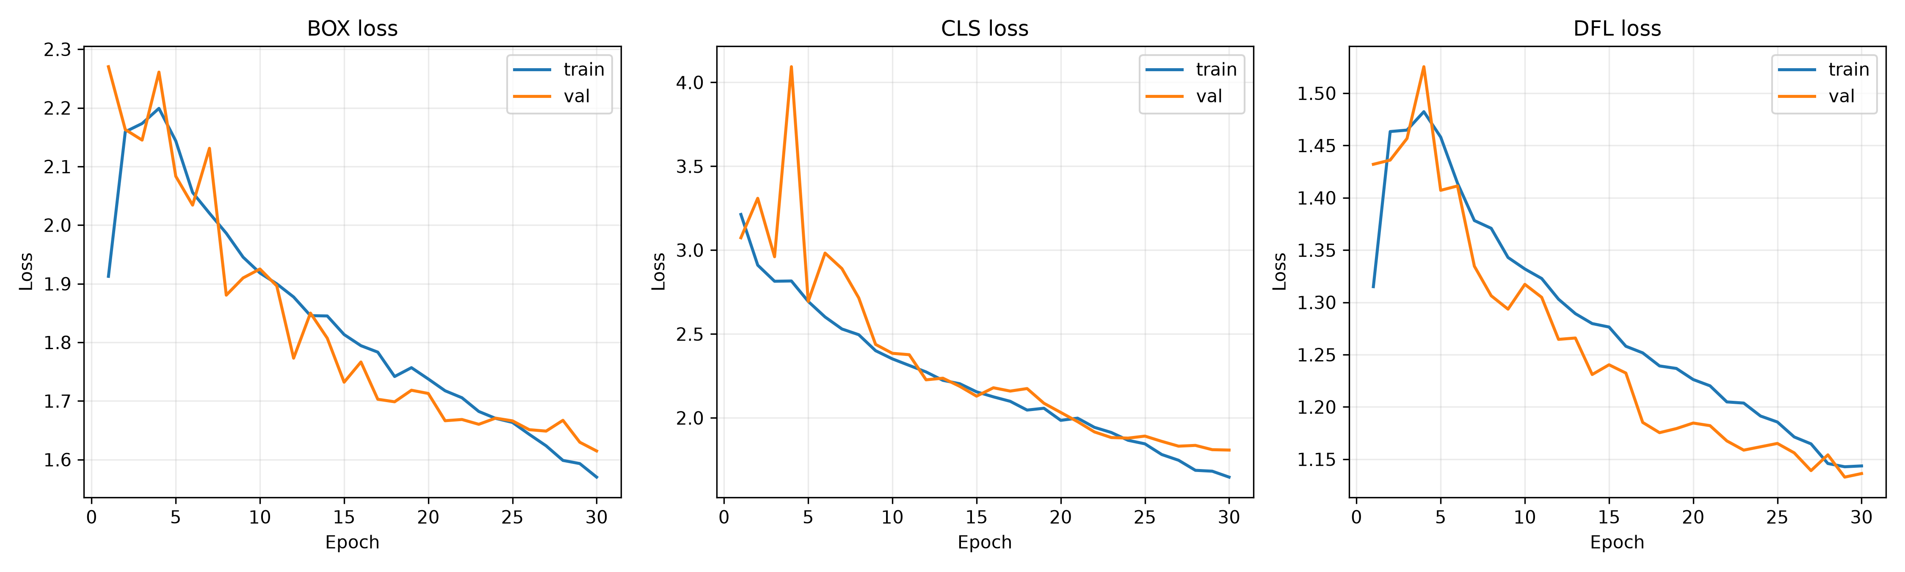
data/model_records/public_objects320_v2_20261026t112230194049z/high_resolution/loss_curves.png
