Mod-queen/examguard-fpga-k230-voice/data/model_records/public_objects320_v2_20261026t112230194049z/original_training/confusion_matrix.png

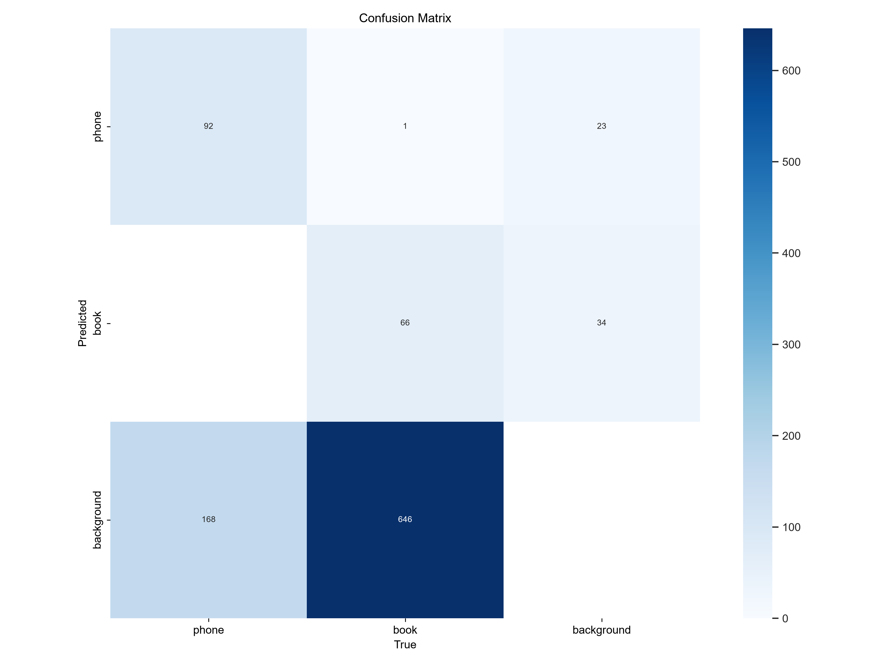
data/model_records/public_objects320_v2_20261026t112230194049z/original_training/confusion_matrix.png
