Mod-queen/examguard-fpga-k230-voice/data/showcase/fpga_detail.jpg

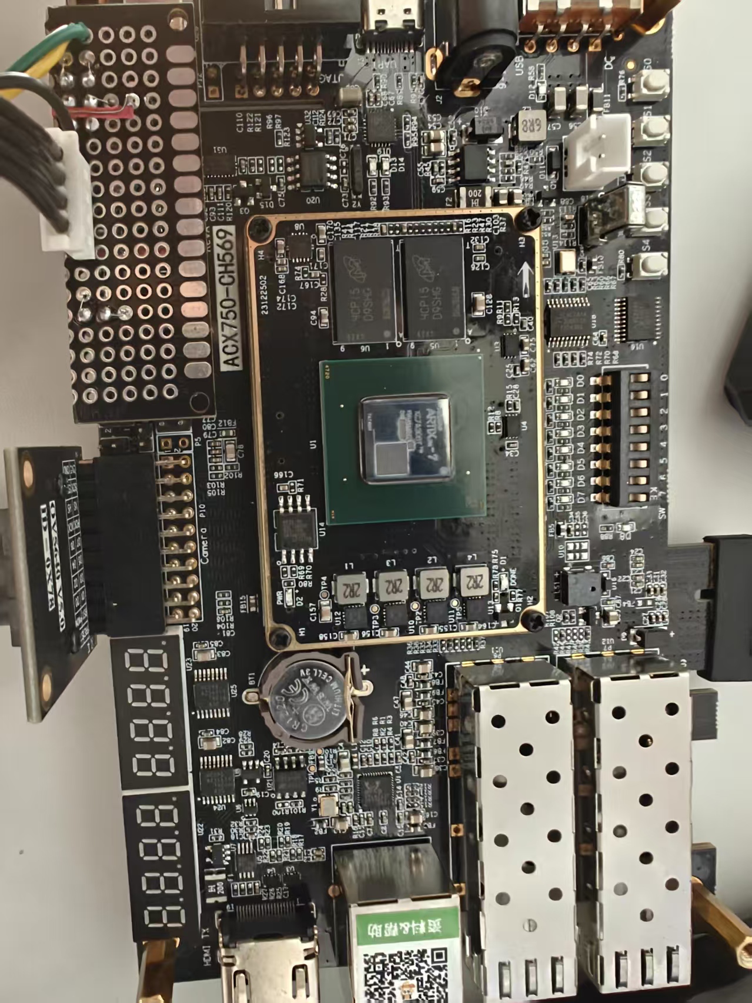
data/showcase/fpga_detail.jpg
