Mod-queen/examguard-fpga-k230-voice/report/figures/revised_20261101/prototype_front.png

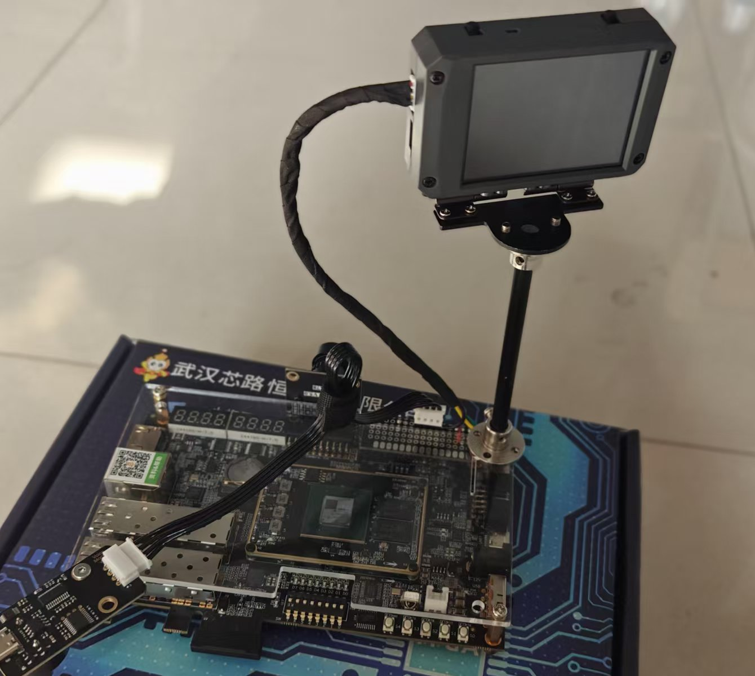
report/figures/revised_20261101/prototype_front.png
