Mod-queen/examguard-fpga-k230-voice/sim/images/implementation/resources/vivado_utilization_summary.png

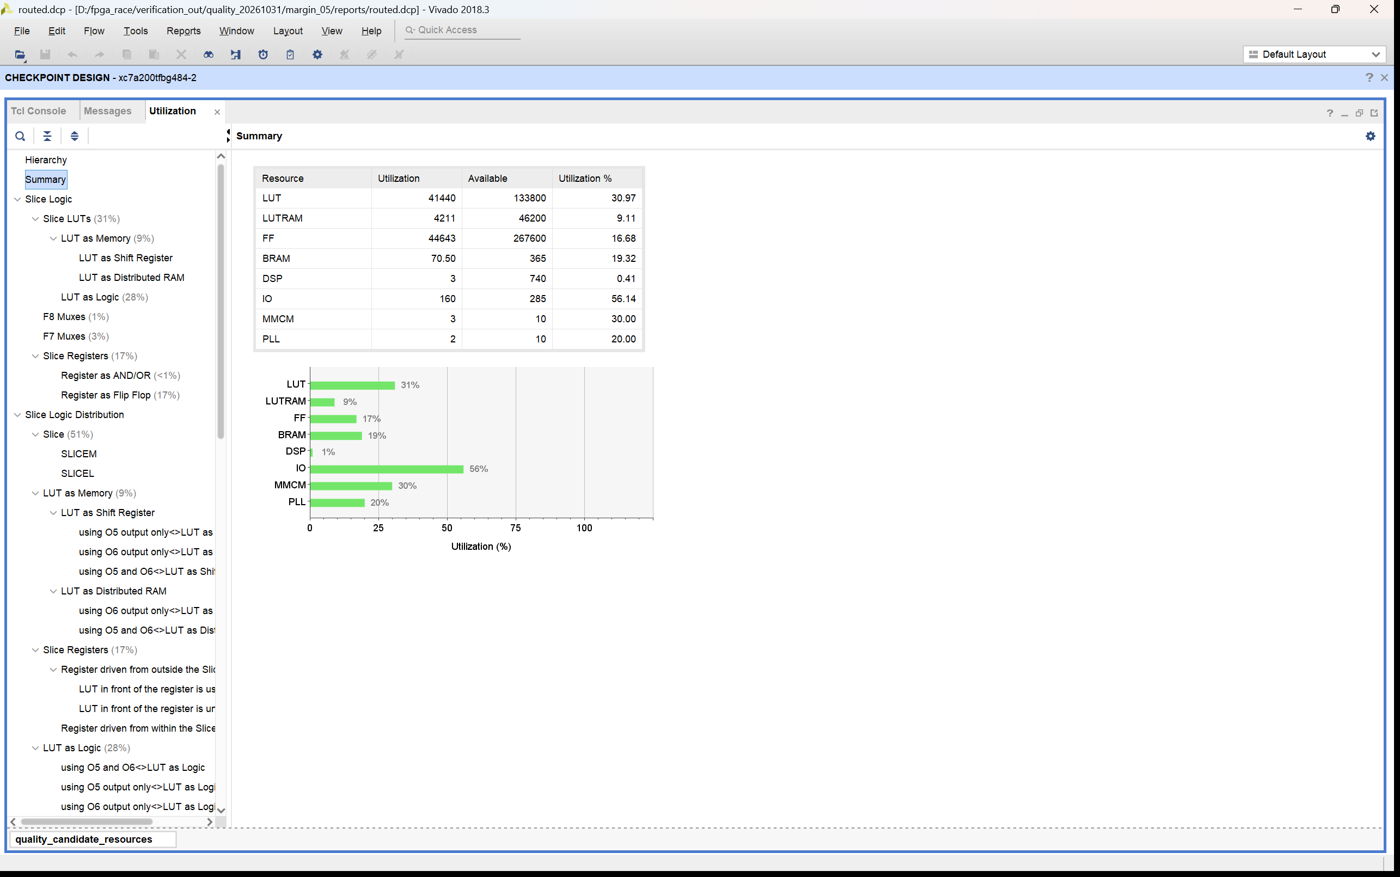
sim/images/implementation/resources/vivado_utilization_summary.png
