Mod-queen/examguard-fpga-k230-voice/sim/images/implementation/timing/vivado_timing_summary.png

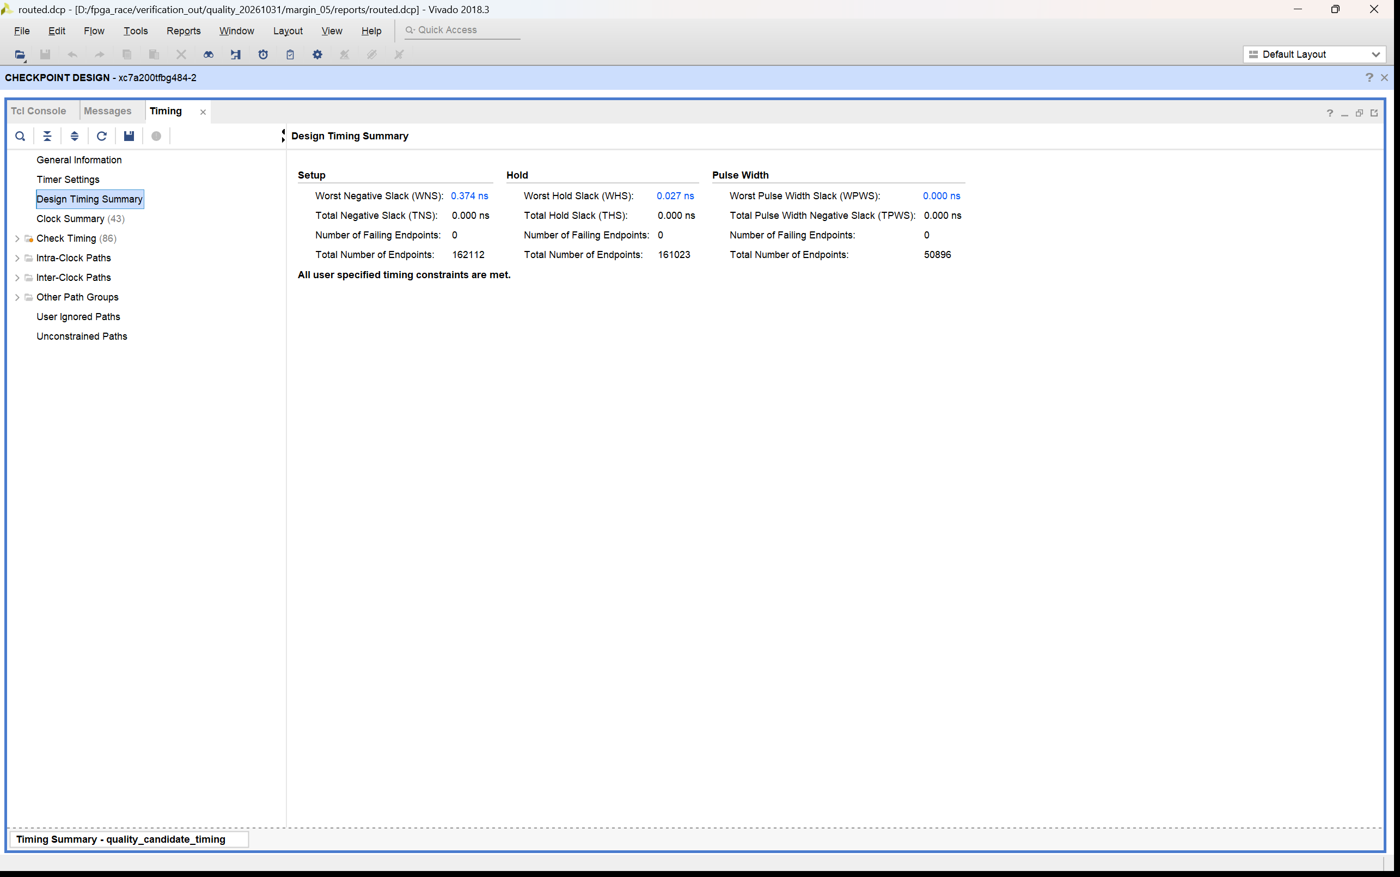
sim/images/implementation/timing/vivado_timing_summary.png
