Mod-queen/examguard-fpga-k230-voice/sim/test_matrix.tsv

测试用例 | 仿真器 | 结论 | 当前模块 | 本轮运行日志 | 历史波形（可选）
ai_link_rx_tb | icarus | 通过 | ai_link_rx | sim/results/quality_current/ai_link_rx_tb/run.log | sim/images/ai_link_rx_tb.png
ai_mailbox_tb | icarus | 通过 | ai_mailbox | sim/results/quality_current/ai_mailbox_tb/run.log | sim/images/ai_mailbox_tb.png
alarm_output_tb | icarus | 通过 | alarm_output | sim/results/quality_current/alarm_output_tb/run.log | sim/images/alarm_output_tb.png
async_fifo_tb | icarus | 通过 | async_fifo | sim/results/quality_current/async_fifo_tb/run.log | sim/images/async_fifo_tb.png
axi_2client_arbiter_tb | icarus | 通过 | axi_2client_arbiter | sim/results/quality_current/axi_2client_arbiter_tb/run.log | sim/images/axi_2client_arbiter_tb.png
axi_2client_policy_tb | icarus | 通过 | axi_2client_arbiter | sim/results/quality_current/axi_2client_policy_tb/run.log | sim/images/axi_2client_policy_tb.png
axi_read_burst_buffer_tb | icarus | 通过 | axi_read_burst_buffer | sim/results/quality_current/axi_read_burst_buffer_tb/run.log | sim/images/axi_read_burst_buffer_tb.png
board_monitor_record_tb | icarus | 通过 | board_monitor_record | sim/results/quality_current/board_monitor_record_tb/run.log | sim/images/board_monitor_record_tb.png
board_monitor_system_tb | xsim | 通过 | board_monitor_record,cdc_event_transaction,cdc_stats_snapshot | sim/results/quality_current/board_monitor_system_tb/run.log | sim/images/board_monitor_system_tb.png
board_status_control_tb | icarus | 通过 | board_status_control | sim/results/quality_current/board_status_control_tb/run.log | sim/images/board_status_control_tb.png
camera_black_720p_tb | icarus | 通过 | camera_black_gate | sim/results/quality_current/camera_black_720p_tb/run.log | sim/images/camera_black_720p_tb.png
camera_black_boundary_tb | icarus | 通过 | camera_black_gate | sim/results/quality_current/camera_black_boundary_tb/run.log | sim/images/camera_black_boundary_tb.png
camera_black_driver_tb | xsim | 通过 | camera_black_gate,color_enhance,disp_driver | sim/results/quality_current/camera_black_driver_tb/run.log | sim/images/camera_black_driver_tb.png
camera_black_noise_tb | icarus | 通过 | camera_black_gate | sim/results/quality_current/camera_black_noise_tb/run.log | sim/images/camera_black_noise_tb.png
camera_capture_reset_tb | icarus | 通过 | DVP_Capture,video_epoch_clear | sim/results/quality_current/camera_capture_reset_tb/run.log | sim/images/camera_capture_reset_tb.png
camera_evidence_axi_tb | xsim | 通过 | async_fifo,camera_frame_guard,ddr3_axi_frame_dma,ddr_evidence_axi | sim/results/quality_current/camera_evidence_axi_tb/run.log | sim/images/camera_evidence_axi_tb.png
camera_evidence_transport_tb | icarus | 通过 | async_fifo,camera_evidence_client,camera_evidence_transport,camera_frame_guard,camera_sample_guard,camera_time_guard,cdc_event_transaction,cdc_stats_snapshot,cdc_time_snapshot,crc32_d8,ddr3_axi_frame_dma,ddr_evidence_axi,ddr_evidence_queued,eth_udp_tx_gmii,event_identity,event_request_fifo,event_transaction_fork,event_transaction_log,event_transaction_queue,evidence_epoch_identity,evidence_event_dispatch,evidence_health_telemetry,evidence_packet_cdc,evidence_packet_udp_bridge,evidence_reset_barrier,evidence_window_packetizer,exam_event_context,exam_fsm,ip_checksum,uart_packet_mux,uart_tx | sim/results/quality_current/camera_evidence_transport_tb/run.log | sim/images/camera_evidence_transport_tb.png
camera_frame_guard_tb | xsim | 通过 | camera_frame_guard | sim/results/quality_current/camera_frame_guard_tb/run.log | sim/images/camera_frame_guard_tb.png
camera_init_audit_tb | icarus | 通过 | camera_init,ov5640_init_table_jpeg,ov5640_init_table_rgb,ov7725_init_table_rgb | sim/results/quality_current/camera_init_audit_tb/run.log | sim/images/camera_init_audit_tb.png
camera_init_contract_tb | xsim | 通过 | camera_init,i2c_bit_shift,i2c_control,ov5640_init_table_jpeg,ov5640_init_table_rgb,ov7725_init_table_rgb | sim/results/quality_current/camera_init_contract_tb/run.log | sim/images/camera_init_contract_tb.png
camera_queued_evidence_tb | xsim | 通过 | async_fifo,camera_frame_guard,ddr3_axi_frame_dma,ddr_evidence_axi,ddr_evidence_queued,evidence_event_dispatch | sim/results/quality_current/camera_queued_evidence_tb/run.log | sim/images/camera_queued_evidence_tb.png
camera_sample_guard_tb | xsim | 通过 | camera_frame_guard,camera_sample_guard | sim/results/quality_current/camera_sample_guard_tb/run.log | sim/images/camera_sample_guard_tb.png
camera_time_guard_tb | icarus | 通过 | camera_frame_guard,camera_sample_guard,camera_time_guard | sim/results/quality_current/camera_time_guard_tb/run.log | sim/images/camera_time_guard_tb.png
candidate_overlay_tb | icarus | 通过 | candidate_glyph,candidate_overlay | sim/results/quality_current/candidate_overlay_tb/run.log | sim/images/candidate_overlay_tb.png
cdc_event_transaction_tb | icarus | 通过 | cdc_event_transaction | sim/results/quality_current/cdc_event_transaction_tb/run.log | sim/images/cdc_event_transaction_tb.png
cdc_exam_status_tb | icarus | 通过 | cdc_exam_status | sim/results/quality_current/cdc_exam_status_tb/run.log | sim/images/cdc_exam_status_tb.png
cdc_frame_activity_tb | icarus | 通过 | cdc_frame_activity | sim/results/quality_current/cdc_frame_activity_tb/run.log | sim/images/cdc_frame_activity_tb.png
cdc_stats_snapshot_tb | icarus | 通过 | cdc_event_transaction,cdc_stats_snapshot,evidence_reset_barrier | sim/results/quality_current/cdc_stats_snapshot_tb/run.log | sim/images/cdc_stats_snapshot_tb.png
cdc_time_snapshot_tb | icarus | 通过 | cdc_event_transaction,cdc_time_snapshot | sim/results/quality_current/cdc_time_snapshot_tb/run.log | sim/images/cdc_time_snapshot_tb.png
compact_identity_tb | icarus | 通过 | candidate_glyph,candidate_overlay,char_rom_cn,text_overlay | sim/results/quality_current/compact_identity_tb/run.log | sim/images/compact_identity_tb.png
config_ack_tx_tb | icarus | 通过 | config_ack_tx,uart_stream_adapter,uart_tx | sim/results/quality_current/config_ack_tx_tb/run.log | sim/images/config_ack_tx_tb.png
config_mailbox_contract_tb | xsim | 通过 | config_mailbox | sim/results/quality_current/config_mailbox_contract_tb/run.log | sim/images/config_mailbox_contract_tb.png
config_parser_contract_tb | xsim | 通过 | config_rx | sim/results/quality_current/config_parser_contract_tb/run.log | sim/images/config_parser_contract_tb.png
ddr3_axi_frame_dma_tb | icarus | 通过 | ddr3_axi_frame_dma | sim/results/quality_current/ddr3_axi_frame_dma_tb/run.log | sim/images/ddr3_axi_frame_dma_tb.png
ddr_evidence_axi_tb | icarus | 通过 | async_fifo,ddr3_axi_frame_dma,ddr_evidence_axi | sim/results/quality_current/ddr_evidence_axi_tb/run.log | sim/images/ddr_evidence_axi_tb.png
ddr_evidence_probe_tb | icarus | 通过 | async_fifo,ddr3_axi_frame_dma,ddr_evidence_axi,uart_tx | sim/results/quality_current/ddr_evidence_probe_tb/run.log | sim/images/ddr_evidence_probe_tb.png
ddr_evidence_queued_tb | xsim | 通过 | async_fifo,ddr3_axi_frame_dma,ddr_evidence_axi,ddr_evidence_queued,evidence_event_dispatch | sim/results/quality_current/ddr_evidence_queued_tb/run.log | sim/images/ddr_evidence_queued_tb.png
display_pipeline_contract_tb | icarus | 通过 | display_output_pipeline | sim/results/quality_current/display_pipeline_contract_tb/run.log
dvi_encoder_contract_tb | xsim | 通过 | dvi_encoder,encode,serdes_4b_10to1 | sim/results/quality_current/dvi_encoder_contract_tb/run.log | sim/images/dvi_encoder_contract_tb.png
dvi_pipeline_contract_tb | xsim | 通过 | dvi_encoder,encode,serdes_4b_10to1,display_output_pipeline | sim/results/quality_current/dvi_pipeline_contract_tb/run.log
dvp_capture_contract_tb | xsim | 通过 | DVP_Capture | sim/results/quality_current/dvp_capture_contract_tb/run.log | sim/images/dvp_capture_contract_tb.png
eeprom_dualslot_store_tb | icarus | 通过 | eeprom_dualslot_store,eeprom_page_writer,eeprom_record_codec | sim/results/quality_current/eeprom_dualslot_store_tb/run.log | sim/images/eeprom_dualslot_store_tb.png
eeprom_page_writer_tb | icarus | 通过 | eeprom_page_writer | sim/results/quality_current/eeprom_page_writer_tb/run.log | sim/images/eeprom_page_writer_tb.png
eeprom_record_codec_tb | icarus | 通过 | eeprom_record_codec | sim/results/quality_current/eeprom_record_codec_tb/run.log | sim/images/eeprom_record_codec_tb.png
event_cdc_evidence_tb | xsim | 通过 | async_fifo,axi_2client_arbiter,axi_read_burst_buffer,camera_evidence_client,camera_frame_guard,camera_sample_guard,cdc_event_transaction,ddr3_axi_frame_dma,ddr_evidence_axi,ddr_evidence_queued,event_request_fifo,event_transaction_queue,evidence_event_dispatch,video_axi_client,video_epoch_clear,video_fifo_axi_port,video_fifo_stream_bridge,video_memory_fabric | sim/results/quality_current/event_cdc_evidence_tb/run.log | sim/images/event_cdc_evidence_tb.png
event_identity_queue_tb | xsim | 通过 | event_identity,event_request_fifo,event_transaction_queue | sim/results/quality_current/event_identity_queue_tb/run.log | sim/images/event_identity_queue_tb.png
event_identity_tb | xsim | 通过 | event_identity | sim/results/quality_current/event_identity_tb/run.log | sim/images/event_identity_tb.png
event_meta_ring_tb | icarus | 通过 | event_meta_ring | sim/results/quality_current/event_meta_ring_tb/run.log | sim/images/event_meta_ring_tb.png
event_request_fifo_optimized_tb | icarus | 通过 | event_request_fifo | sim/results/quality_current/event_request_fifo_optimized_tb/run.log | sim/images/event_request_fifo_optimized_tb.png
event_request_fifo_tb | icarus | 通过 | event_request_fifo | sim/results/quality_current/event_request_fifo_tb/run.log | sim/images/event_request_fifo_tb.png
event_transaction_fork_tb | icarus | 通过 | event_transaction_fork | sim/results/quality_current/event_transaction_fork_tb/run.log | sim/images/event_transaction_fork_tb.png
event_transaction_log_tb | xsim | 通过 | event_transaction_log | sim/results/quality_current/event_transaction_log_tb/run.log | sim/images/event_transaction_log_tb.png
event_transaction_queue_tb | icarus | 通过 | event_request_fifo,event_transaction_queue,exam_fsm | sim/results/quality_current/event_transaction_queue_tb/run.log | sim/images/event_transaction_queue_tb.png
evidence_capture_context_tb | icarus | 通过 | async_fifo,camera_evidence_client,camera_frame_guard,camera_sample_guard,camera_time_guard,cdc_event_transaction,cdc_time_snapshot,ddr3_axi_frame_dma,ddr_evidence_axi,ddr_evidence_queued,evidence_event_dispatch,evidence_window_packetizer | sim/results/quality_current/evidence_capture_context_tb/run.log | sim/images/evidence_capture_context_tb.png
evidence_dump_tb | icarus | 通过 | evidence_dump,u32_to_bcd,uart_stream_adapter,uart_tx | sim/results/quality_current/evidence_dump_tb/run.log | sim/images/evidence_dump_tb.png
evidence_epoch_identity_tb | icarus | 通过 | event_identity,evidence_epoch_identity | sim/results/quality_current/evidence_epoch_identity_tb/run.log | sim/images/evidence_epoch_identity_tb.png
evidence_event_dispatch_tb | icarus | 通过 | evidence_event_dispatch | sim/results/quality_current/evidence_event_dispatch_tb/run.log | sim/images/evidence_event_dispatch_tb.png
evidence_health_telemetry_tb | xsim | 通过 | cdc_event_transaction,cdc_stats_snapshot,evidence_health_telemetry,evidence_reset_barrier | sim/results/quality_current/evidence_health_telemetry_tb/run.log | sim/images/evidence_health_telemetry_tb.png
evidence_packet_cdc_tb | icarus | 通过 | async_fifo,evidence_packet_cdc,evidence_reset_barrier | sim/results/quality_current/evidence_packet_cdc_tb/run.log | sim/images/evidence_packet_cdc_tb.png
evidence_packet_udp_bridge_tb | icarus | 通过 | evidence_packet_udp_bridge | sim/results/quality_current/evidence_packet_udp_bridge_tb/run.log | sim/images/evidence_packet_udp_bridge_tb.png
evidence_reset_barrier_tb | icarus | 通过 | evidence_reset_barrier | sim/results/quality_current/evidence_reset_barrier_tb/run.log | sim/images/evidence_reset_barrier_tb.png
evidence_reset_epoch_tb | icarus | 通过 | async_fifo,cdc_event_transaction | sim/results/quality_current/evidence_reset_epoch_tb/run.log | sim/images/evidence_reset_epoch_tb.png
evidence_window_packetizer_tb | icarus | 通过 | evidence_window_packetizer | sim/results/quality_current/evidence_window_packetizer_tb/run.log | sim/images/evidence_window_packetizer_tb.png
evidence_wrapper_reset_tb | xsim | 通过 | axi_2client_arbiter,axi_read_burst_buffer,ddr3_shared_video_ctrl,evidence_reset_barrier,video_axi_client,video_epoch_clear,video_fifo_axi_port,video_fifo_stream_bridge,video_memory_fabric | sim/results/quality_current/evidence_wrapper_reset_tb/run.log | sim/images/evidence_wrapper_reset_tb.png
exam_event_context_tb | icarus | 通过 | event_identity,event_request_fifo,event_transaction_queue,exam_event_context,exam_fsm | sim/results/quality_current/exam_event_context_tb/run.log | sim/images/exam_event_context_tb.png
exam_fsm_tb | icarus | 通过 | exam_fsm | sim/results/quality_current/exam_fsm_tb/run.log | sim/images/exam_fsm_tb.png
fullscreen_monitor_tb | icarus | 通过 | fullscreen_monitor | sim/results/quality_current/fullscreen_monitor_tb/run.log | sim/images/fullscreen_monitor_tb.png
gmii_rgmii_contract_tb | xsim | 通过 | gmii_to_rgmii | sim/results/quality_current/gmii_rgmii_contract_tb/run.log | sim/images/gmii_rgmii_contract_tb.png
health_monitor_tb | xsim | 通过 | health_monitor | sim/results/quality_current/health_monitor_tb/run.log | sim/images/health_monitor_tb.png
history_axi_epoch_guard_tb | icarus | 通过 | history_axi_epoch_guard,history_lifecycle_control | sim/results/quality_current/history_axi_epoch_guard_tb/run.log | sim/images/history_axi_epoch_guard_tb.png
history_capture_client_tb | icarus | 通过 | async_fifo,cdc_event_transaction,cdc_time_snapshot,ddr3_axi_frame_dma,event_identity,evidence_epoch_identity,evidence_packet_udp_bridge,evidence_reset_barrier,history_axi_epoch_guard,history_capture_client,history_capture_source,history_closed_scheduler,history_descriptor_reader,history_frame_writer,history_gap_journal,history_lifecycle_control,history_ordered_ingress,history_reference_directory,history_result_record,history_result_udp_bridge,history_sample_source,history_scheduled_store,history_startup_gate,history_store_axi,history_stream_cdc,history_stream_epoch,history_window_reader | sim/results/quality_current/history_capture_client_tb/run.log | sim/images/history_capture_client_tb.png
history_capture_full_tb | icarus | 通过 | history_capture_source | sim/results/quality_current/history_capture_full_tb/run.log | sim/images/history_capture_full_tb.png
history_capture_pipeline_tb | icarus | 通过 | async_fifo,ddr3_axi_frame_dma,evidence_reset_barrier,history_capture_source,history_descriptor_reader,history_frame_writer,history_gap_journal,history_ordered_ingress,history_reference_directory,history_sample_source,history_store_axi,history_stream_cdc,history_stream_epoch,history_window_reader | sim/results/quality_current/history_capture_pipeline_tb/run.log | sim/images/history_capture_pipeline_tb.png
history_capture_source_tb | icarus | 通过 | history_capture_source | sim/results/quality_current/history_capture_source_tb/run.log | sim/images/history_capture_source_tb.png
history_descriptor_reader_tb | icarus | 通过 | history_descriptor_reader | sim/results/quality_current/history_descriptor_reader_tb/run.log | sim/images/history_descriptor_reader_tb.png
history_frame_writer_tb | xsim | 通过 | ddr3_axi_frame_dma,history_frame_writer,history_reference_directory | sim/results/quality_current/history_frame_writer_tb/run.log | sim/images/history_frame_writer_tb.png
history_gap_journal_tb | icarus | 通过 | history_gap_journal | sim/results/quality_current/history_gap_journal_tb/run.log | sim/images/history_gap_journal_tb.png
history_health_stats_tb | icarus | 通过 | cdc_event_transaction,cdc_stats_snapshot,evidence_health_telemetry,history_health_stats,status_uart_tx,u32_to_bcd,uart_stream_adapter,uart_tx | sim/results/quality_current/history_health_stats_tb/run.log | sim/images/history_health_stats_tb.png
history_lifecycle_control_tb | icarus | 通过 | history_lifecycle_control | sim/results/quality_current/history_lifecycle_control_tb/run.log | sim/images/history_lifecycle_control_tb.png
history_merge_tb | icarus | 通过 | evidence_byte_mux,history_result_fork | sim/results/quality_current/history_merge_tb/run.log | sim/images/history_merge_tb.png
history_ordered_ingress_tb | icarus | 通过 | ddr3_axi_frame_dma,history_descriptor_reader,history_frame_writer,history_gap_journal,history_ordered_ingress,history_reference_directory,history_store_axi,history_window_reader | sim/results/quality_current/history_ordered_ingress_tb/run.log | sim/images/history_ordered_ingress_tb.png
history_real_display_tb | xsim | 通过 | color_enhance,disp_driver,history_capture_source,history_sample_source | sim/results/quality_current/history_real_display_tb/run.log | sim/images/history_real_display_tb.png
history_reference_directory_tb | xsim | 通过 | history_reference_directory | sim/results/quality_current/history_reference_directory_tb/run.log | sim/images/history_reference_directory_tb.png
history_result_record_tb | icarus | 通过 | history_result_record | sim/results/quality_current/history_result_record_tb/run.log | sim/images/history_result_record_tb.png
history_result_udp_cdc_tb | icarus | 通过 | async_fifo,evidence_packet_cdc,evidence_packet_udp_bridge,history_result_record,history_result_udp_cdc | sim/results/quality_current/history_result_udp_cdc_tb/run.log | sim/images/history_result_udp_cdc_tb.png
history_result_udp_tb | icarus | 通过 | evidence_packet_udp_bridge,history_result_record,history_result_udp_bridge | sim/results/quality_current/history_result_udp_tb/run.log | sim/images/history_result_udp_tb.png
history_sample_source_tb | xsim | 通过 | history_capture_source,history_sample_source | sim/results/quality_current/history_sample_source_tb/run.log | sim/images/history_sample_source_tb.png
history_scheduler_tb | icarus | 通过 | ddr3_axi_frame_dma,history_closed_scheduler,history_descriptor_reader,history_frame_writer,history_gap_journal,history_reference_directory,history_scheduled_store,history_store_axi,history_window_reader | sim/results/quality_current/history_scheduler_tb/run.log | sim/images/history_scheduler_tb.png
history_shared_read_tb | xsim | 通过 | ddr3_axi_frame_dma,history_descriptor_reader,history_reference_directory | sim/results/quality_current/history_shared_read_tb/run.log | sim/images/history_shared_read_tb.png
history_startup_gate_tb | icarus | 通过 | history_startup_gate | sim/results/quality_current/history_startup_gate_tb/run.log | sim/images/history_startup_gate_tb.png
history_store_axi_tb | xsim | 通过 | ddr3_axi_frame_dma,history_descriptor_reader,history_frame_writer,history_reference_directory,history_store_axi,history_window_reader | sim/results/quality_current/history_store_axi_tb/run.log | sim/images/history_store_axi_tb.png
history_stream_cdc_tb | icarus | 通过 | async_fifo,evidence_reset_barrier,history_stream_cdc,history_stream_epoch | sim/results/quality_current/history_stream_cdc_tb/run.log | sim/images/history_stream_cdc_tb.png
history_top_interconnect_tb | xsim | 通过 | async_fifo,cdc_event_transaction,evidence_packet_cdc,pulse_cdc | sim/results/quality_current/history_top_interconnect_tb/run.log | sim/images/history_top_interconnect_tb.png
history_window_reader_tb | xsim | 通过 | ddr3_axi_frame_dma,history_descriptor_reader,history_reference_directory,history_window_reader | sim/results/quality_current/history_window_reader_tb/run.log | sim/images/history_window_reader_tb.png
i2c_byte_master_tb | icarus | 通过 | i2c_byte_master | sim/results/quality_current/i2c_byte_master_tb/run.log | sim/images/i2c_byte_master_tb.png
i2c_register_master_tb | icarus | 通过 | eeprom_page_writer,i2c_byte_master,i2c_register_master,i2c_transaction_arbiter,pcf8563_calendar,pcf8563_reader,rtc_anchor_client,rtc_anchor_record,rtc_time_anchor,uart_tx | sim/results/quality_current/i2c_register_master_tb/run.log | sim/images/i2c_register_master_tb.png
i2c_transaction_arbiter_tb | icarus | 通过 | i2c_transaction_arbiter | sim/results/quality_current/i2c_transaction_arbiter_tb/run.log | sim/images/i2c_transaction_arbiter_tb.png
image_evidence_capture_tb | icarus | 通过 | cdc_byte_channel,image_downsampler,image_evidence_capture,image_evidence_ring,image_evidence_udp_source | sim/results/quality_current/image_evidence_capture_tb/run.log | sim/images/image_evidence_capture_tb.png
image_evidence_ring_tb | icarus | 通过 | image_evidence_ring | sim/results/quality_current/image_evidence_ring_tb/run.log | sim/images/image_evidence_ring_tb.png
image_evidence_udp_packetizer_tb | icarus | 通过 | image_evidence_udp_packetizer | sim/results/quality_current/image_evidence_udp_packetizer_tb/run.log | sim/images/image_evidence_udp_packetizer_tb.png
image_evidence_udp_tx_bridge_tb | icarus | 通过 | image_evidence_udp_packetizer,image_evidence_udp_tx_bridge | sim/results/quality_current/image_evidence_udp_tx_bridge_tb/run.log | sim/images/image_evidence_udp_tx_bridge_tb.png
key_debounce_tb | icarus | 通过 | key_debounce | sim/results/quality_current/key_debounce_tb/run.log | sim/images/key_debounce_tb.png
legacy_video_axi_contract_tb | icarus | 通过 | axi4_to_fifo,fifo_to_axi4 | sim/results/quality_current/legacy_video_axi_contract_tb/run.log | sim/images/legacy_video_axi_contract_tb.png
maintenance_endpoint_tb | xsim | 通过 | maintenance_command_rx,maintenance_endpoint,maintenance_record | sim/results/quality_current/maintenance_endpoint_tb/run.log | sim/images/maintenance_endpoint_tb.png
maintenance_exam_tb | icarus | 通过 | exam_fsm | sim/results/quality_current/maintenance_exam_tb/run.log | sim/images/maintenance_exam_tb.png
maintenance_system_tb | xsim | 通过 | eeprom_dualslot_store,eeprom_page_writer,eeprom_record_codec,i2c_byte_master,i2c_register_master,i2c_transaction_arbiter,maintenance_command_rx,maintenance_endpoint,maintenance_record,pcf8563_calendar,pcf8563_reader,pcf8563_setter,persistent_boot_gate,persistent_config_decode,persistent_config_manager,persistent_maintenance_service,rtc_anchor_client,rtc_anchor_record,rtc_time_anchor | sim/results/quality_current/maintenance_system_tb/run.log | sim/images/maintenance_system_tb.png
mdc_waveform_equivalence_tb | icarus | 通过 |  | sim/results/quality_current/mdc_waveform_equivalence_tb/run.log
mdio_readback_tb | xsim | 通过 | mdio_bit_shift | sim/results/quality_current/mdio_readback_tb/run.log | sim/images/mdio_readback_tb.png
motion_detect_tb | icarus | 通过 | motion_detect | sim/results/quality_current/motion_detect_tb/run.log | sim/images/motion_detect_tb.png
network_isolation_tb | icarus | 通过 | crc32_d8,eth_udp_tx_gmii,evidence_packet_udp_bridge,ip_checksum | sim/results/quality_current/network_isolation_tb/run.log | sim/images/network_isolation_tb.png
operator_alarm_contract_tb | xsim | 通过 | alarm_beep,key_debounce,user_control | sim/results/quality_current/operator_alarm_contract_tb/run.log | sim/images/operator_alarm_contract_tb.png
overlay_status_contract_tb | xsim | 通过 | char_rom_cn,overlay_status,text_overlay | sim/results/quality_current/overlay_status_contract_tb/run.log | sim/images/overlay_status_contract_tb.png
pcf8563_calendar_tb | icarus | 通过 | pcf8563_calendar | sim/results/quality_current/pcf8563_calendar_tb/run.log | sim/images/pcf8563_calendar_tb.png
pcf8563_reader_tb | icarus | 通过 | pcf8563_calendar,pcf8563_reader | sim/results/quality_current/pcf8563_reader_tb/run.log | sim/images/pcf8563_reader_tb.png
pcf8563_setter_tb | xsim | 通过 | pcf8563_calendar,pcf8563_reader,pcf8563_setter | sim/results/quality_current/pcf8563_setter_tb/run.log | sim/images/pcf8563_setter_tb.png
pcf8563_setter_wire_tb | icarus | 通过 | i2c_byte_master,i2c_register_master,pcf8563_calendar,pcf8563_reader,pcf8563_setter | sim/results/quality_current/pcf8563_setter_wire_tb/run.log | sim/images/pcf8563_setter_wire_tb.png
persistent_boot_gate_tb | icarus | 通过 | persistent_boot_gate | sim/results/quality_current/persistent_boot_gate_tb/run.log | sim/images/persistent_boot_gate_tb.png
persistent_boot_probe_tb | xsim | 通过 | eeprom_dualslot_store,eeprom_page_writer,eeprom_record_codec,i2c_byte_master,i2c_register_master,persistent_boot_gate,uart_tx | sim/results/quality_current/persistent_boot_probe_tb/run.log | sim/images/persistent_boot_probe_tb.png
persistent_boot_service_tb | xsim | 通过 | eeprom_dualslot_store,eeprom_page_writer,eeprom_record_codec,event_identity,event_request_fifo,event_transaction_queue,exam_event_context,i2c_byte_master,i2c_register_master,i2c_transaction_arbiter,pcf8563_calendar,pcf8563_reader,persistent_boot_gate,persistent_boot_service,persistent_event_identity,persistent_rtc_service,rtc_anchor_client,rtc_anchor_record,rtc_time_anchor | sim/results/quality_current/persistent_boot_service_tb/run.log | sim/images/persistent_boot_service_tb.png
persistent_config_decode_tb | xsim | 通过 | persistent_config_decode | sim/results/quality_current/persistent_config_decode_tb/run.log | sim/images/persistent_config_decode_tb.png
persistent_config_manager_tb | icarus | 通过 | eeprom_dualslot_store,eeprom_page_writer,eeprom_record_codec,persistent_config_decode,persistent_config_manager | sim/results/quality_current/persistent_config_manager_tb/run.log | sim/images/persistent_config_manager_tb.png
persistent_event_identity_tb | icarus | 通过 | event_identity,event_request_fifo,event_transaction_queue,persistent_event_identity | sim/results/quality_current/persistent_event_identity_tb/run.log | sim/images/persistent_event_identity_tb.png
persistent_maintenance_service_tb | icarus | 通过 | eeprom_dualslot_store,eeprom_page_writer,eeprom_record_codec,i2c_byte_master,i2c_register_master,i2c_transaction_arbiter,pcf8563_calendar,pcf8563_reader,pcf8563_setter,persistent_boot_gate,persistent_config_decode,persistent_config_manager,persistent_maintenance_service,rtc_anchor_client,rtc_anchor_record,rtc_time_anchor | sim/results/quality_current/persistent_maintenance_service_tb/run.log | sim/images/persistent_maintenance_service_tb.png
phy_health_snapshot_tb | xsim | 通过 | cdc_event_transaction,cdc_stats_snapshot,evidence_reset_barrier,phy_health_snapshot | sim/results/quality_current/phy_health_snapshot_tb/run.log | sim/images/phy_health_snapshot_tb.png
phy_qualification_tb | xsim | 通过 | evidence_reset_barrier,mdio_bit_shift,phy_reg_config | sim/results/quality_current/phy_qualification_tb/run.log | sim/images/phy_qualification_tb.png
queued_window_packet_tb | xsim | 通过 | async_fifo,crc32_d8,ddr3_axi_frame_dma,ddr_evidence_axi,ddr_evidence_queued,eth_udp_tx_gmii,evidence_event_dispatch,evidence_packet_cdc,evidence_packet_udp_bridge,evidence_reset_barrier,evidence_window_packetizer,ip_checksum | sim/results/quality_current/queued_window_packet_tb/run.log | sim/images/queued_window_packet_tb.png
ready_source_contract_tb | icarus | 通过 |  | sim/results/quality_current/ready_source_contract_tb/run.log
rtc_anchor_client_tb | icarus | 通过 | pcf8563_calendar,pcf8563_reader,rtc_anchor_client,rtc_anchor_record,rtc_time_anchor | sim/results/quality_current/rtc_anchor_client_tb/run.log | sim/images/rtc_anchor_client_tb.png
rtc_anchor_record_tb | icarus | 通过 | rtc_anchor_record | sim/results/quality_current/rtc_anchor_record_tb/run.log | sim/images/rtc_anchor_record_tb.png
rtc_time_anchor_tb | icarus | 通过 | pcf8563_calendar,pcf8563_reader,rtc_time_anchor | sim/results/quality_current/rtc_time_anchor_tb/run.log | sim/images/rtc_time_anchor_tb.png
scene_guard_tb | xsim | 通过 | camera_black_gate,exam_fsm | sim/results/quality_current/scene_guard_tb/run.log | sim/images/scene_guard_tb.png
seven_seg_tb | icarus | 通过 | hc595_driver,hex8 | sim/results/quality_current/seven_seg_tb/run.log | sim/images/seven_seg_tb.png
shared_evidence_axi_tb | xsim | 通过 | async_fifo,axi_2client_arbiter,ddr3_axi_frame_dma,ddr_evidence_axi,ddr_evidence_queued,evidence_event_dispatch,video_axi_client,video_epoch_clear,video_fifo_stream_bridge | sim/results/quality_current/shared_evidence_axi_tb/run.log | sim/images/shared_evidence_axi_tb.png
shared_xadc_monitor_tb | xsim | 通过 | shared_xadc_monitor,xadc_monitor_reader | sim/results/quality_current/shared_xadc_monitor_tb/run.log | sim/images/shared_xadc_monitor_tb.png
status_mailbox_contract_tb | xsim | 通过 | status_mailbox | sim/results/quality_current/status_mailbox_contract_tb/run.log | sim/images/status_mailbox_contract_tb.png
status_uart_health_tb | xsim | 通过 | status_uart_tx,u32_to_bcd,uart_stream_adapter,uart_tx | sim/results/quality_current/status_uart_health_tb/run.log | sim/images/status_uart_health_tb.png
status_uart_timer_tb | icarus | 通过 | exam_fsm,status_uart_tx,u32_to_bcd,uart_stream_adapter,uart_tx | sim/results/quality_current/status_uart_timer_tb/run.log | sim/images/status_uart_timer_tb.png
timestamp_ms_tb | icarus | 通过 | timestamp_ms | sim/results/quality_current/timestamp_ms_tb/run.log | sim/images/timestamp_ms_tb.png
tmds_decode_contract_tb | xsim | 通过 | encode | sim/results/quality_current/tmds_decode_contract_tb/run.log | sim/images/tmds_decode_contract_tb.png
tmds_serializer_contract_tb | xsim | 通过 | serdes_4b_10to1 | sim/results/quality_current/tmds_serializer_contract_tb/run.log | sim/images/tmds_serializer_contract_tb.png
transaction_uart_integration_tb | xsim | 通过 | board_monitor_record,config_ack_tx,event_request_fifo,event_transaction_fork,event_transaction_log,evidence_dump,maintenance_record,rtc_anchor_record,status_uart_tx,u32_to_bcd,uart_packet_mux,uart_stream_adapter,uart_tx | sim/results/quality_current/transaction_uart_integration_tb/run.log
uart_packet_mux_tb | icarus | 通过 | uart_packet_mux,uart_tx | sim/results/quality_current/uart_packet_mux_tb/run.log | sim/images/uart_packet_mux_tb.png
uart_rx_tb | icarus | 通过 | uart_rx | sim/results/quality_current/uart_rx_tb/run.log | sim/images/uart_rx_tb.png
uart_stream_adapter_tb | icarus | 通过 | uart_stream_adapter | sim/results/quality_current/uart_stream_adapter_tb/run.log | sim/images/uart_stream_adapter_tb.png
video_axi_client_edges_tb | icarus | 通过 | video_axi_client | sim/results/quality_current/video_axi_client_edges_tb/run.log | sim/images/video_axi_client_edges_tb.png
video_axi_client_tb | icarus | 通过 | video_axi_client | sim/results/quality_current/video_axi_client_tb/run.log | sim/images/video_axi_client_tb.png
video_epoch_clear_tb | icarus | 通过 | video_epoch_clear | sim/results/quality_current/video_epoch_clear_tb/run.log | sim/images/video_epoch_clear_tb.png
video_fifo_stream_bridge_tb | xsim | 通过 | video_fifo_stream_bridge | sim/results/quality_current/video_fifo_stream_bridge_tb/run.log | sim/images/video_fifo_stream_bridge_tb.png
video_memory_clear_cross_tb | xsim | 通过 | axi_2client_arbiter,axi_read_burst_buffer,history_axi_epoch_guard,video_axi_client,video_epoch_clear,video_fifo_axi_port,video_fifo_stream_bridge,video_memory_fabric | sim/results/quality_current/video_memory_clear_cross_tb/run.log | sim/images/video_memory_clear_cross_tb.png
video_memory_fabric_tb | xsim | 通过 | async_fifo,axi_2client_arbiter,axi_read_burst_buffer,camera_evidence_client,camera_evidence_transport,camera_frame_guard,camera_sample_guard,camera_time_guard,cdc_event_transaction,cdc_time_snapshot,crc32_d8,ddr3_axi_frame_dma,ddr_evidence_axi,ddr_evidence_queued,eth_udp_tx_gmii,evidence_event_dispatch,evidence_packet_cdc,evidence_packet_udp_bridge,evidence_reset_barrier,evidence_window_packetizer,ip_checksum,video_axi_client,video_epoch_clear,video_fifo_axi_port,video_fifo_stream_bridge,video_memory_fabric | sim/results/quality_current/video_memory_fabric_tb/run.log | sim/images/video_memory_fabric_tb.png
voice_announcer_tb | icarus | 通过 | voice_announcer | sim/results/quality_current/voice_announcer_tb/run.log | sim/images/voice_announcer_tb.png
voice_asr_i2c_tb | icarus | 通过 | voice_asr_i2c,voice_command_map | sim/results/quality_current/voice_asr_i2c_tb/run.log | sim/images/voice_asr_i2c_tb.png
voice_audio_gate_tb | icarus | 通过 | voice_audio_gate | sim/results/quality_current/voice_audio_gate_tb/run.log | sim/images/voice_audio_gate_tb.png
voice_exam_interaction_tb | icarus | 通过 | exam_fsm,voice_exam_interaction,voice_info_confirm | sim/results/quality_current/voice_exam_interaction_tb/run.log | sim/images/voice_exam_interaction_tb.png
voice_host_endpoint_tb | xsim | 通过 | voice_host_endpoint,voice_status_record | sim/results/quality_current/voice_host_endpoint_tb/run.log | sim/images/voice_host_endpoint_tb.png
voice_info_confirm_tb | icarus | 通过 | voice_info_confirm | sim/results/quality_current/voice_info_confirm_tb/run.log | sim/images/voice_info_confirm_tb.png
voice_interaction_bus_tb | icarus | 通过 | i2c_byte_master,i2c_register_master,voice_interaction_bus | sim/results/quality_current/voice_interaction_bus_tb/run.log | sim/images/voice_interaction_bus_tb.png
voice_interaction_system_tb | xsim | 通过 | candidate_glyph,candidate_overlay,cdc_event_transaction,cdc_stats_snapshot,exam_fsm,i2c_byte_master,i2c_register_master,voice_audio_gate,voice_exam_interaction,voice_host_endpoint,voice_info_confirm,voice_interaction_bus,voice_interaction_system,voice_notice_queue,voice_status_record | sim/results/quality_current/voice_interaction_system_tb/run.log | sim/images/voice_interaction_system_tb.png
voice_notice_backlog_tb | icarus | 通过 | voice_notice_queue,voice_audio_gate | sim/results/quality_current/voice_notice_backlog_tb/run.log
voice_notice_queue_tb | icarus | 通过 | voice_notice_queue | sim/results/quality_current/voice_notice_queue_tb/run.log | sim/images/voice_notice_queue_tb.png
voice_uart_eight_tb | icarus | 通过 | uart_packet_mux,uart_tx | sim/results/quality_current/voice_uart_eight_tb/run.log | sim/images/voice_uart_eight_tb.png
workflow_fsm_tb | icarus | 通过 | workflow_fsm | sim/results/quality_current/workflow_fsm_tb/run.log | sim/images/workflow_fsm_tb.png
xadc_monitor_reader_tb | icarus | 通过 | xadc_monitor_reader | sim/results/quality_current/xadc_monitor_reader_tb/run.log | sim/images/xadc_monitor_reader_tb.png
