Mod-queen/examguard-fpga-k230-voice/sim/modules/history_result_record.md

# history_result_record

当前工程实例化：是。关联4个自检用例。

| 用例 | 仿真器 | 当前结果 | 运行日志 | 结果记录 |
| --- | --- | --- | --- | --- |
| history_capture_client_tb | icarus | 通过 | [日志](../../sim/results/quality_current/history_capture_client_tb/run.log) | [记录](../../sim/results/quality_current/history_capture_client_tb/result.json) |
| history_result_record_tb | icarus | 通过 | [日志](../../sim/results/quality_current/history_result_record_tb/run.log) | [记录](../../sim/results/quality_current/history_result_record_tb/result.json) |
| history_result_udp_cdc_tb | icarus | 通过 | [日志](../../sim/results/quality_current/history_result_udp_cdc_tb/run.log) | [记录](../../sim/results/quality_current/history_result_udp_cdc_tb/result.json) |
| history_result_udp_tb | icarus | 通过 | [日志](../../sim/results/quality_current/history_result_udp_tb/run.log) | [记录](../../sim/results/quality_current/history_result_udp_tb/result.json) |

单独重跑本模块关联用例（工程根目录）：

```powershell
python sim/run_module_tests.py --only history_capture_client_tb history_result_record_tb history_result_udp_cdc_tb history_result_udp_tb --vivado-bin "$env:EXAMGUARD_VIVADO_BIN" --iverilog-bin "$env:EXAMGUARD_IVERILOG_BIN"
```

先按[复原说明](../../build/reproduction.md)配置工具。每次生成新的结果目录。

## history_capture_client_tb

用例源码：[history_capture_client_tb.sv](../../sim/sources/ddr3_test/history_capture_client_tb.sv), [axi_frame_slave_model.sv](../../sim/sources/ddr3_test/axi_frame_slave_model.sv)

VCD仿真波形（来源批次见索引）：

history_capture_client_tb

## history_result_record_tb

用例源码：[history_result_record_tb.sv](../../sim/sources/ddr3_test/history_result_record_tb.sv)

VCD仿真波形（来源批次见索引）：

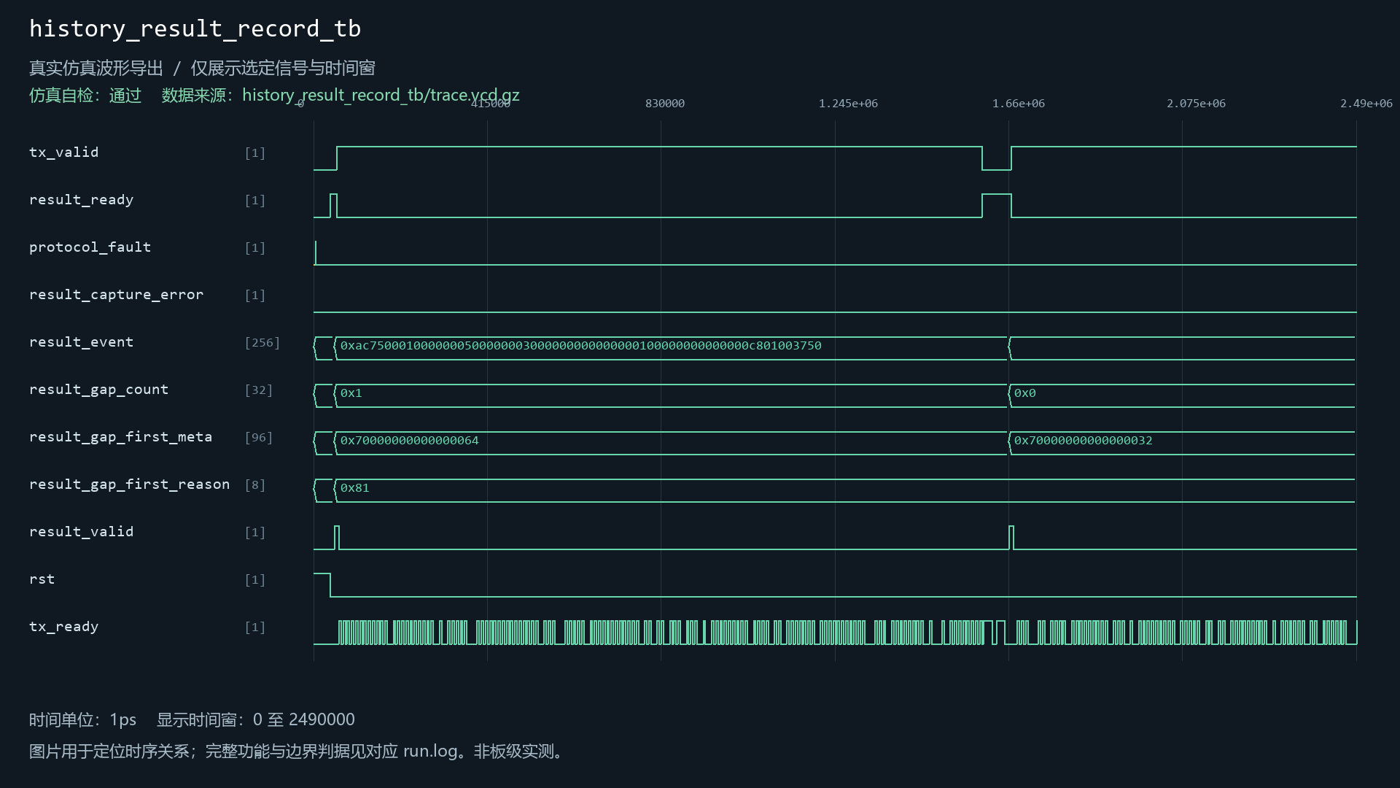
[picture p204: sim/images/history_result_record_tb.png]
history_result_record_tb


## history_result_udp_cdc_tb

用例源码：[history_result_udp_cdc_tb.sv](../../sim/sources/ddr3_test/history_result_udp_cdc_tb.sv)

VCD仿真波形（来源批次见索引）：

history_result_udp_cdc_tb

## history_result_udp_tb

用例源码：[history_result_udp_tb.sv](../../sim/sources/ddr3_test/history_result_udp_tb.sv)

VCD仿真波形（来源批次见索引）：

history_result_udp_tb
