Mod-queen/examguard-fpga-k230-voice/sim/original_logs/agent/test_results_042037_246722.txt

test_save_probe_restart_and_clear_through_panel (app.test_agent_settings.AgentSavedPanelTests.test_save_probe_restart_and_clear_through_panel) ...
