Mod-queen/examguard-fpga-k230-voice/sim/original_logs/agent/test_results_042419_166603.txt

test_save_probe_restart_and_clear_through_panel (app.test_agent_settings.AgentSavedPanelTests.test_save_probe_restart_and_clear_through_panel) ... ok
test_connection_test_requires_both_tool_call_and_final_reply (app.test_agent_settings.AgentSettingsTests.test_connection_test_requires_both_tool_call_and_final_reply) ... ok
test_corrupt_or_wrong_user_config_falls_back_explicitly (app.test_agent_settings.AgentSettingsTests.test_corrupt_or_wrong_user_config_falls_back_explicitly) ... ok
test_environment_override_does_not_send_stored_key_to_other_endpoint (app.test_agent_settings.AgentSettingsTests.test_environment_override_does_not_send_stored_key_to_other_endpoint) ... ok
test_failed_encryption_never_writes_plaintext (app.test_agent_settings.AgentSettingsTests.test_failed_encryption_never_writes_plaintext) ... ok
test_first_run_has_go_presets_but_is_not_connected (app.test_agent_settings.AgentSettingsTests.test_first_run_has_go_presets_but_is_not_connected) ... ok
test_plain_text_or_malformed_response_cannot_pass_tool_probe (app.test_agent_settings.AgentSettingsTests.test_plain_text_or_malformed_response_cannot_pass_tool_probe) ... ok
test_real_dpapi_roundtrip_restart_and_clear (app.test_agent_settings.AgentSettingsTests.test_real_dpapi_roundtrip_restart_and_clear) ... ok
test_unfinished_second_round_is_not_connected (app.test_agent_settings.AgentSettingsTests.test_unfinished_second_round_is_not_connected) ... ok
test_actual_compatible_http_roundtrip_and_redirect_refusal (app.test_agent.AgentControllerTests.test_actual_compatible_http_roundtrip_and_redirect_refusal) ... ok
test_api_address_and_remote_plain_http_are_validated (app.test_agent.AgentControllerTests.test_api_address_and_remote_plain_http_are_validated) ... ok
test_llm_cannot_claim_completion_without_tool_or_after_error (app.test_agent.AgentControllerTests.test_llm_cannot_claim_completion_without_tool_or_after_error) ... ok
test_local_is_explicit_and_does_not_call_api (app.test_agent.AgentControllerTests.test_local_is_explicit_and_does_not_call_api) ... ok
test_real_tool_loop_payload_and_key_redaction (app.test_agent.AgentControllerTests.test_real_tool_loop_payload_and_key_redaction) ... ok
test_secret_echo_in_tool_arguments_is_redacted (app.test_agent.AgentControllerTests.test_secret_echo_in_tool_arguments_is_redacted) ... ok
test_unknown_tools_and_malformed_calls_do_not_gain_controls (app.test_agent.AgentControllerTests.test_unknown_tools_and_malformed_calls_do_not_gain_controls) ... ok
test_portable_record_redacts_nested_secrets_and_keeps_evidence_reference (app.test_agent.AgentExportTests.test_portable_record_redacts_nested_secrets_and_keeps_evidence_reference) ... ok
test_mcp_lists_and_calls_only_readonly_tools (app.test_agent.AgentMCPTests.test_mcp_lists_and_calls_only_readonly_tools) ... ok
test_mcp_stdio_framing_and_lifecycle (app.test_agent.AgentMCPTests.test_mcp_stdio_framing_and_lifecycle) ... ok
test_async_panel_evidence_navigation_and_close (app.test_agent.AgentPanelTests.test_async_panel_evidence_navigation_and_close) ... ok
test_archive_reads_do_not_modify_database_and_time_range_is_honest (app.test_agent.AgentToolTests.test_archive_reads_do_not_modify_database_and_time_range_is_honest) ... ok
test_bad_latest_revision_blocks_old_complete_preview (app.test_agent.AgentToolTests.test_bad_latest_revision_blocks_old_complete_preview) ... ok
test_durable_query_survives_clear_and_deduplicates_et_not_al (app.test_agent.AgentToolTests.test_durable_query_survives_clear_and_deduplicates_et_not_al) ... ok
test_event_uid_never_substitutes_for_event_code_in_evidence_tools (app.test_agent.AgentToolTests.test_event_uid_never_substitutes_for_event_code_in_evidence_tools) ... ok
test_evidence_scope_does_not_claim_absence_outside_selected_directory (app.test_agent.AgentToolTests.test_evidence_scope_does_not_claim_absence_outside_selected_directory) ... ok
test_health_missing_fresh_stale_and_archive_are_distinct (app.test_agent.AgentToolTests.test_health_missing_fresh_stale_and_archive_are_distinct) ... ok
test_joint_complete_requires_hr_and_images_return_actual_frames (app.test_agent.AgentToolTests.test_joint_complete_requires_hr_and_images_return_actual_frames) ... ok
test_limit_scan_is_explicit_not_full_range_count (app.test_agent.AgentToolTests.test_limit_scan_is_explicit_not_full_range_count) ... ok
test_partial_and_hr_only_do_not_become_complete (app.test_agent.AgentToolTests.test_partial_and_hr_only_do_not_become_complete) ... ok
test_uid_ambiguity_and_same_identity_conflict_refuse_binding (app.test_agent.AgentToolTests.test_uid_ambiguity_and_same_identity_conflict_refuse_binding) ... ok
test_unknown_event_and_paths_and_arguments_are_rejected (app.test_agent.AgentToolTests.test_unknown_event_and_paths_and_arguments_are_rejected) ... ok
test_login_attempts_are_limited (app.test_agent.AgentWebTests.test_login_attempts_are_limited) ... ok
test_login_required_csrf_origin_and_logout (app.test_agent.AgentWebTests.test_login_required_csrf_origin_and_logout) ... ok
test_parallel_asks_cannot_clear_another_requests_busy_flag (app.test_agent.AgentWebTests.test_parallel_asks_cannot_clear_another_requests_busy_flag) ... ok
test_query_validated_images_and_no_arbitrary_files (app.test_agent.AgentWebTests.test_query_validated_images_and_no_arbitrary_files) ... ok
test_RA_display_is_separate_from_event_time_and_old_boot_flagged (app.test_dashboard_session.DashboardSessionTests.test_RA_display_is_separate_from_event_time_and_old_boot_flagged) ... ok
test_burst_history_clear_report_and_close_drains_decoded_queue (app.test_dashboard_session.DashboardSessionTests.test_burst_history_clear_report_and_close_drains_decoded_queue) ... ok
test_click_verifies_only_target_archive_not_unrelated_windows (app.test_dashboard_session.DashboardSessionTests.test_click_verifies_only_target_archive_not_unrelated_windows) ... ok
test_countdown_replaces_legacy_channels_and_k230_tab_removed (app.test_dashboard_session.DashboardSessionTests.test_countdown_replaces_legacy_channels_and_k230_tab_removed) ... ok
test_et_before_image_refresh_exact_preview_report_and_context_conflict (app.test_dashboard_session.DashboardSessionTests.test_et_before_image_refresh_exact_preview_report_and_context_conflict) ... ok
test_event_selection_survives_ei_refresh (app.test_dashboard_session.DashboardSessionTests.test_event_selection_survives_ei_refresh) ... ok
test_legacy_alarm_offers_same_boot_new_evidence_without_uid_false_binding (app.test_dashboard_session.DashboardSessionTests.test_legacy_alarm_offers_same_boot_new_evidence_without_uid_false_binding) ... ok
test_legacy_candidates_refuse_cross_boot_and_keep_multiple_choices (app.test_dashboard_session.DashboardSessionTests.test_legacy_candidates_refuse_cross_boot_and_keep_multiple_choices) ... ok
test_new_click_cancels_background_full_scan_and_discards_old_result (app.test_dashboard_session.DashboardSessionTests.test_new_click_cancels_background_full_scan_and_discards_old_result) ... ok
test_new_evidence_health_real_packet_model_and_stale_display (app.test_dashboard_session.DashboardSessionTests.test_new_evidence_health_real_packet_model_and_stale_display) ... ok
test_persistence_error_stays_visible_after_status_refresh (app.test_dashboard_session.DashboardSessionTests.test_persistence_error_stays_visible_after_status_refresh) ... ok
test_transaction_received_persisted_displayed_separate_from_legacy (app.test_dashboard_session.DashboardSessionTests.test_transaction_received_persisted_displayed_separate_from_legacy) ... ok

----------------------------------------------------------------------
Ran 47 tests in 11.569s

OK
