Mod-queen/examguard-fpga-k230-voice/sim/original_logs/agent/test_results_062043_625784.txt

test_cancellation_and_malformed_reply_are_explicit_failures (app.test_agent_vision.AgentVisionTests.test_cancellation_and_malformed_reply_are_explicit_failures) ... ok
test_dual_configuration_roundtrip_and_old_config_compatibility (app.test_agent_vision.AgentVisionTests.test_dual_configuration_roundtrip_and_old_config_compatibility) ... ok
test_maximum_three_frames_and_no_paths_in_cloud_payload (app.test_agent_vision.AgentVisionTests.test_maximum_three_frames_and_no_paths_in_cloud_payload) ... ok
test_modified_after_tool_verification_is_rejected (app.test_agent_vision.AgentVisionTests.test_modified_after_tool_verification_is_rejected) ... ok
test_no_images_or_invalid_evidence_never_calls_model (app.test_agent_vision.AgentVisionTests.test_no_images_or_invalid_evidence_never_calls_model) ... ok
test_visual_probe_uses_only_a_synthetic_image (app.test_agent_vision.AgentVisionTests.test_visual_probe_uses_only_a_synthetic_image) ... ok
test_visual_request_sends_verified_png_bytes_and_keeps_text_model (app.test_agent_vision.AgentVisionTests.test_visual_request_sends_verified_png_bytes_and_keeps_text_model) ... ok
test_zhipu_http_uses_documented_auto_tools_and_disables_thinking (app.test_agent_vision.AgentVisionTests.test_zhipu_http_uses_documented_auto_tools_and_disables_thinking) ... ok

----------------------------------------------------------------------
Ran 8 tests in 0.624s

OK
