Mod-queen/examguard-fpga-k230-voice/sim/original_logs/agent/test_results_062630_327748.txt

test_first_run_has_zhipu_presets_but_is_not_connected (app.test_agent_settings.AgentSettingsTests.test_first_run_has_zhipu_presets_but_is_not_connected) ... ok
test_gui_config_source_switch_event_replay_and_close (app.test_agent_joycode.JoyCodePanelTests.test_gui_config_source_switch_event_replay_and_close) ... ok

----------------------------------------------------------------------
Ran 2 tests in 1.212s

OK
