Mod-queen/examguard-fpga-k230-voice/sim/original_logs/agent/test_results_065513_563450.txt

test_query_select_visual_review_and_export_preserve_event_and_text_model (app.test_agent_vision.AgentDualPanelTests.test_query_select_visual_review_and_export_preserve_event_and_text_model) ... ok

----------------------------------------------------------------------
Ran 1 test in 0.374s

OK
