Mod-queen/examguard-fpga-k230-voice/sim/original_logs/agent/test_results_073600_854314.txt

test_coalesced_raw_eot_then_exactly_one_confirmed_start (app.test_k230_live_startup.LiveStartupTests.test_coalesced_raw_eot_then_exactly_one_confirmed_start) ... ok
test_rejected_installation_or_wrong_boot_never_launches (app.test_k230_live_startup.LiveStartupTests.test_rejected_installation_or_wrong_boot_never_launches) ... ok
test_runtime_selection_is_explicit_and_roundtrips (app.test_k230_live_startup.LiveStartupTests.test_runtime_selection_is_explicit_and_roundtrips) ... ok
test_scene_runtime_binds_marker_and_start_to_the_same_installed_root (app.test_k230_live_startup.LiveStartupTests.test_scene_runtime_binds_marker_and_start_to_the_same_installed_root) ... ok
test_unknown_root_rejected_before_serial_write (app.test_k230_live_startup.LiveStartupTests.test_unknown_root_rejected_before_serial_write) ... ok
test_duplicate_counter_is_not_running_and_original_start_error_is_preserved (app.test_k230_attach.AttachTests.test_duplicate_counter_is_not_running_and_original_start_error_is_preserved) ... ok
test_existing_valid_advancing_stream_attaches_without_any_program_write (app.test_k230_attach.AttachTests.test_existing_valid_advancing_stream_attaches_without_any_program_write) ... ok
test_one_command_service_requests_attach_and_stop_before_probe_does_not_start (app.test_k230_attach.AttachTests.test_one_command_service_requests_attach_and_stop_before_probe_does_not_start) ... ok
test_probe_failure_closes_handle_and_does_not_interrupt (app.test_k230_attach.AttachTests.test_probe_failure_closes_handle_and_does_not_interrupt) ... ok
test_accepts_no_newline_and_cr (app.test_k230_capture.ParseFrameTests.test_accepts_no_newline_and_cr) ... ok
test_empty_line_rejected (app.test_k230_capture.ParseFrameTests.test_empty_line_rejected) ... ok
test_length_mismatch_rejected (app.test_k230_capture.ParseFrameTests.test_length_mismatch_rejected) ... ok
test_missing_delimiters_rejected (app.test_k230_capture.ParseFrameTests.test_missing_delimiters_rejected) ... ok
test_non_digit_algorithm_rejected (app.test_k230_capture.ParseFrameTests.test_non_digit_algorithm_rejected) ... ok
test_vendor_style_face_frame (app.test_k230_capture.ParseFrameTests.test_vendor_style_face_frame) ... ok
test_vendor_style_object_frame (app.test_k230_capture.ParseFrameTests.test_vendor_style_object_frame) ... ok
test_accepts_object_gaze_face_echoes (app.test_k230_runtime.FrameParserTests.test_accepts_object_gaze_face_echoes) ... ok
test_rejects_wrong_length_bad_algorithm_and_free_text (app.test_k230_runtime.FrameParserTests.test_rejects_wrong_length_bad_algorithm_and_free_text) ... ok
test_health_line_is_self_describing_and_reparseable (app.test_k230_runtime.RecognitionHealthTests.test_health_line_is_self_describing_and_reparseable) ... ok
test_rejects_nonpositive_timeouts (app.test_k230_runtime.RecognitionHealthTests.test_rejects_nonpositive_timeouts) ... ok
test_stale_then_recovers_and_nonadvancing_cycle_ignored (app.test_k230_runtime.RecognitionHealthTests.test_stale_then_recovers_and_nonadvancing_cycle_ignored) ... ok
test_startup_timeout_then_running_on_advancing_counter (app.test_k230_runtime.RecognitionHealthTests.test_startup_timeout_then_running_on_advancing_counter) ... ok
test_counts_frames_candidates_colors_perf_and_segments (app.test_k230_runtime.RuntimeSummaryTests.test_counts_frames_candidates_colors_perf_and_segments) ... ok
test_real_launch_log_summarizes_without_claiming_accuracy (app.test_k230_runtime.RuntimeSummaryTests.test_real_launch_log_summarizes_without_claiming_accuracy) ... ok
test_reset_counter_creates_segment_and_equal_cycle_counted (app.test_k230_runtime.RuntimeSummaryTests.test_reset_counter_creates_segment_and_equal_cycle_counted) ... ok
test_quantiles_are_exact_over_samples (app.test_k230_runtime.SamplesTests.test_quantiles_are_exact_over_samples) ... ok
test_absolute_command_paths_no_cwd_and_config_validation (app.test_services.ServicesTests.test_absolute_command_paths_no_cwd_and_config_validation) ... ok
test_actual_image_receiver_stop_file_and_exclusive_port (app.test_services.ServicesTests.test_actual_image_receiver_stop_file_and_exclusive_port) ... ok
test_actual_serial_workers_observe_stop_and_release_owned_port (app.test_services.ServicesTests.test_actual_serial_workers_observe_stop_and_release_owned_port) ... ok
test_dashboard_closes_owned_workers_and_persists_event (app.test_services.ServicesTests.test_dashboard_closes_owned_workers_and_persists_event) ... ok
test_failure_is_visible_and_stop_only_owns_children (app.test_services.ServicesTests.test_failure_is_visible_and_stop_only_owns_children) ... ok
test_image_save_has_separate_graceful_deadline (app.test_services.ServicesTests.test_image_save_has_separate_graceful_deadline) ... ok
test_instance_and_udp_exclusive_release_without_stale_lock (app.test_services.ServicesTests.test_instance_and_udp_exclusive_release_without_stale_lock) ... ok
test_k230_health_states_surface_distinct_recoverable_messages (app.test_services.ServicesTests.test_k230_health_states_surface_distinct_recoverable_messages) ... ok
test_k230_reset_failure_closes_port_without_starting_models (app.test_services.ServicesTests.test_k230_reset_failure_closes_port_without_starting_models) ... ok
test_k230_usb_read_failure_not_masked_by_stop_write_failure (app.test_services.ServicesTests.test_k230_usb_read_failure_not_masked_by_stop_write_failure) ... ok
test_missing_device_manual_start_and_busy_udp_not_stolen (app.test_services.ServicesTests.test_missing_device_manual_start_and_busy_udp_not_stolen) ... ok
test_receiver_emits_liveness_line_for_services_without_hardware (app.test_services.ServicesTests.test_receiver_emits_liveness_line_for_services_without_hardware) ... ok
test_recognition_only_keeps_start_stop_and_does_not_create_evidence (app.test_services.ServicesTests.test_recognition_only_keeps_start_stop_and_does_not_create_evidence) ... ok
test_restored_k230_frames_ready_without_evidence_and_fault_not_cleared (app.test_services.ServicesTests.test_restored_k230_frames_ready_without_evidence_and_fault_not_cleared) ... ok
test_three_owned_children_ready_logs_duplicate_and_graceful_stop (app.test_services.ServicesTests.test_three_owned_children_ready_logs_duplicate_and_graceful_stop) ... ok
test_unresponsive_owned_child_is_terminated_after_graceful_deadline (app.test_services.ServicesTests.test_unresponsive_owned_child_is_terminated_after_graceful_deadline) ... ok

----------------------------------------------------------------------
Ran 42 tests in 2.651s

OK
