Mod-queen/examguard-fpga-k230-voice/sim/original_logs/agent/test_results_075114_146147.txt

test_configuration_reference_is_readonly_and_invalid_reference_not_handed_over (app.test_agent_workflow.DailyProfessionalWorkflowTests.test_configuration_reference_is_readonly_and_invalid_reference_not_handed_over) ... ok
test_corrupt_password_file_and_length_limits (app.test_agent_workflow.DailyProfessionalWorkflowTests.test_corrupt_password_file_and_length_limits) ... ok
test_daily_selected_event_roundtrip_and_stale_source_rejected (app.test_agent_workflow.DailyProfessionalWorkflowTests.test_daily_selected_event_roundtrip_and_stale_source_rejected) ... ok
test_invalid_password_or_encryption_failure_never_starts_a_server (app.test_agent_workflow.DailyProfessionalWorkflowTests.test_invalid_password_or_encryption_failure_never_starts_a_server) ... ok
test_real_generated_password_login_change_and_restart (app.test_agent_workflow.DailyProfessionalWorkflowTests.test_real_generated_password_login_change_and_restart) ... ok
test_gui_config_source_switch_event_replay_and_close (app.test_agent_joycode.JoyCodePanelTests.test_gui_config_source_switch_event_replay_and_close) ... ok
test_follows_exact_selection_and_never_claims_live_online (app.test_agent_joycode.JoyCodeSourceTests.test_follows_exact_selection_and_never_claims_live_online) ... ok
test_generated_config_runs_real_mcp_subprocess_without_writing_session (app.test_agent_joycode.JoyCodeSourceTests.test_generated_config_runs_real_mcp_subprocess_without_writing_session) ... ok
test_heartbeat_expires_and_missing_registration_never_falls_back (app.test_agent_joycode.JoyCodeSourceTests.test_heartbeat_expires_and_missing_registration_never_falls_back) ... ok
test_mcp_source_missing_is_actionable_and_static_source_still_works (app.test_agent_joycode.JoyCodeSourceTests.test_mcp_source_missing_is_actionable_and_static_source_still_works) ... ok
test_old_owner_close_cannot_remove_new_registration (app.test_agent_joycode.JoyCodeSourceTests.test_old_owner_close_cannot_remove_new_registration) ... ok
test_scope_switch_requires_new_query_before_evidence (app.test_agent_joycode.JoyCodeSourceTests.test_scope_switch_requires_new_query_before_evidence) ... ok
test_actual_compatible_http_roundtrip_and_redirect_refusal (app.test_agent.AgentControllerTests.test_actual_compatible_http_roundtrip_and_redirect_refusal) ... ok
test_api_address_and_remote_plain_http_are_validated (app.test_agent.AgentControllerTests.test_api_address_and_remote_plain_http_are_validated) ... ok
test_llm_cannot_claim_completion_without_tool_or_after_error (app.test_agent.AgentControllerTests.test_llm_cannot_claim_completion_without_tool_or_after_error) ... ok
test_local_is_explicit_and_does_not_call_api (app.test_agent.AgentControllerTests.test_local_is_explicit_and_does_not_call_api) ... ok
test_real_tool_loop_payload_and_key_redaction (app.test_agent.AgentControllerTests.test_real_tool_loop_payload_and_key_redaction) ... ok
test_secret_echo_in_tool_arguments_is_redacted (app.test_agent.AgentControllerTests.test_secret_echo_in_tool_arguments_is_redacted) ... ok
test_unknown_tools_and_malformed_calls_do_not_gain_controls (app.test_agent.AgentControllerTests.test_unknown_tools_and_malformed_calls_do_not_gain_controls) ... ok
test_portable_record_redacts_nested_secrets_and_keeps_evidence_reference (app.test_agent.AgentExportTests.test_portable_record_redacts_nested_secrets_and_keeps_evidence_reference) ... ok
test_mcp_lists_and_calls_only_readonly_tools (app.test_agent.AgentMCPTests.test_mcp_lists_and_calls_only_readonly_tools) ... ok
test_mcp_stdio_framing_and_lifecycle (app.test_agent.AgentMCPTests.test_mcp_stdio_framing_and_lifecycle) ... ok
test_async_panel_evidence_navigation_and_close (app.test_agent.AgentPanelTests.test_async_panel_evidence_navigation_and_close) ... ok
test_archive_reads_do_not_modify_database_and_time_range_is_honest (app.test_agent.AgentToolTests.test_archive_reads_do_not_modify_database_and_time_range_is_honest) ... ok
test_bad_latest_revision_blocks_old_complete_preview (app.test_agent.AgentToolTests.test_bad_latest_revision_blocks_old_complete_preview) ... ok
test_durable_query_survives_clear_and_deduplicates_et_not_al (app.test_agent.AgentToolTests.test_durable_query_survives_clear_and_deduplicates_et_not_al) ... ok
test_event_uid_never_substitutes_for_event_code_in_evidence_tools (app.test_agent.AgentToolTests.test_event_uid_never_substitutes_for_event_code_in_evidence_tools) ... ok
test_evidence_scope_does_not_claim_absence_outside_selected_directory (app.test_agent.AgentToolTests.test_evidence_scope_does_not_claim_absence_outside_selected_directory) ... ok
test_health_missing_fresh_stale_and_archive_are_distinct (app.test_agent.AgentToolTests.test_health_missing_fresh_stale_and_archive_are_distinct) ... ok
test_joint_complete_requires_hr_and_images_return_actual_frames (app.test_agent.AgentToolTests.test_joint_complete_requires_hr_and_images_return_actual_frames) ... ok
test_limit_scan_is_explicit_not_full_range_count (app.test_agent.AgentToolTests.test_limit_scan_is_explicit_not_full_range_count) ... ok
test_partial_and_hr_only_do_not_become_complete (app.test_agent.AgentToolTests.test_partial_and_hr_only_do_not_become_complete) ... ok
test_uid_ambiguity_and_same_identity_conflict_refuse_binding (app.test_agent.AgentToolTests.test_uid_ambiguity_and_same_identity_conflict_refuse_binding) ... ok
test_unknown_event_and_paths_and_arguments_are_rejected (app.test_agent.AgentToolTests.test_unknown_event_and_paths_and_arguments_are_rejected) ... ok
test_login_attempts_are_limited (app.test_agent.AgentWebTests.test_login_attempts_are_limited) ... ok
test_login_required_csrf_origin_and_logout (app.test_agent.AgentWebTests.test_login_required_csrf_origin_and_logout) ... ok
test_parallel_asks_cannot_clear_another_requests_busy_flag (app.test_agent.AgentWebTests.test_parallel_asks_cannot_clear_another_requests_busy_flag) ... ok
test_query_validated_images_and_no_arbitrary_files (app.test_agent.AgentWebTests.test_query_validated_images_and_no_arbitrary_files) ... ok
test_save_probe_restart_and_clear_through_panel (app.test_agent_settings.AgentSavedPanelTests.test_save_probe_restart_and_clear_through_panel) ... ok
test_connection_test_requires_both_tool_call_and_final_reply (app.test_agent_settings.AgentSettingsTests.test_connection_test_requires_both_tool_call_and_final_reply) ... ok
test_corrupt_or_wrong_user_config_falls_back_explicitly (app.test_agent_settings.AgentSettingsTests.test_corrupt_or_wrong_user_config_falls_back_explicitly) ... ok
test_environment_override_does_not_send_stored_key_to_other_endpoint (app.test_agent_settings.AgentSettingsTests.test_environment_override_does_not_send_stored_key_to_other_endpoint) ... ok
test_failed_encryption_never_writes_plaintext (app.test_agent_settings.AgentSettingsTests.test_failed_encryption_never_writes_plaintext) ... ok
test_first_run_has_zhipu_presets_but_is_not_connected (app.test_agent_settings.AgentSettingsTests.test_first_run_has_zhipu_presets_but_is_not_connected) ... ok
test_plain_text_or_malformed_response_cannot_pass_tool_probe (app.test_agent_settings.AgentSettingsTests.test_plain_text_or_malformed_response_cannot_pass_tool_probe) ... ok
test_provider_permission_error_is_specific_without_echoing_secrets (app.test_agent_settings.AgentSettingsTests.test_provider_permission_error_is_specific_without_echoing_secrets) ... ok
test_real_dpapi_roundtrip_restart_and_clear (app.test_agent_settings.AgentSettingsTests.test_real_dpapi_roundtrip_restart_and_clear) ... ok
test_unfinished_second_round_is_not_connected (app.test_agent_settings.AgentSettingsTests.test_unfinished_second_round_is_not_connected) ... ok
test_query_select_visual_review_and_export_preserve_event_and_text_model (app.test_agent_vision.AgentDualPanelTests.test_query_select_visual_review_and_export_preserve_event_and_text_model) ... ok
test_cancellation_and_malformed_reply_are_explicit_failures (app.test_agent_vision.AgentVisionTests.test_cancellation_and_malformed_reply_are_explicit_failures) ... ok
test_dual_configuration_roundtrip_and_old_config_compatibility (app.test_agent_vision.AgentVisionTests.test_dual_configuration_roundtrip_and_old_config_compatibility) ... ok
test_maximum_three_frames_and_no_paths_in_cloud_payload (app.test_agent_vision.AgentVisionTests.test_maximum_three_frames_and_no_paths_in_cloud_payload) ... ok
test_modified_after_tool_verification_is_rejected (app.test_agent_vision.AgentVisionTests.test_modified_after_tool_verification_is_rejected) ... ok
test_no_images_or_invalid_evidence_never_calls_model (app.test_agent_vision.AgentVisionTests.test_no_images_or_invalid_evidence_never_calls_model) ... ok
test_service_busy_is_distinct_from_bad_key_and_does_not_echo_provider_text (app.test_agent_vision.AgentVisionTests.test_service_busy_is_distinct_from_bad_key_and_does_not_echo_provider_text) ... ok
test_visual_probe_uses_only_a_synthetic_image (app.test_agent_vision.AgentVisionTests.test_visual_probe_uses_only_a_synthetic_image) ... ok
test_visual_request_sends_verified_png_bytes_and_keeps_text_model (app.test_agent_vision.AgentVisionTests.test_visual_request_sends_verified_png_bytes_and_keeps_text_model) ... ok
test_zhipu_http_uses_documented_auto_tools_and_disables_thinking (app.test_agent_vision.AgentVisionTests.test_zhipu_http_uses_documented_auto_tools_and_disables_thinking) ... ok
test_all_busy_stops_after_three_candidates (app.test_agent_fallback.AgentFallbackTests.test_all_busy_stops_after_three_candidates) ... ok
test_busy_chain_is_bounded_and_keeps_success_for_next_round (app.test_agent_fallback.AgentFallbackTests.test_busy_chain_is_bounded_and_keeps_success_for_next_round) ... ok
test_cancellation_and_deadline_prevent_paid_call (app.test_agent_fallback.AgentFallbackTests.test_cancellation_and_deadline_prevent_paid_call) ... ok
test_connection_probe_keeps_fallback_for_both_rounds (app.test_agent_fallback.AgentFallbackTests.test_connection_probe_keeps_fallback_for_both_rounds) ... ok
test_http_categories_override_status_and_never_echo_key (app.test_agent_fallback.AgentFallbackTests.test_http_categories_override_status_and_never_echo_key) ... ok
test_network_retries_but_invalid_json_does_not (app.test_agent_fallback.AgentFallbackTests.test_network_retries_but_invalid_json_does_not) ... ok
test_no_retry_on_ordinary_tool_error_or_malformed_success (app.test_agent_fallback.AgentFallbackTests.test_no_retry_on_ordinary_tool_error_or_malformed_success) ... ok
test_opt_out_other_provider_or_nonfree_model_never_get_paid_route (app.test_agent_fallback.AgentFallbackTests.test_opt_out_other_provider_or_nonfree_model_never_get_paid_route) ... ok
test_paid_flag_persists_but_old_and_environment_configs_default_off (app.test_agent_fallback.AgentFallbackTests.test_paid_flag_persists_but_old_and_environment_configs_default_off) ... ok
test_paid_model_thinking_and_budget_are_adapted (app.test_agent_fallback.AgentFallbackTests.test_paid_model_thinking_and_budget_are_adapted) ... ok
test_tool_result_and_reasoning_survive_switch_without_rerunning_tools (app.test_agent_fallback.AgentFallbackTests.test_tool_result_and_reasoning_survive_switch_without_rerunning_tools) ... ok
test_visual_fallback_preserves_image_and_reports_actual_model (app.test_agent_fallback.AgentFallbackTests.test_visual_fallback_preserves_image_and_reports_actual_model) ... ok

----------------------------------------------------------------------
Ran 70 tests in 10.719s

OK
