Mod-queen/examguard-fpga-k230-voice/data/model_records/field_six320_fit_v1_20261026t143703142303z/original_training/results.csv

epoch | train/box_loss | train/cls_loss | train/dfl_loss | metrics/precision(B) | metrics/recall(B) | metrics/mAP50(B) | metrics/mAP50-95(B) | val/box_loss | val/cls_loss | val/dfl_loss | lr/pg0 | lr/pg1 | lr/pg2
1 | 1.26 | 3.6848 | 1.3507 | 0.00194 | 0.61402 | 0.04514 | 0.02171 | 1.7213 | 3.6293 | 1.7848 | 0.083085 | 8.5e-05 | 8.5e-05
2 | 0.98401 | 2.9535 | 1.1586 | 0.85983 | 0.11429 | 0.08519 | 0.04309 | 1.7679 | 3.5569 | 1.7591 | 0.065172 | 0.00017238 | 0.00017238
3 | 0.96457 | 2.6126 | 1.1573 | 0.94901 | 0.11883 | 0.24731 | 0.15554 | 1.1465 | 2.9837 | 1.2231 | 0.047257 | 0.00025705 | 0.00025705
4 | 0.90436 | 2.3337 | 1.1115 | 0.51024 | 0.2436 | 0.41618 | 0.32705 | 0.84193 | 2.3022 | 1.0421 | 0.029339 | 0.00033903 | 0.00033903
5 | 0.84311 | 2.099 | 1.0933 | 0.62725 | 0.43057 | 0.54121 | 0.42371 | 0.81207 | 1.8528 | 1.0241 | 0.011418 | 0.0004183 | 0.0004183
6 | 0.81707 | 1.979 | 1.0911 | 0.69673 | 0.57265 | 0.63274 | 0.50834 | 0.72349 | 1.5419 | 0.98172 | 0.0004625 | 0.0004625 | 0.0004625
7 | 0.76879 | 1.8411 | 1.04 | 0.76868 | 0.567 | 0.71344 | 0.58339 | 0.70285 | 1.3967 | 0.97445 | 0.000455 | 0.000455 | 0.000455
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
