Mod-queen/examguard-fpga-k230-voice/data/model_records/public_objects320_v2_20261026t112230194049z/original_training/results.csv

epoch | train/box_loss | train/cls_loss | train/dfl_loss | metrics/precision(B) | metrics/recall(B) | metrics/mAP50(B) | metrics/mAP50-95(B) | val/box_loss | val/cls_loss | val/dfl_loss | lr/pg0 | lr/pg1 | lr/pg2
1 | 1.9126 | 3.2127 | 1.315 | 0.15545 | 0.11846 | 0.06838 | 0.03465 | 2.2702 | 3.0736 | 1.432 | 0.00055336 | 0.00055336 | 0.00055336
2 | 2.1592 | 2.9104 | 1.4633 | 0.18182 | 0.12054 | 0.06754 | 0.03504 | 2.163 | 3.3089 | 1.436 | 0.0010724 | 0.0010724 | 0.0010724
3 | 2.1733 | 2.8144 | 1.4647 | 0.24182 | 0.08498 | 0.07268 | 0.03831 | 2.145 | 2.9605 | 1.4567 | 0.0015548 | 0.0015548 | 0.0015548
4 | 2.1991 | 2.8161 | 1.4823 | 0.17219 | 0.11162 | 0.07862 | 0.0474 | 2.261 | 4.0934 | 1.5253 | 0.001502 | 0.001502 | 0.001502
5 | 2.1436 | 2.694 | 1.458 | 0.2778 | 0.1112 | 0.10363 | 0.0594 | 2.0833 | 2.6942 | 1.4071 | 0.001447 | 0.001447 | 0.001447
6 | 2.0556 | 2.6015 | 1.4139 | 0.31755 | 0.10264 | 0.11047 | 0.06168 | 2.0341 | 2.9823 | 1.4113 | 0.0013919 | 0.0013919 | 0.0013919
7 | 2.0203 | 2.53 | 1.3782 | 0.23585 | 0.12882 | 0.09298 | 0.05489 | 2.131 | 2.8899 | 1.3346 | 0.0013369 | 0.0013369 | 0.0013369
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
