Mod-queen/examguard-fpga-k230-voice/sim/modules/history_axi_epoch_guard.md

# history_axi_epoch_guard

当前工程实例化：是。关联3个自检用例。

| 用例 | 仿真器 | 当前结果 | 运行日志 | 结果记录 |
| --- | --- | --- | --- | --- |
| history_axi_epoch_guard_tb | icarus | 通过 | [日志](../../sim/results/quality_current/history_axi_epoch_guard_tb/run.log) | [记录](../../sim/results/quality_current/history_axi_epoch_guard_tb/result.json) |
| history_capture_client_tb | icarus | 通过 | [日志](../../sim/results/quality_current/history_capture_client_tb/run.log) | [记录](../../sim/results/quality_current/history_capture_client_tb/result.json) |
| video_memory_clear_cross_tb | xsim | 通过 | [日志](../../sim/results/quality_current/video_memory_clear_cross_tb/run.log) | [记录](../../sim/results/quality_current/video_memory_clear_cross_tb/result.json) |

单独重跑本模块关联用例（工程根目录）：

```powershell
python sim/run_module_tests.py --only history_axi_epoch_guard_tb history_capture_client_tb video_memory_clear_cross_tb --vivado-bin "$env:EXAMGUARD_VIVADO_BIN" --iverilog-bin "$env:EXAMGUARD_IVERILOG_BIN"
```

先按[复原说明](../../build/reproduction.md)配置工具。每次生成新的结果目录。

## history_axi_epoch_guard_tb

用例源码：[history_axi_epoch_guard_tb.sv](../../sim/sources/ddr3_test/history_axi_epoch_guard_tb.sv)

VCD仿真波形（来源批次见索引）：

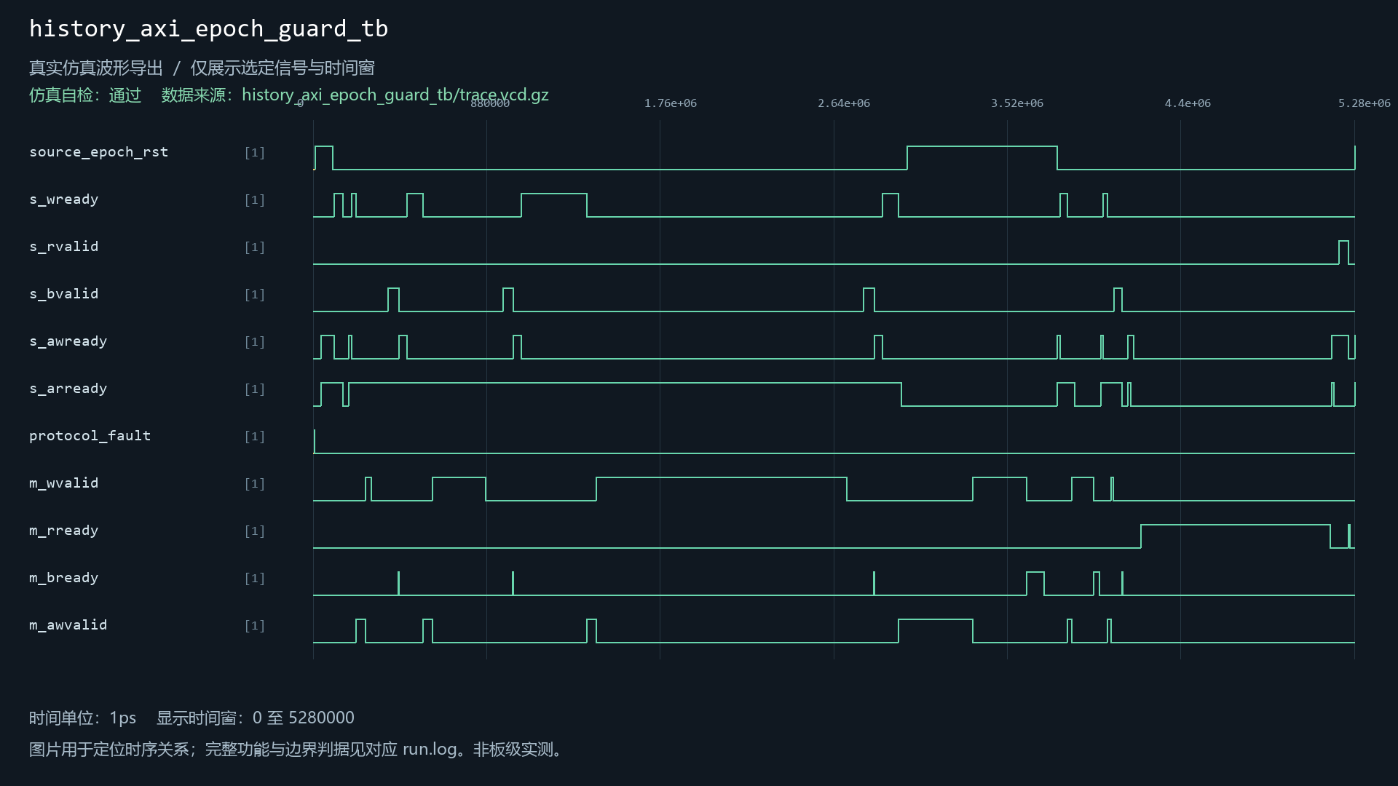
[picture p209: sim/images/history_axi_epoch_guard_tb.png]
history_axi_epoch_guard_tb


## history_capture_client_tb

用例源码：[history_capture_client_tb.sv](../../sim/sources/ddr3_test/history_capture_client_tb.sv), [axi_frame_slave_model.sv](../../sim/sources/ddr3_test/axi_frame_slave_model.sv)

VCD仿真波形（来源批次见索引）：

history_capture_client_tb

## video_memory_clear_cross_tb

用例源码：[video_memory_clear_cross_tb.sv](../../sim/sources/ddr3_test/video_memory_clear_cross_tb.sv), [axi_frame_slave_model.sv](../../sim/sources/ddr3_test/axi_frame_slave_model.sv)

VCD仿真波形（来源批次见索引）：

video_memory_clear_cross_tb
