Mod-queen/examguard-fpga-k230-voice/(commit log)

2026-10-31 Publish complete ExamGuard source, module verification and reproduction workflow
    [asynchronous_input_sinks.tsv, clock_periods.tsv, epochs_long.csv, fifo_storage_paths.tsv, instantiated_modules.tsv, module_matrix.tsv, reset_distribution.tsv, results.csv]
2026-11-01 Document FPGA architecture and verified board release, unify evidence storage and add model showcase
2026-11-01 Update FPGA technical report with current board results and concise abstract
